AxelVoitier/keebs/Handy/README.md

# Handy

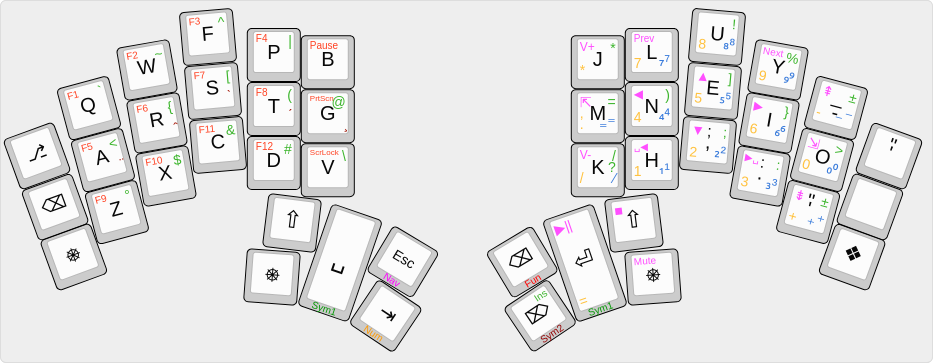
[picture p17: Handy/Handy layout.png]
Handy layout


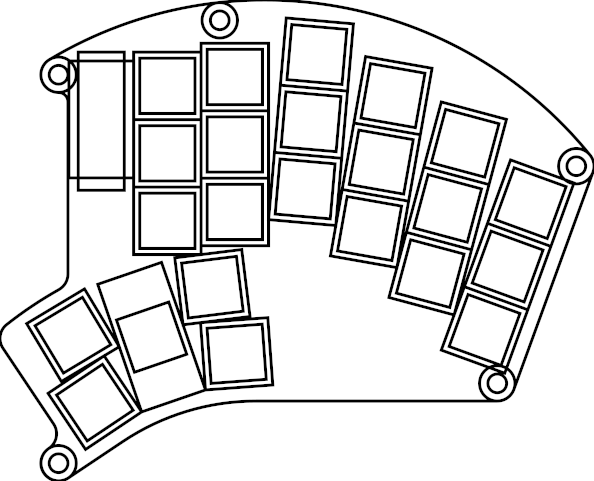
[picture p18: Handy/Handy design.png]
Handy design
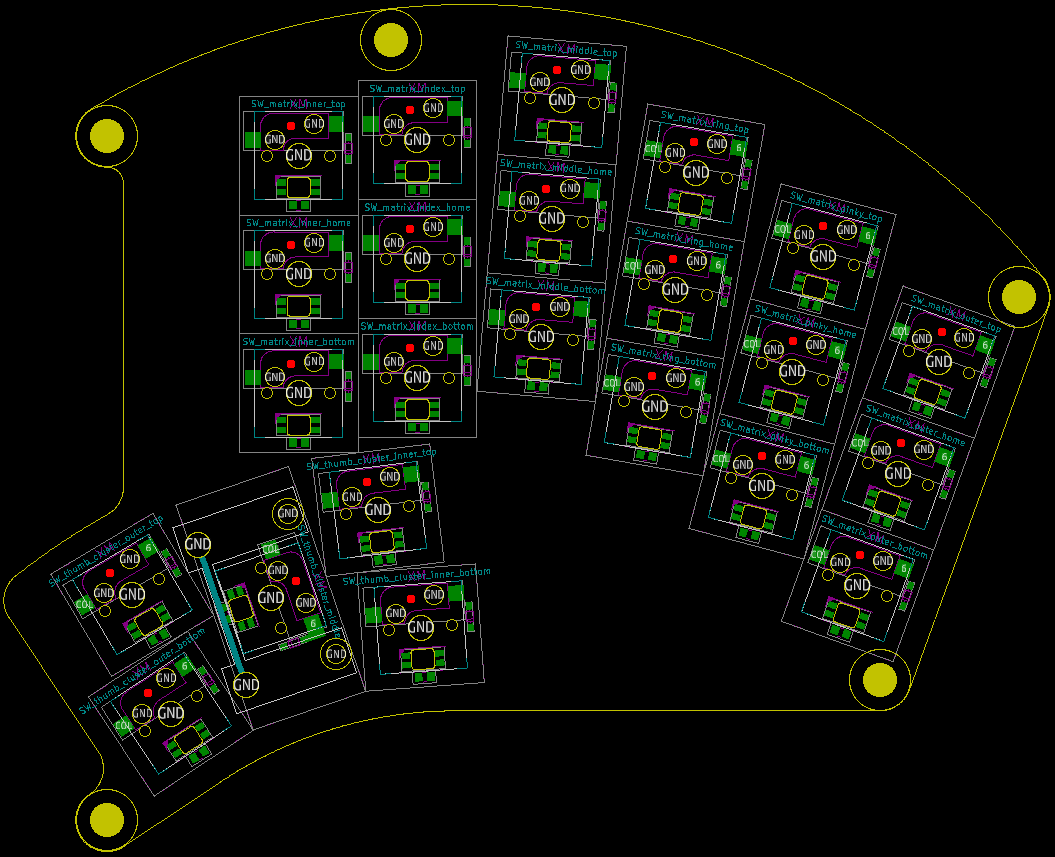
[picture p19: Handy/Handy-PCB.png]
Handy PCB
 

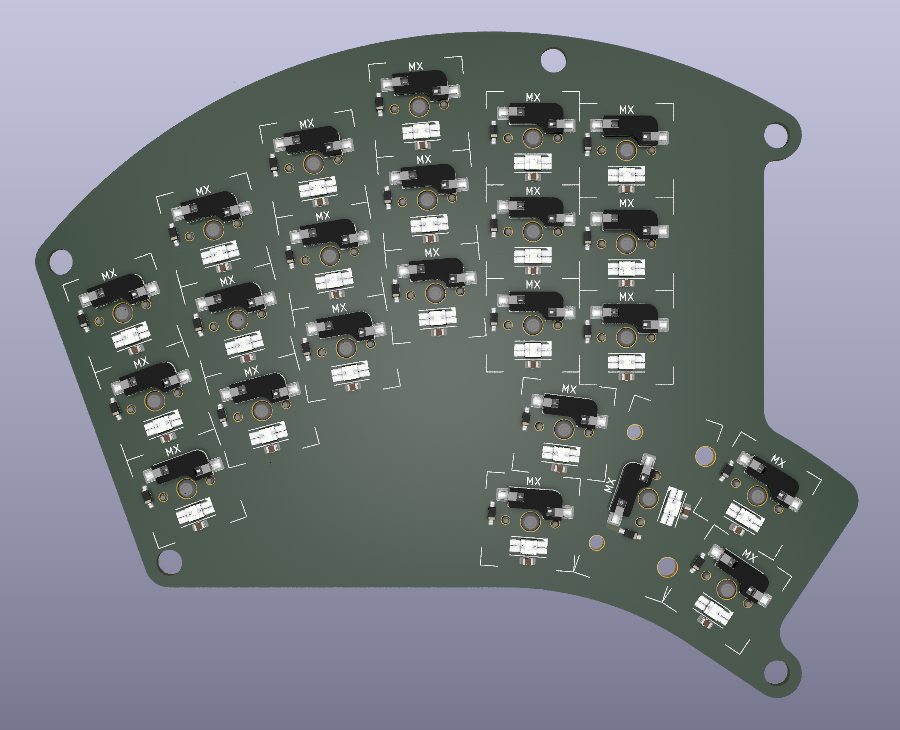
[picture p20: Handy/Handy-PCB-3d-bottom.png]
Handy PCB 3D bottom
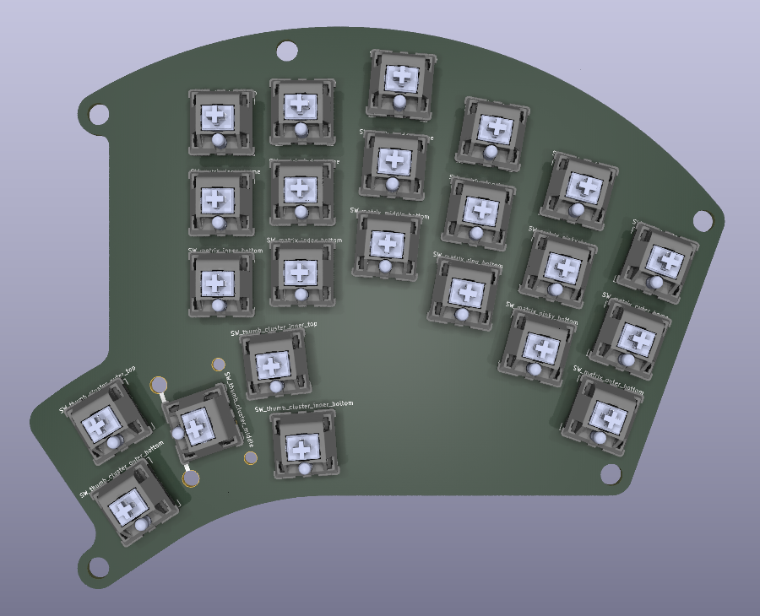
[picture p21: Handy/Handy-PCB-3d-top.png]
Handy PCB 3D top
 

This is a split keyboard with the following properties:

- 3*6 alphas matrices
- Splayed middle, ring, pinky and outer columns (5-10-15-20 in absolute angles, or 5-5-5-5 in relative (ie. stacked) angles)
- Angled thumb cluster, 2*3 with central/home being a 2u.
- Thumb home is below the inner alphas column, slightly outward
- ~~Navigation clusters, 1-2-1 "cross", on both sides~~ (Removed as I found it confusing and ugly, see old layout [here](Handy%20layout%20old%20nav%20cluster.png))
- PCB, switch plate and bottom plate made using PCB fabs
- Tenting with either screws or [puck](https://splitkb.com/collections/keyboard-parts/products/tenting-puck)
- Hotswap support for MX or Choc v1 switches
- Support addressable LEDs
- Parametric and procedural design
  - Master design written with [ergogen](https://github.com/ergogen/ergogen/tree/master)
  - Custom scripting for:
    - Preprocessing some of the most complex points in ergogen master file
    - [KLE](http://www.keyboard-layout-editor.com/) layout
    - [KiCAD](https://www.kicad.org/) generation and update
    - [QMK](https://qmk.fm/) firmware generation
  - Low profile variant regenerated from scratch with Choc spacing

## Files

### Ergogen

- [Handy.yaml](Handy.yaml): Master design file, actually generated by merging these:
  - [Handy-01-layout.yaml](Handy-01-layout.yaml)
  - [Handy-02-fabrication.yaml](Handy-02-fabrication.yaml)
  - [Handy-03-keymap.yaml](Handy-03-keymap.yaml)
  - [Handy-04-firmware.yaml](Handy-04-firmware.yaml)
  - [Handy-05-preprocessed.yaml](Handy-05-preprocessed.yaml)
- [Handy design.png](Handy%20design.png): Design from ergogen
- [points.yaml](ergogen-output/points/points.yaml): Generated output
- [units.yaml](ergogen-output/points/units.yaml): Generated output

### Keyboard Layout Editor

- [Handy.json](Handy.json): Generated from master ergogen file
- [Handy layout.png](Handy%20layout.png): Layout image generated by KLE
- [Handy layout old nav cluster.png](Handy%20layout%20old%20nav%20cluster.png): Older layout using a nav cluster

### KiCad

- [Handy PCB project](PCB): Generated in most parts, rest (eg. routing) is manual
- [Ergogen.pretty](Ergogen.pretty): Outlines generated by Ergogen and converted into footprints by scripts
- [../Footprints.pretty](../Footprints.pretty): Other footprints used in this project

### Custom scripting

- [../keebs.py](../keebs.py): Python CLI, main entry
- [../ergogen.py](../ergogen.py): Parsing of Ergogen input and output files
- [../kicad.py](../kicad.py): Parser, generator and updater of KiCAD board, footprints, schematics, and other files
- [../kle.py](../kle.py): Generator for KLE JSON file
- [../qmk.py](../qmk.py): Generator for QMK info and keymap files
