AxelVoitier/keebs/Framework/HandyWork-5x3-with-mods-with-nav/README.md

# HandyWork 5x3 with modifier keys and central navigation keys

## Example keymap

Example QWERTY keymap

With layers:
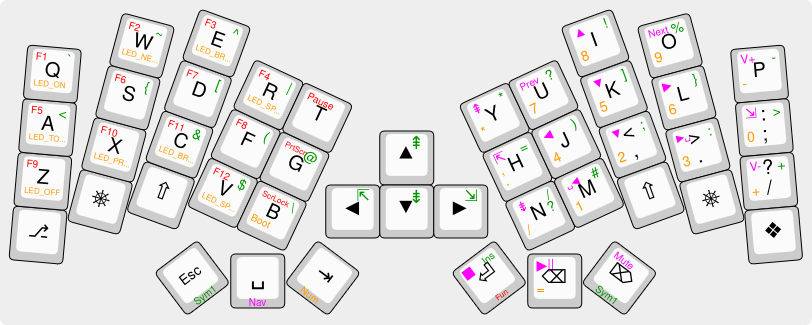
[picture p22: Framework/HandyWork-5x3-with-mods-with-nav/HandyWork-5x3-with-mods-with-nav-keymap-full.png]
Example QWERTY keymap full


## Physical layout

[Printable test layout](HandyWork-5x3-with-mods-with-nav-layout.pdf)

Fits Framework 16 A1 design space.



## PCB

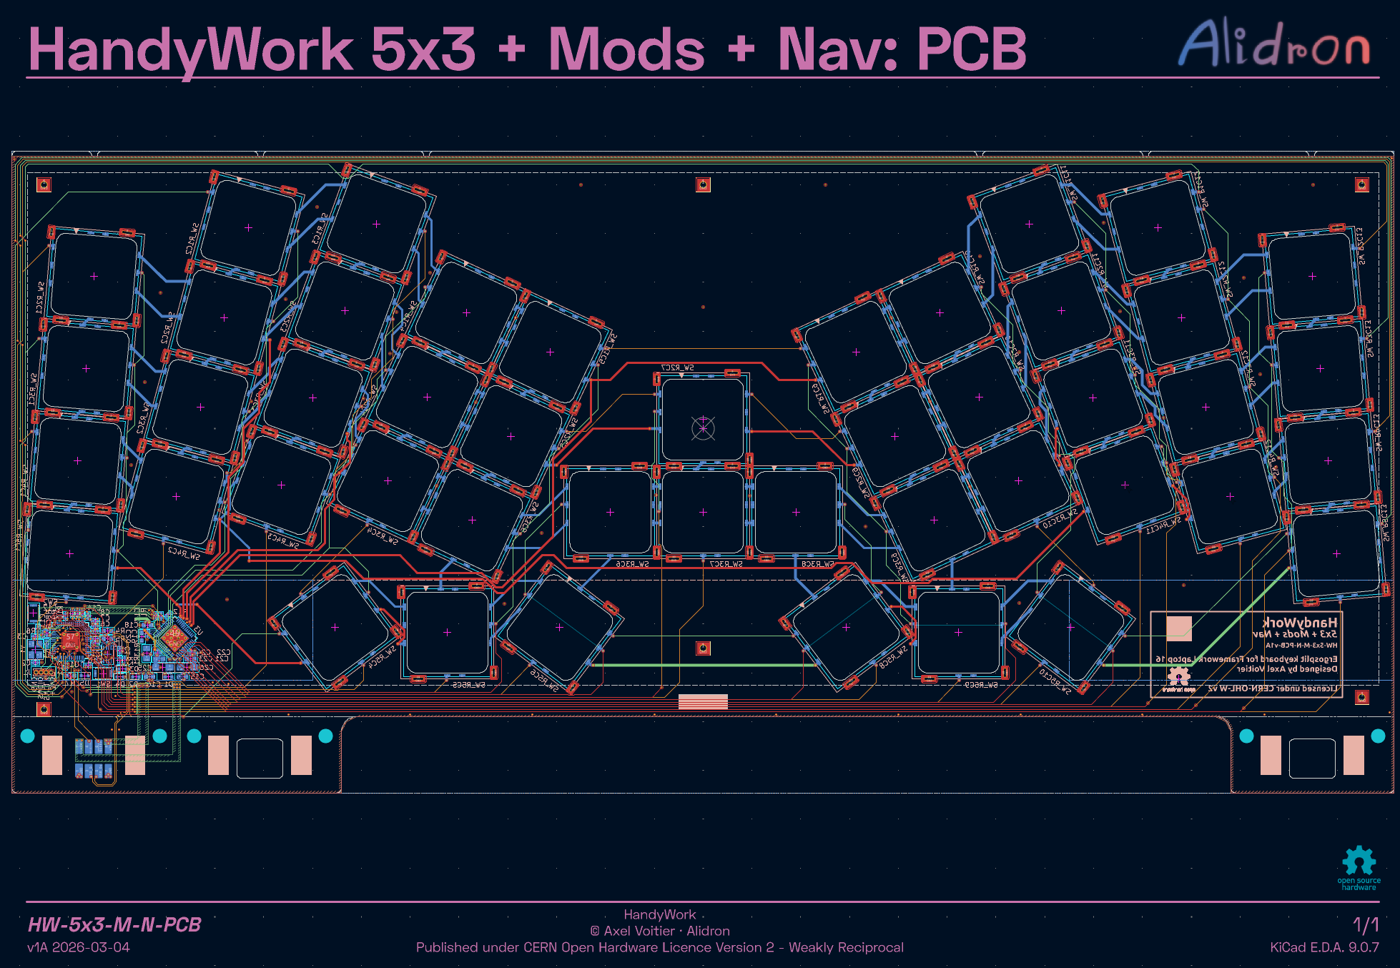
[picture p23: Framework/HandyWork-5x3-with-mods-with-nav/HandyWork-5x3-with-mods-with-nav-PCB 01.png]


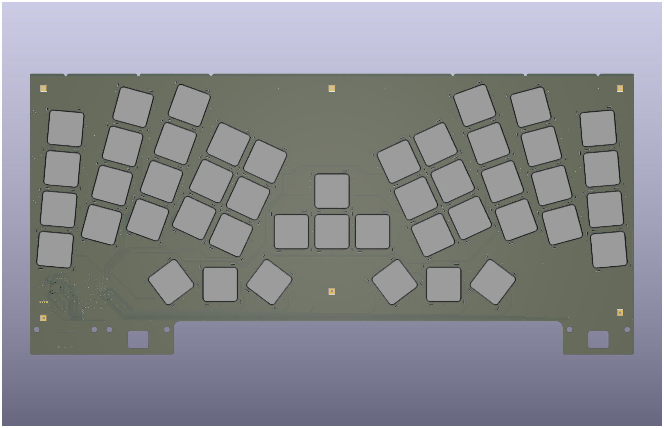
[picture p24: Framework/HandyWork-5x3-with-mods-with-nav/HandyWork-5x3-with-mods-with-nav-PCB 02.png]


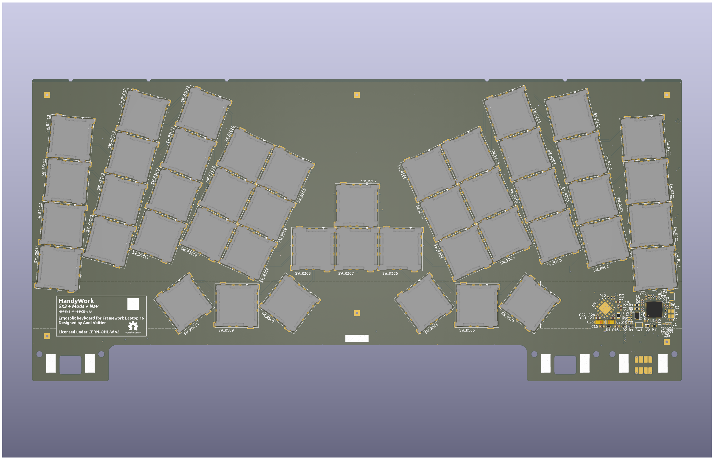
[picture p25: Framework/HandyWork-5x3-with-mods-with-nav/HandyWork-5x3-with-mods-with-nav-PCB 03.png]


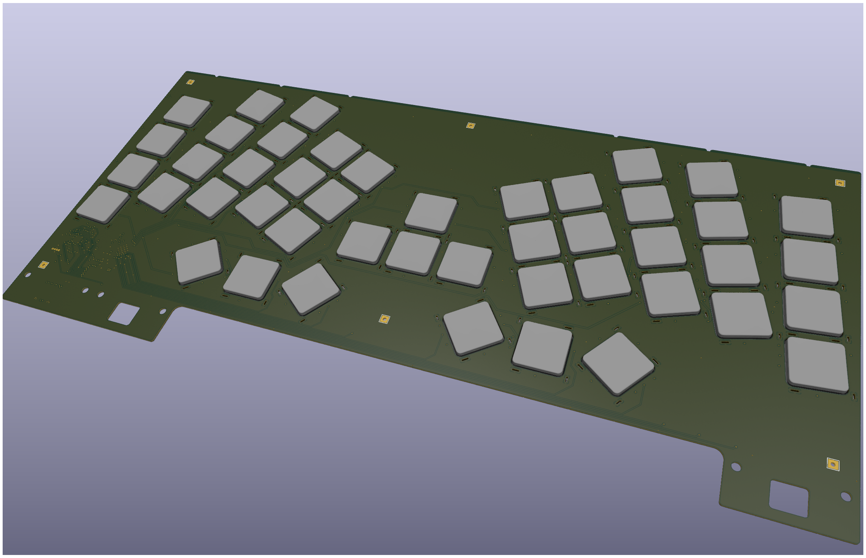
[picture p26: Framework/HandyWork-5x3-with-mods-with-nav/HandyWork-5x3-with-mods-with-nav-PCB 04.png]


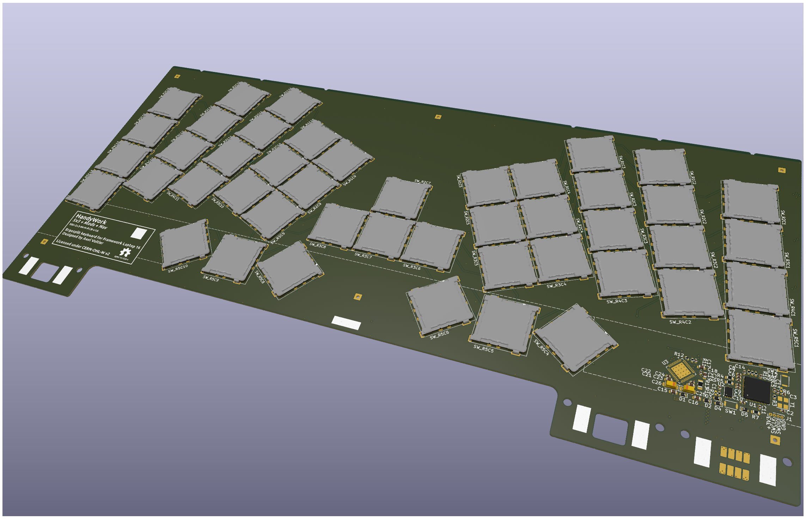
[picture p27: Framework/HandyWork-5x3-with-mods-with-nav/HandyWork-5x3-with-mods-with-nav-PCB 05.png]


## Ordering yourself for production

The parameters and order flow are described on the [v1A tag](https://github.com/AxelVoitier/keebs/releases/tag/HandyWork-5x3-Mods-Nav-v1A) itself

## Firmware

The generated firmware currently lives [there](https://github.com/AxelVoitier/qmk_firmware/tree/axel/handywork/keyboards/handywork/5x3_mods_nav).
