AxelVoitier/keebs/Framework/Kicad templates/README.md

# Templates for HandyWork keyboards

## PCB Template

An A1 board with prerouted RPI2040 and matrix LED driver.

All key wires (column, rows, and CS/SW for individual LED control) are fan out around the board to strategic places following a guideline grid of 5x13.

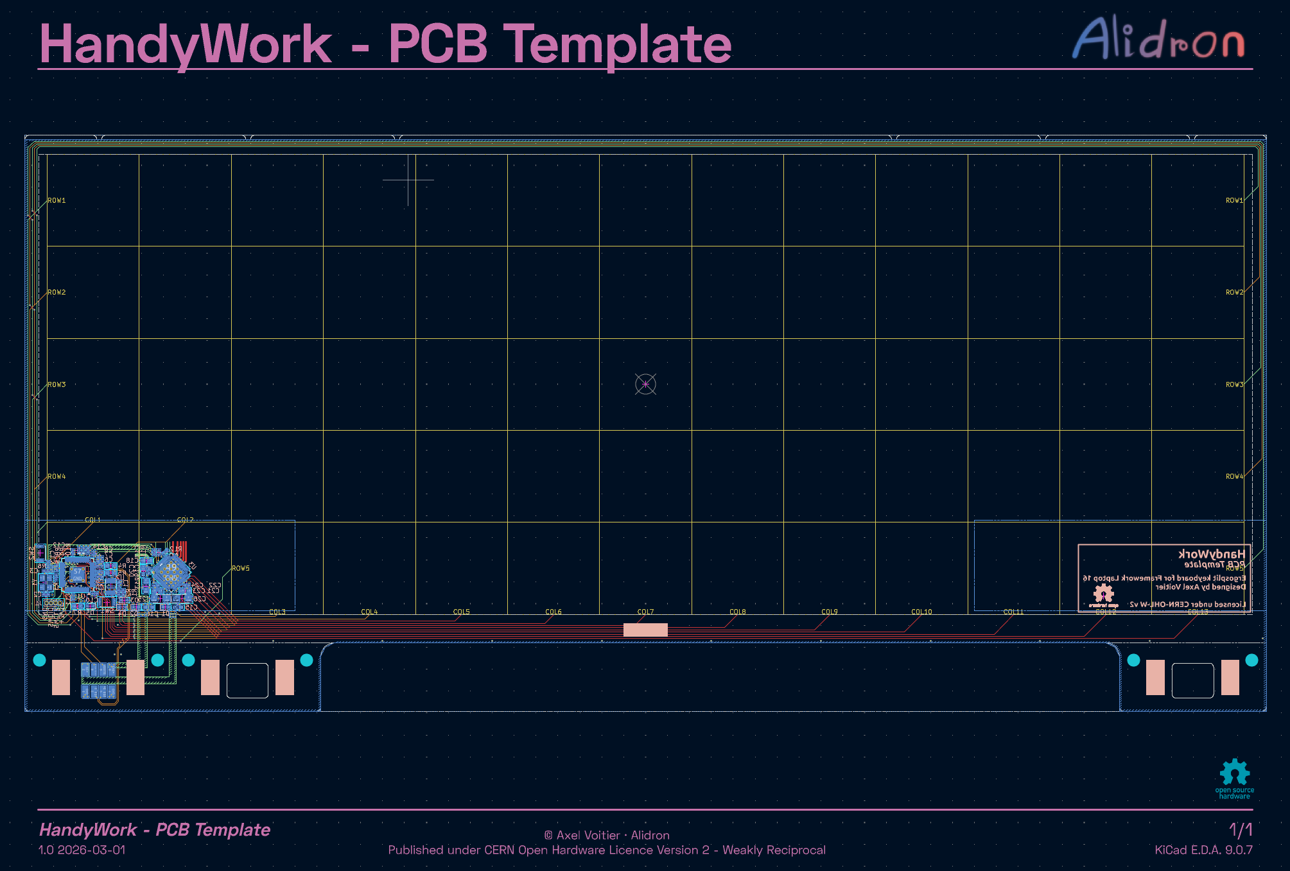
[picture p28: Framework/Kicad templates/PCB 01.png]


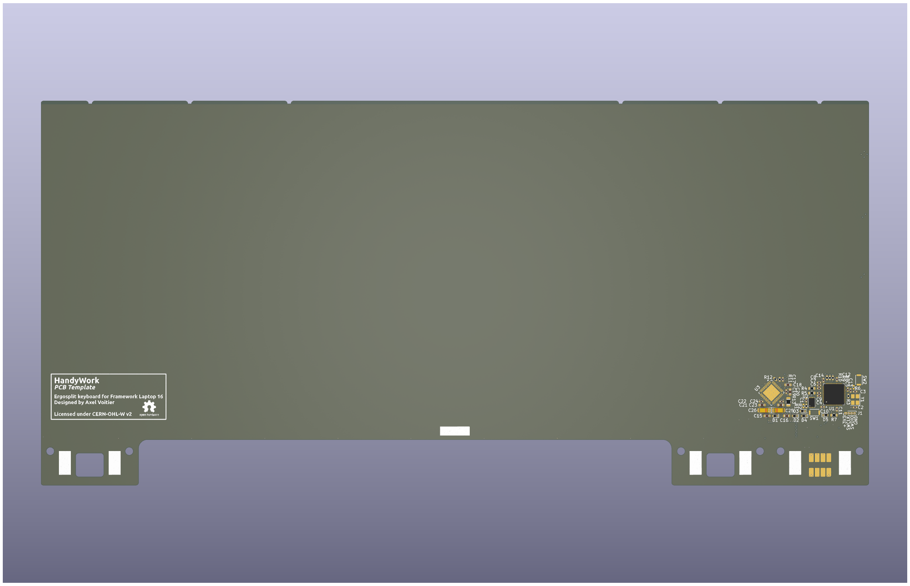
[picture p29: Framework/Kicad templates/PCB 02.png]


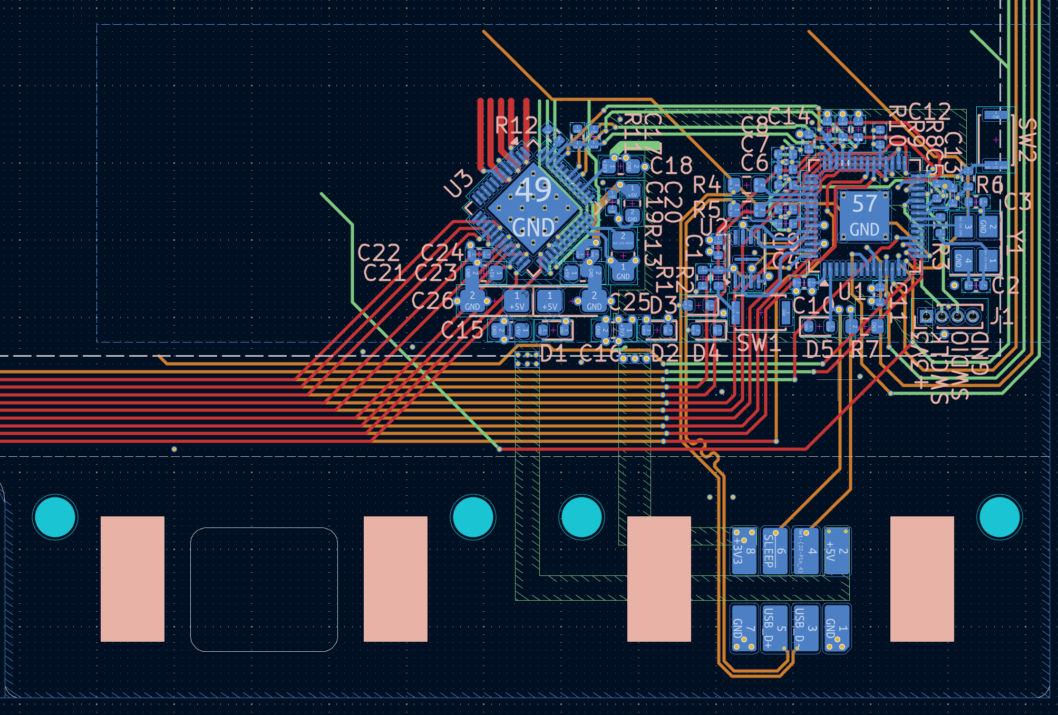
[picture p30: Framework/Kicad templates/PCB 03.png]


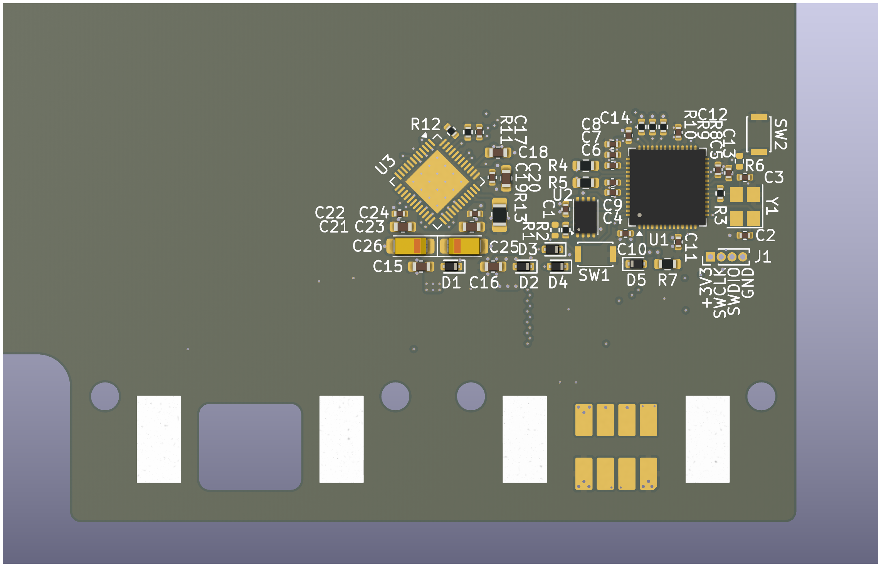
[picture p31: Framework/Kicad templates/PCB 04.png]
