AxelVoitier/keebs/Framework/HandyWork-5x3-with-mods/README.md

# HandyWork 5x3 with modifier keys

## Example keymap



## Physical layout

[Printable test layout](HandyWork-5x3-with-mods-layout.pdf)

Fits Framework 16 A1 design space.
