AxelVoitier/keebs/Framework/HandyWork-5x3/README.md

# HandyWork 5x3

## Example keymap



## Physical layout

[Printable test layout](HandyWork-5x3-layout.pdf)

Fits Framework 16 A1 design space.
