AxelVoitier/keebs/Framework/HandyWork-5x4-with-nav/README.md

# HandyWork 5x4 with central navigation keys

## Example keymap



## Physical layout

[Printable test layout](HandyWork-5x4-with-nav-layout.pdf)

Fits Framework 16 A1 design space.
