AxelVoitier/keebs/Framework/HandyWork-5x4/README.md

# HandyWork 5x4

## Example keymap



## Physical layout

[Printable test layout](HandyWork-5x4-layout.pdf)

Fits Framework 16 A1 design space.
