AxelVoitier/keebs/Framework/HandyWork-6x3/README.md

# HandyWork 6x3

## Example keymap



## Physical layout

[Printable test layout](HandyWork-6x3-layout.pdf)

Fits Framework 16 A1 design space.
