AxelVoitier/keebs/Framework/HandyWork-6x4/README.md

# HandyWork 6x4

## Example keymap



## Physical layout

[Printable test layout](HandyWork-6x4-layout.pdf)

Fits Framework 16 A1 design space.
