AxelVoitier/keebs/Lergo/BottomPlate/README.md

# Lergo bottom plate

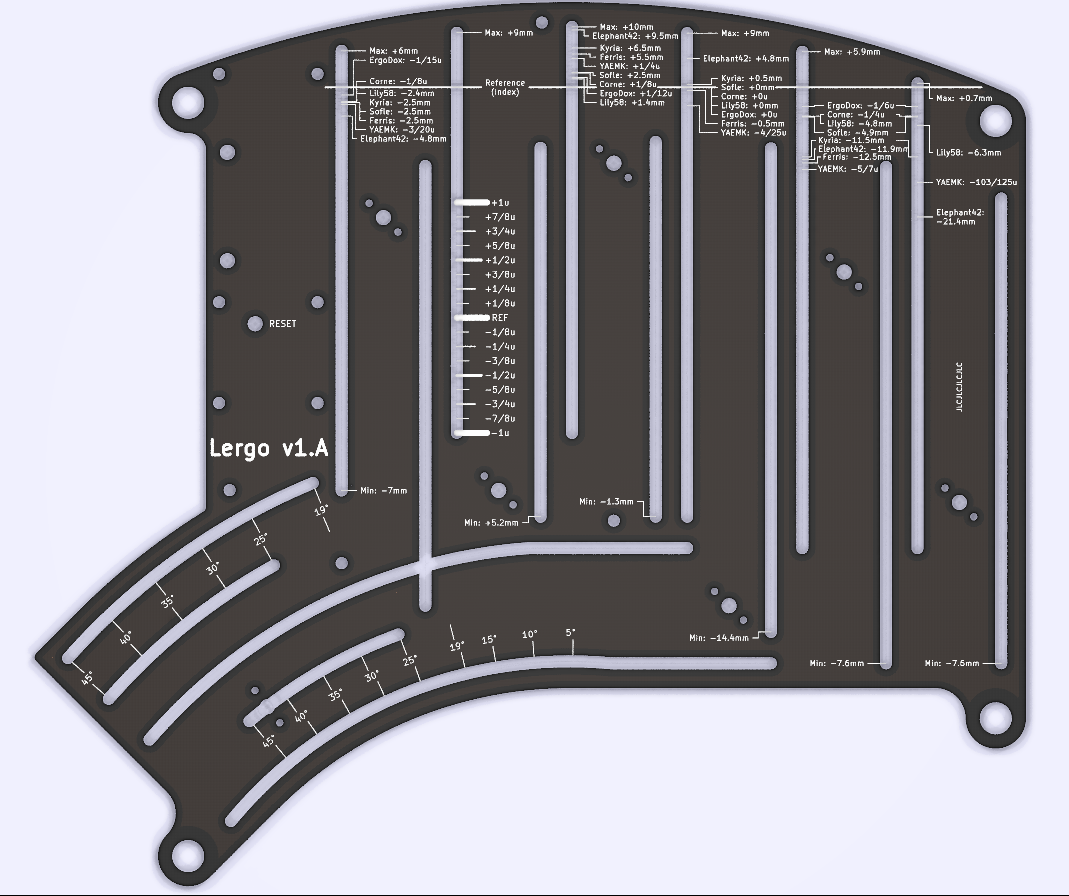
[picture p32: Lergo/BottomPlate/images/LergoBottomPlate.png]
Overview


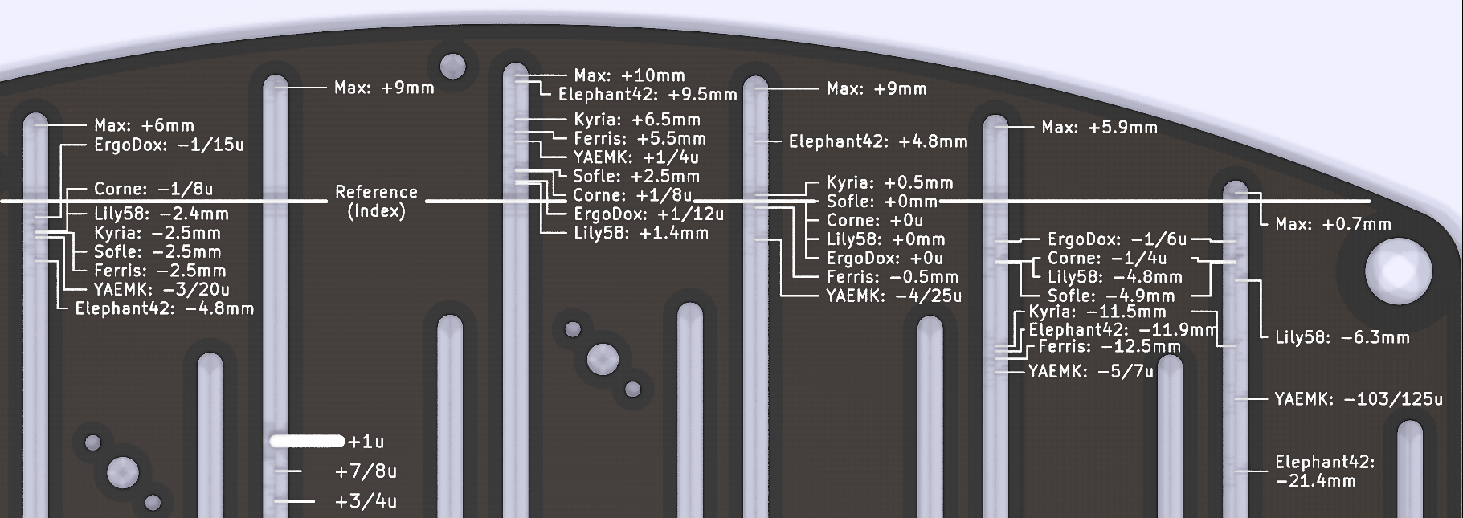
[picture p33: Lergo/BottomPlate/images/LergoBottomPlate-closeup1.png]
Top legends


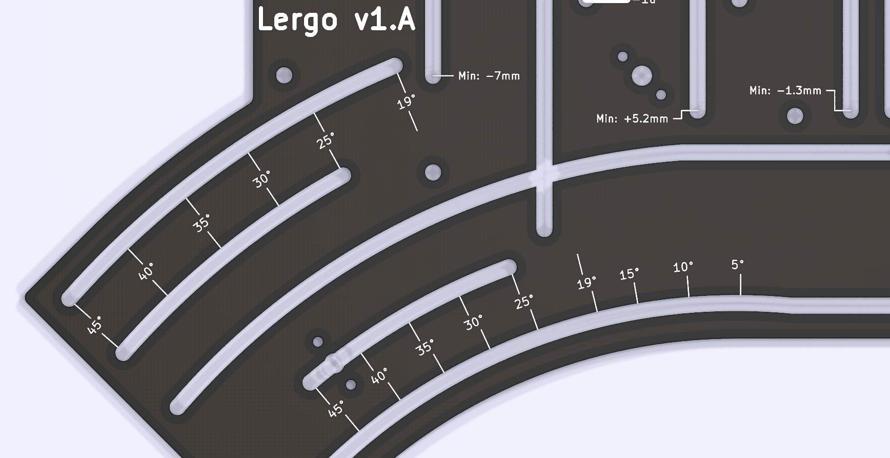
[picture p34: Lergo/BottomPlate/images/LergoBottomPlate-closeup2.png]
Thumb legends


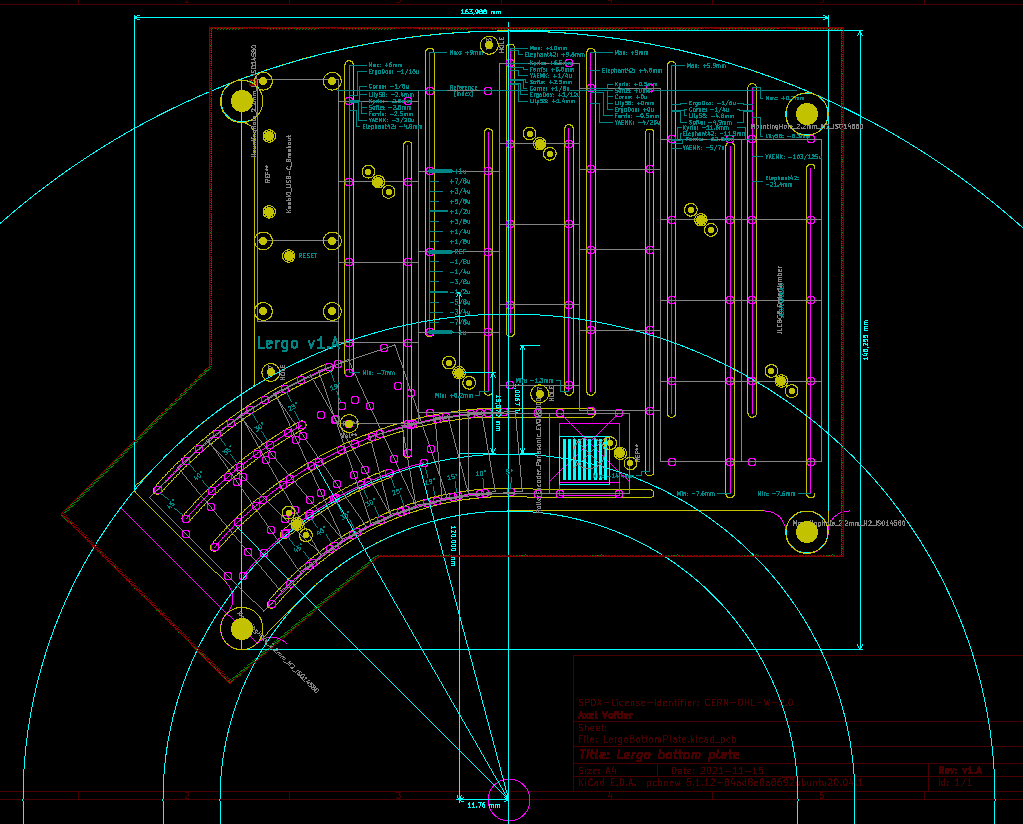
[picture p35: Lergo/BottomPlate/images/LergoBottomPlate-Construction.png]
Construction lines
