AxelVoitier/keebs/Lergo/PCB/README.md

# Lergo modular PCB

## Schematic
[Schematic PDF](Doc/Lergo-schematic.pdf)
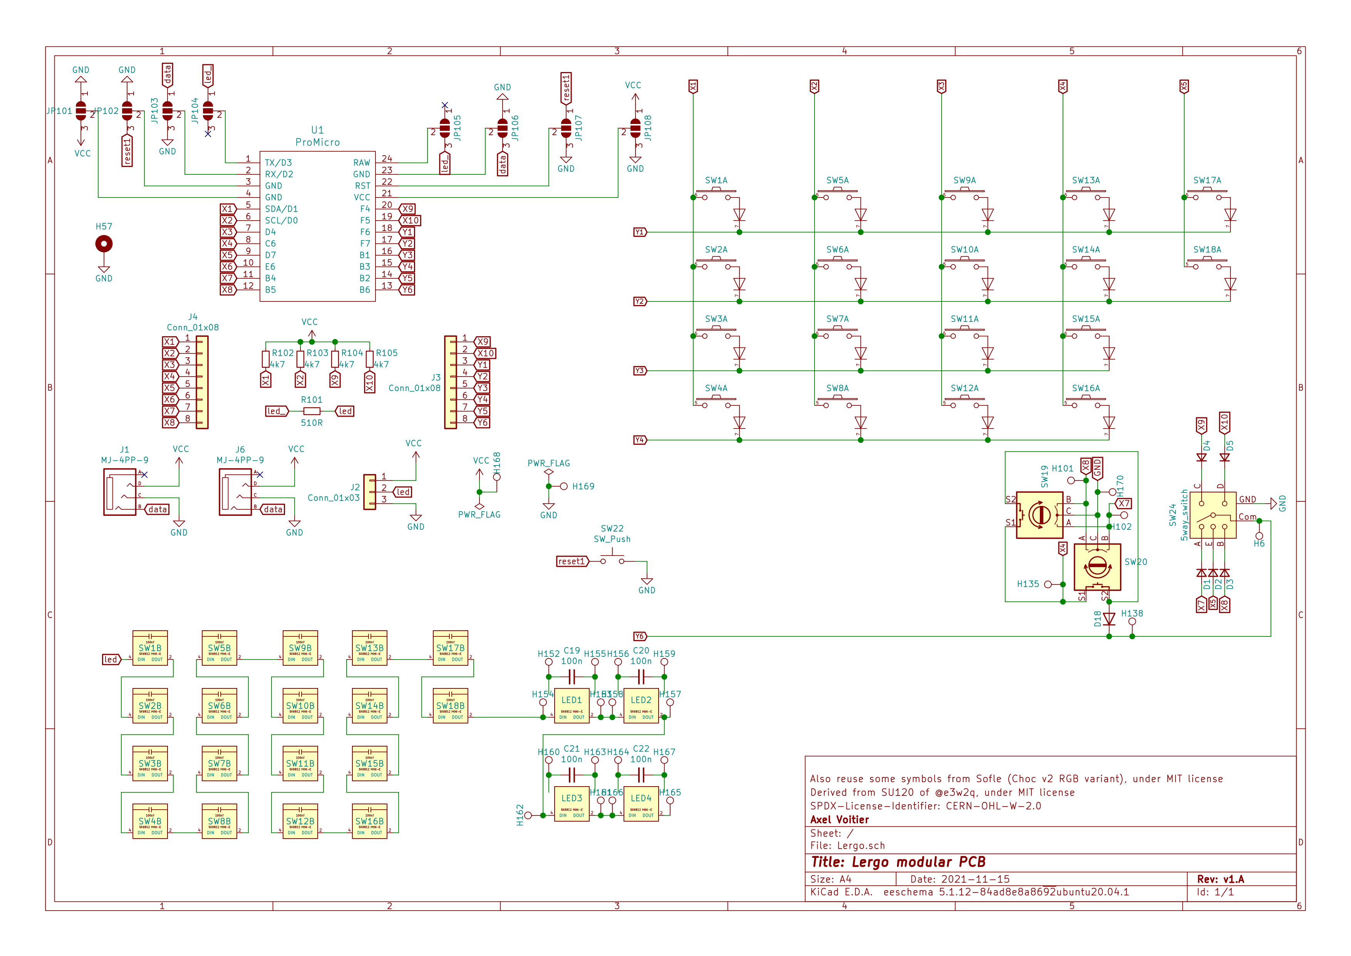
[picture p36: Lergo/PCB/images/Lergo-schematic.png]
Schematic


## PCB Layout
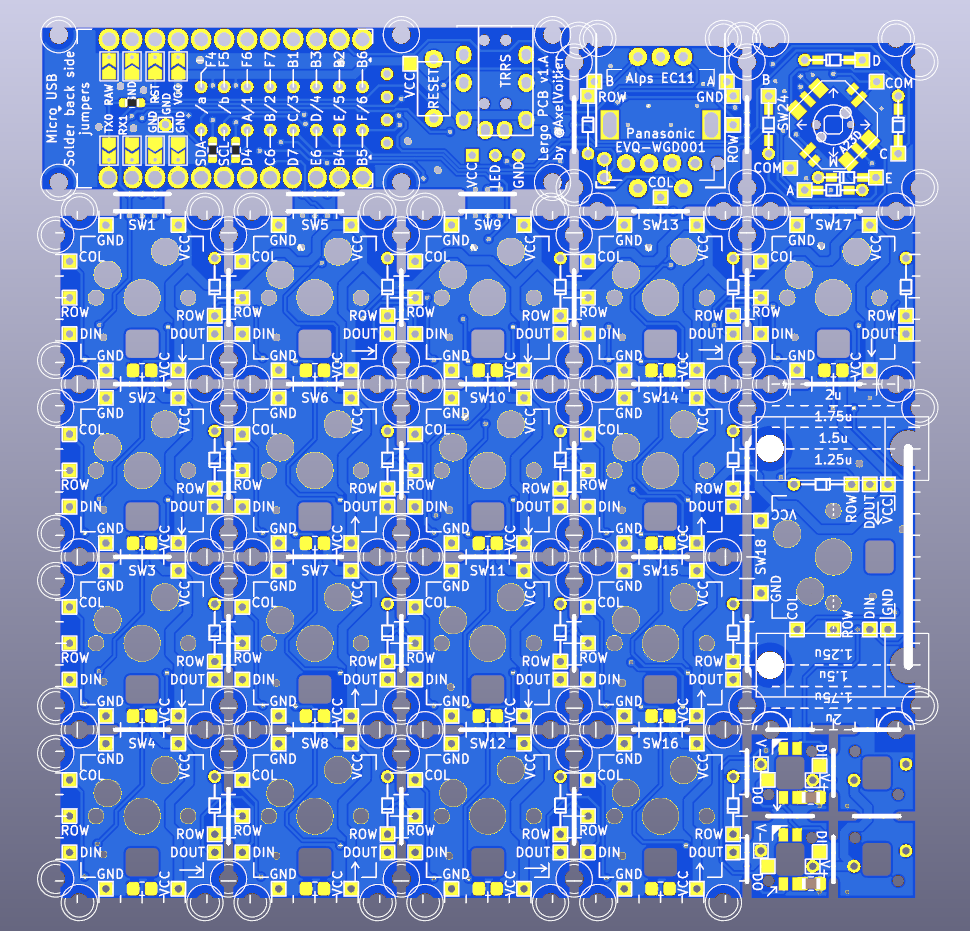
[picture p37: Lergo/PCB/images/Lergo-top-iso.png]
Top isometric view

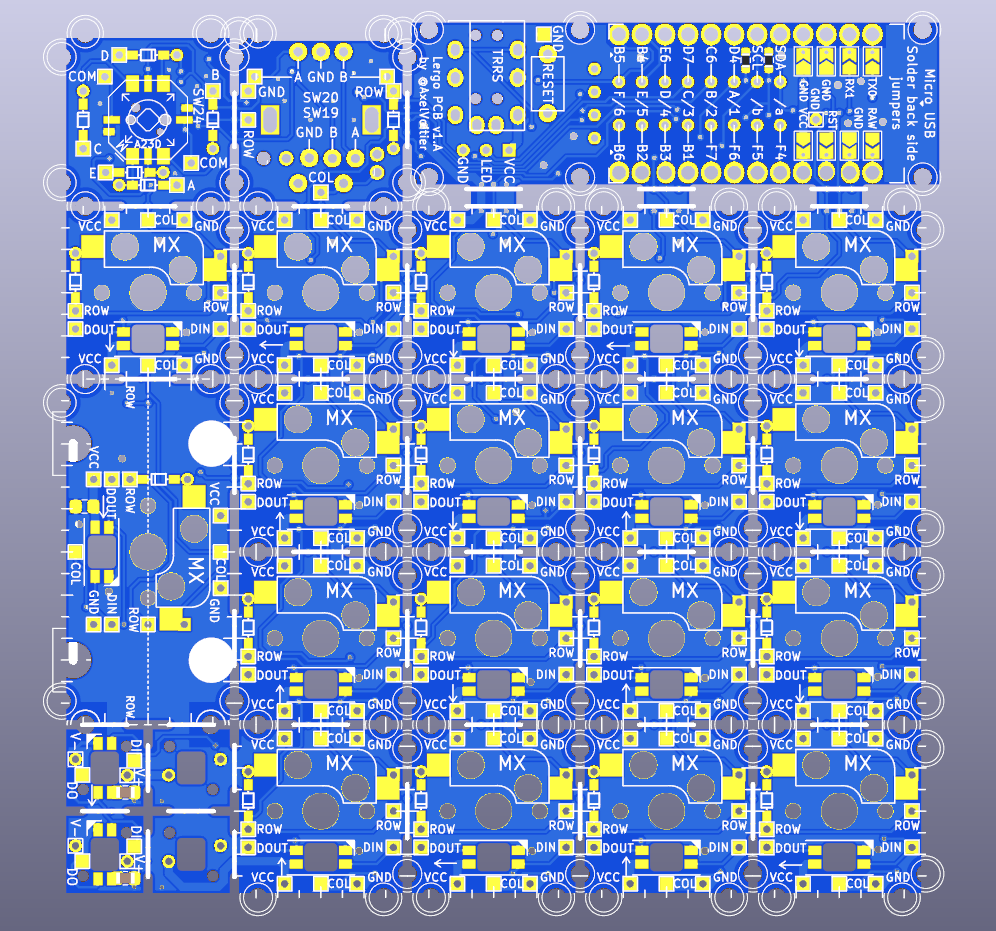
[picture p38: Lergo/PCB/images/Lergo-bottom-iso.png]
Bottom isometric view


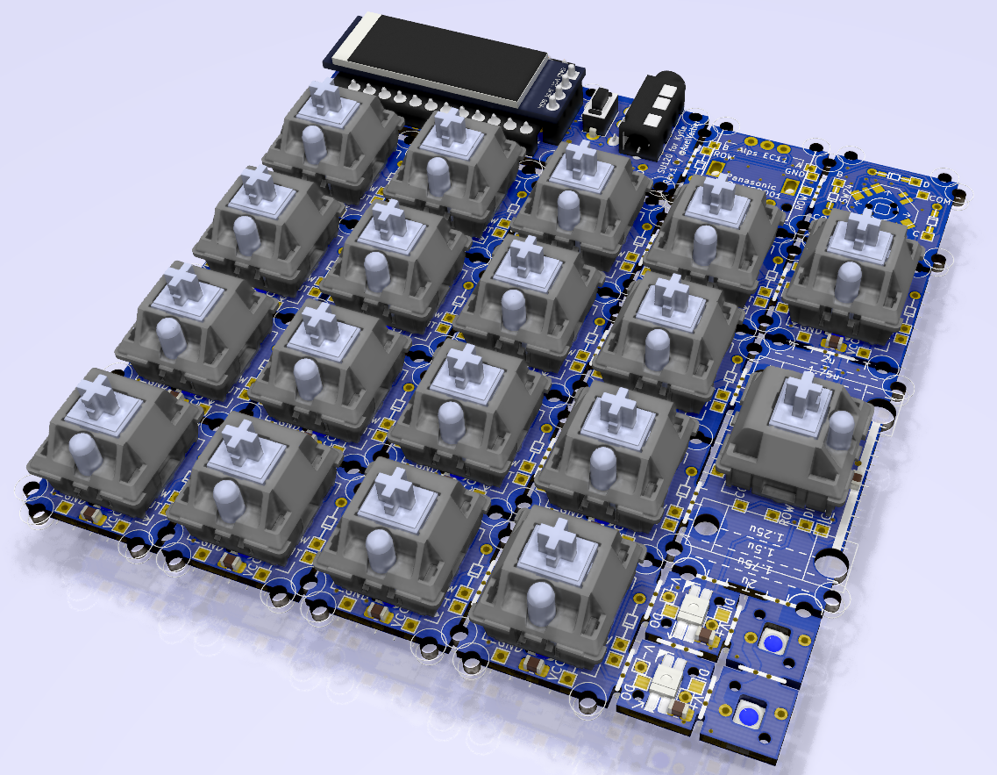
[picture p39: Lergo/PCB/images/Lergo-top.png]
Top 3D view


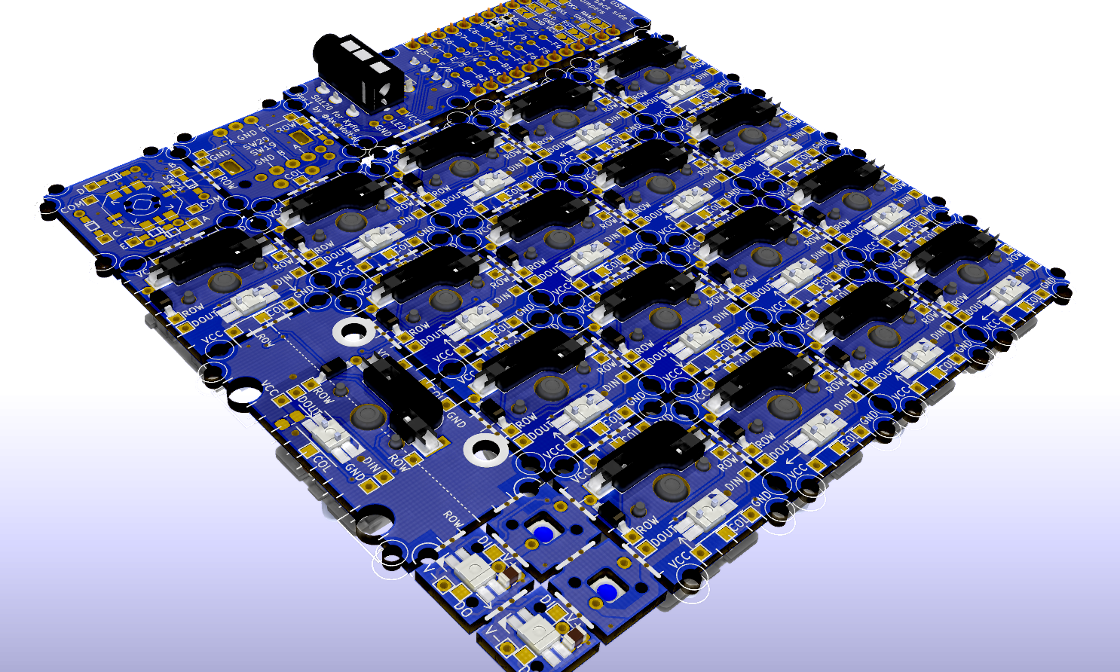
[picture p40: Lergo/PCB/images/Lergo-bottom.png]
Bottom 3D view

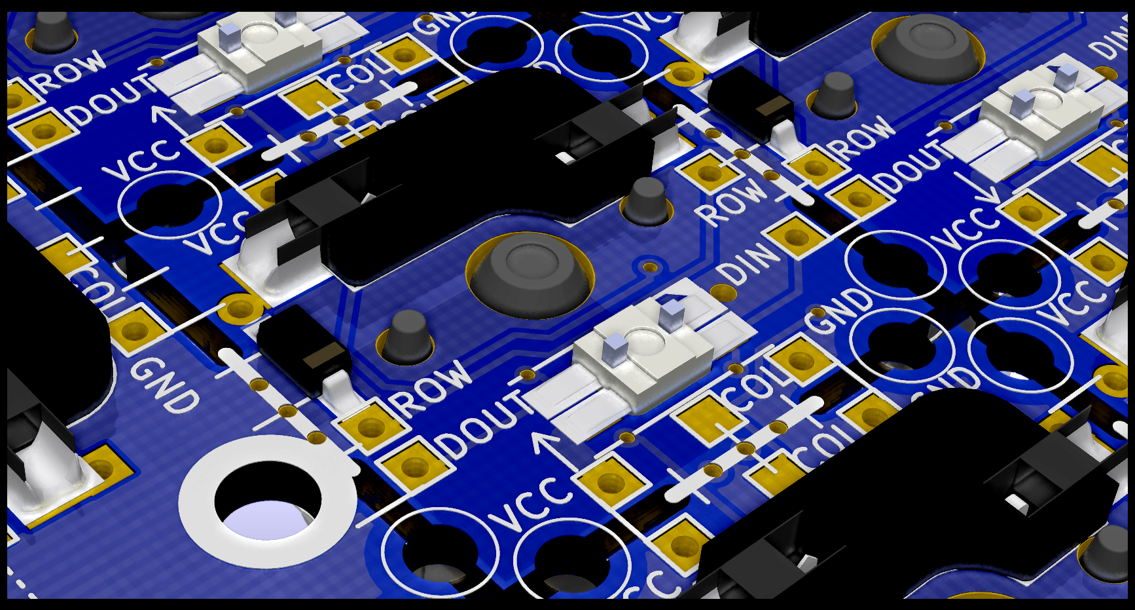
[picture p41: Lergo/PCB/images/Lergo-bottom-closeup.png]
Bottom 3D view closeup
