AxelVoitier/keebs/Lergo/TopPlate/README.md

# Lergo bottom plate

Default layout (Kyria-like) plate:
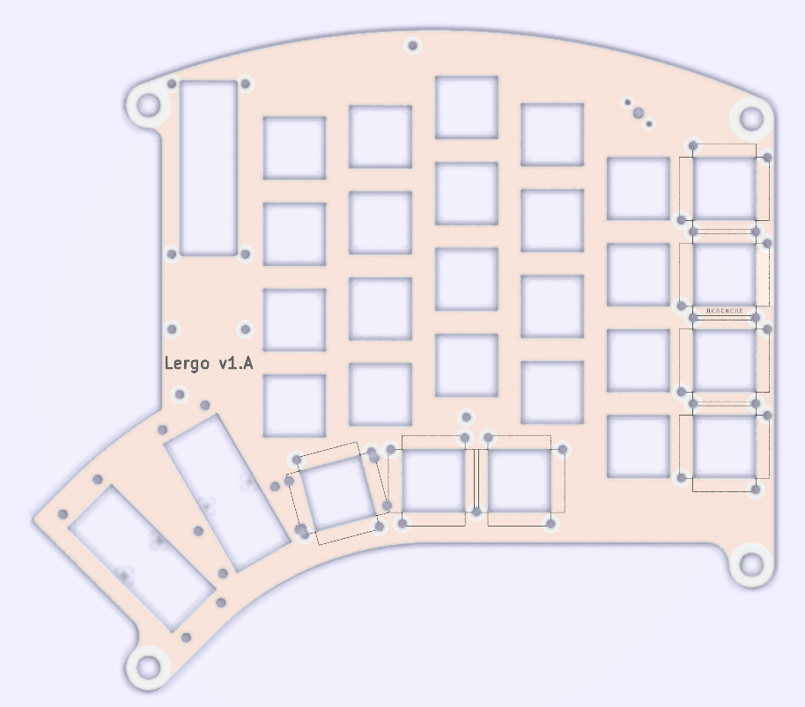
[picture p42: Lergo/TopPlate/images/LergoTopPlate_Alu.png]
Default full Alu


Same with routing optimisation:
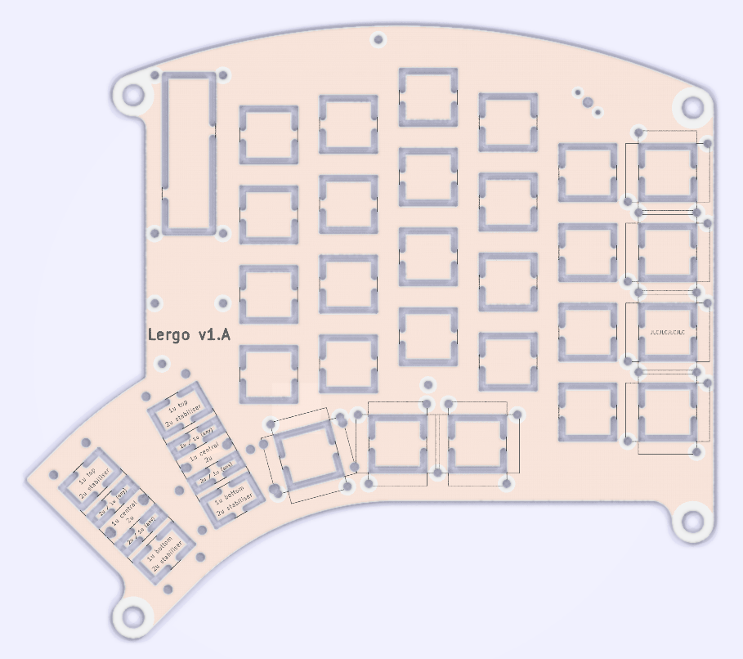
[picture p43: Lergo/TopPlate/images/LergoTopPlate_Alu_LessRouting.png]
Default less routing Alu


Flexible rails plate:
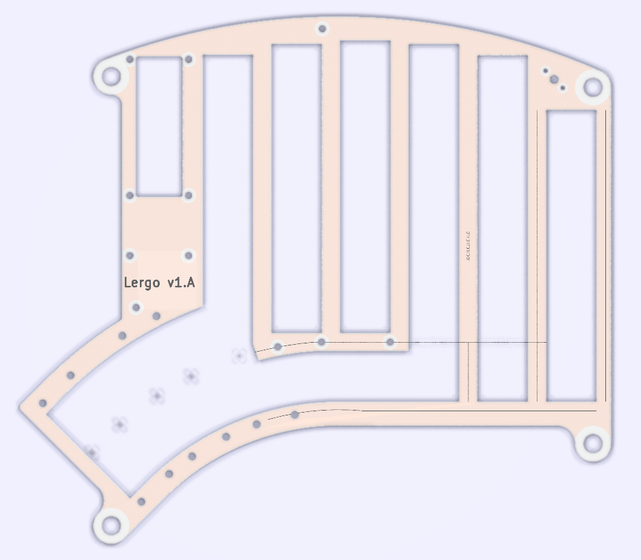
[picture p44: Lergo/TopPlate/images/LergoTopPlate_Alu_Rails.png]
Rails Alu


Same with routing optimisation:
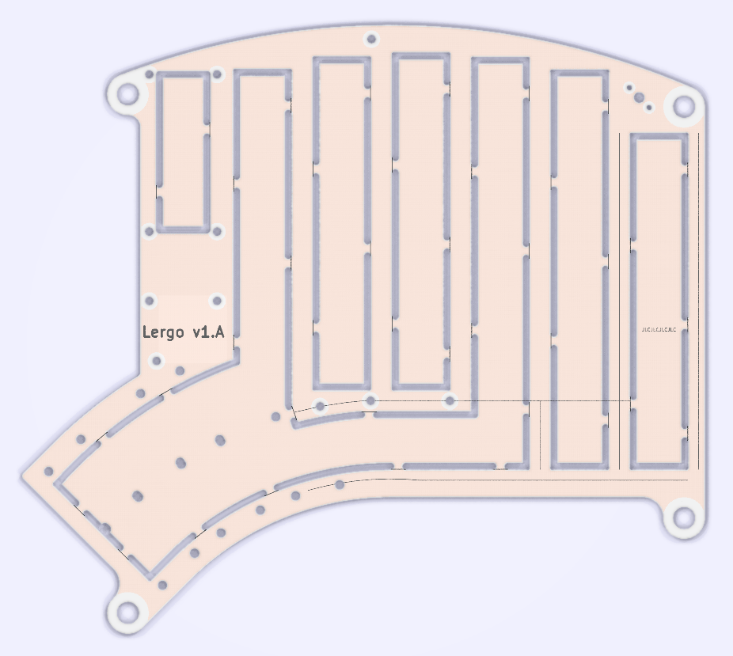
[picture p45: Lergo/TopPlate/images/LergoTopPlate_Alu_Rails_LessRouting.png]
Rails less routing Alu
