AxelVoitier/keebs/Lergo/PCB/images/Lergo-top-closeup.png

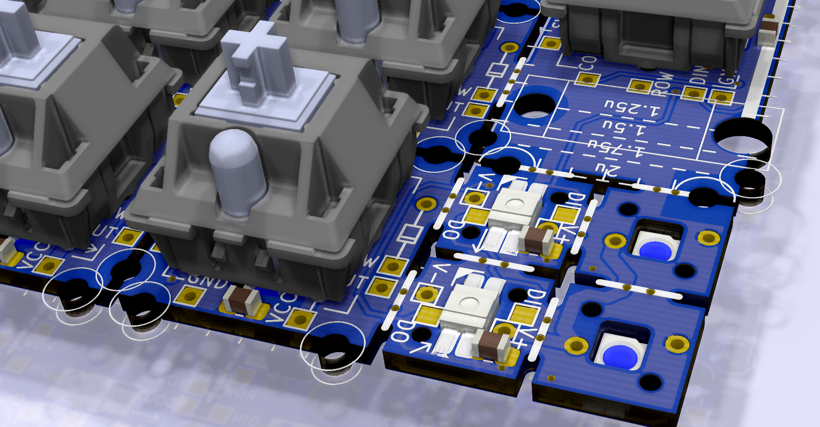
Lergo/PCB/images/Lergo-top-closeup.png
