AxelVoitier/keebs/Lergo/PCB/Doc/Lergo-schematic.pdf

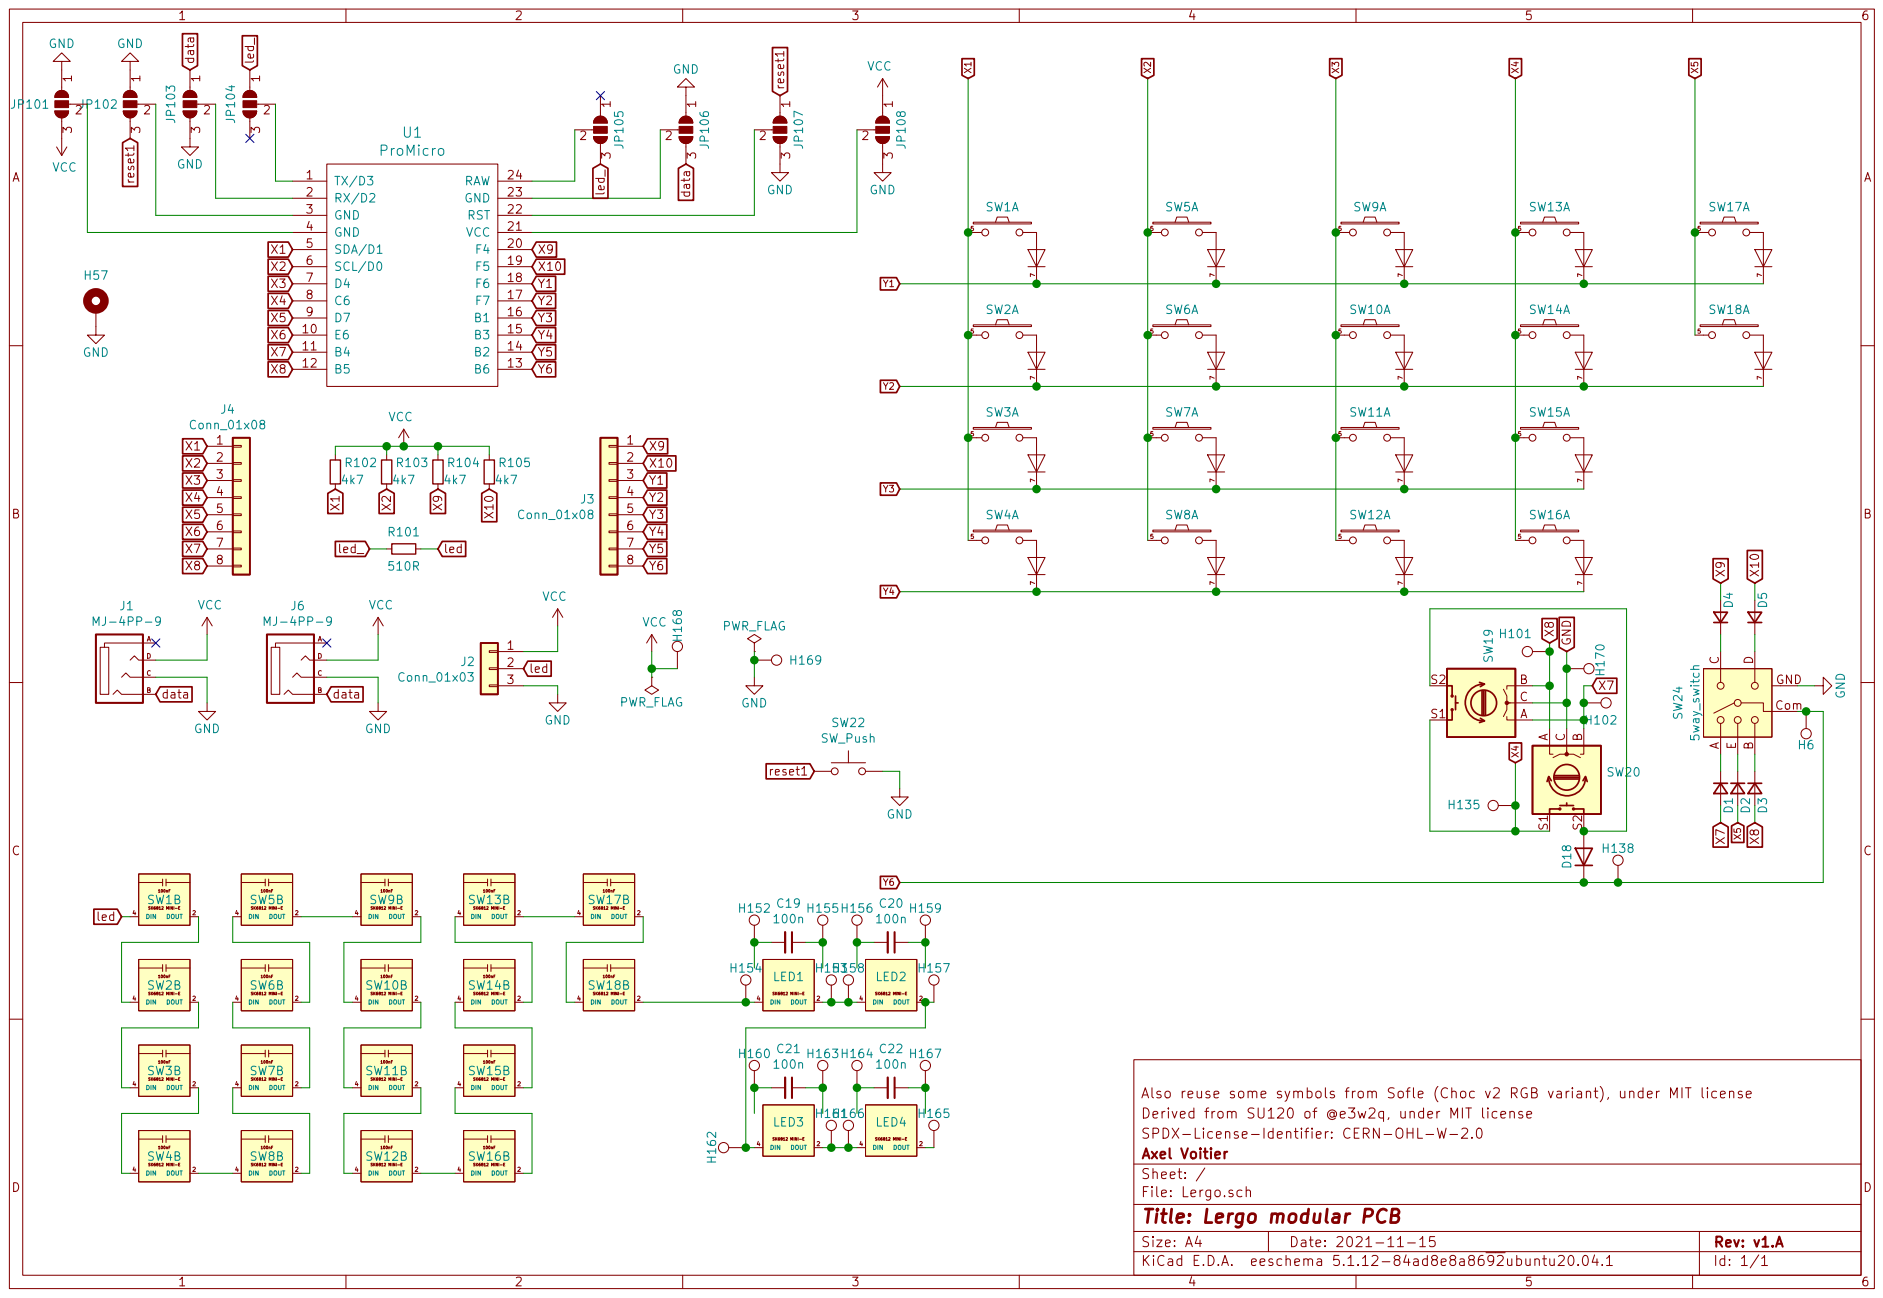
[picture p47: page 1]

3 JP108 GND VCC GND GND

Also reuse some symbols from Sofle (Choc v2 RGB variant), under MIT license H159

File: Lergo.sch Sheet: / Axel Voitier SPDX-License-Identifier: CERN-OHL-W-2.0 Derived from SU120 of @e3w2q, under MIT license

Id: 1/1 Title: Lergo modular PCB
