AxelVoitier/keebs/Framework/Kicad templates/PCB/HandyWork-PCB.kicad_pcb

## KiCad design Framework/Kicad templates/PCB/HandyWork-PCB.kicad_pcb (2026-03-04)

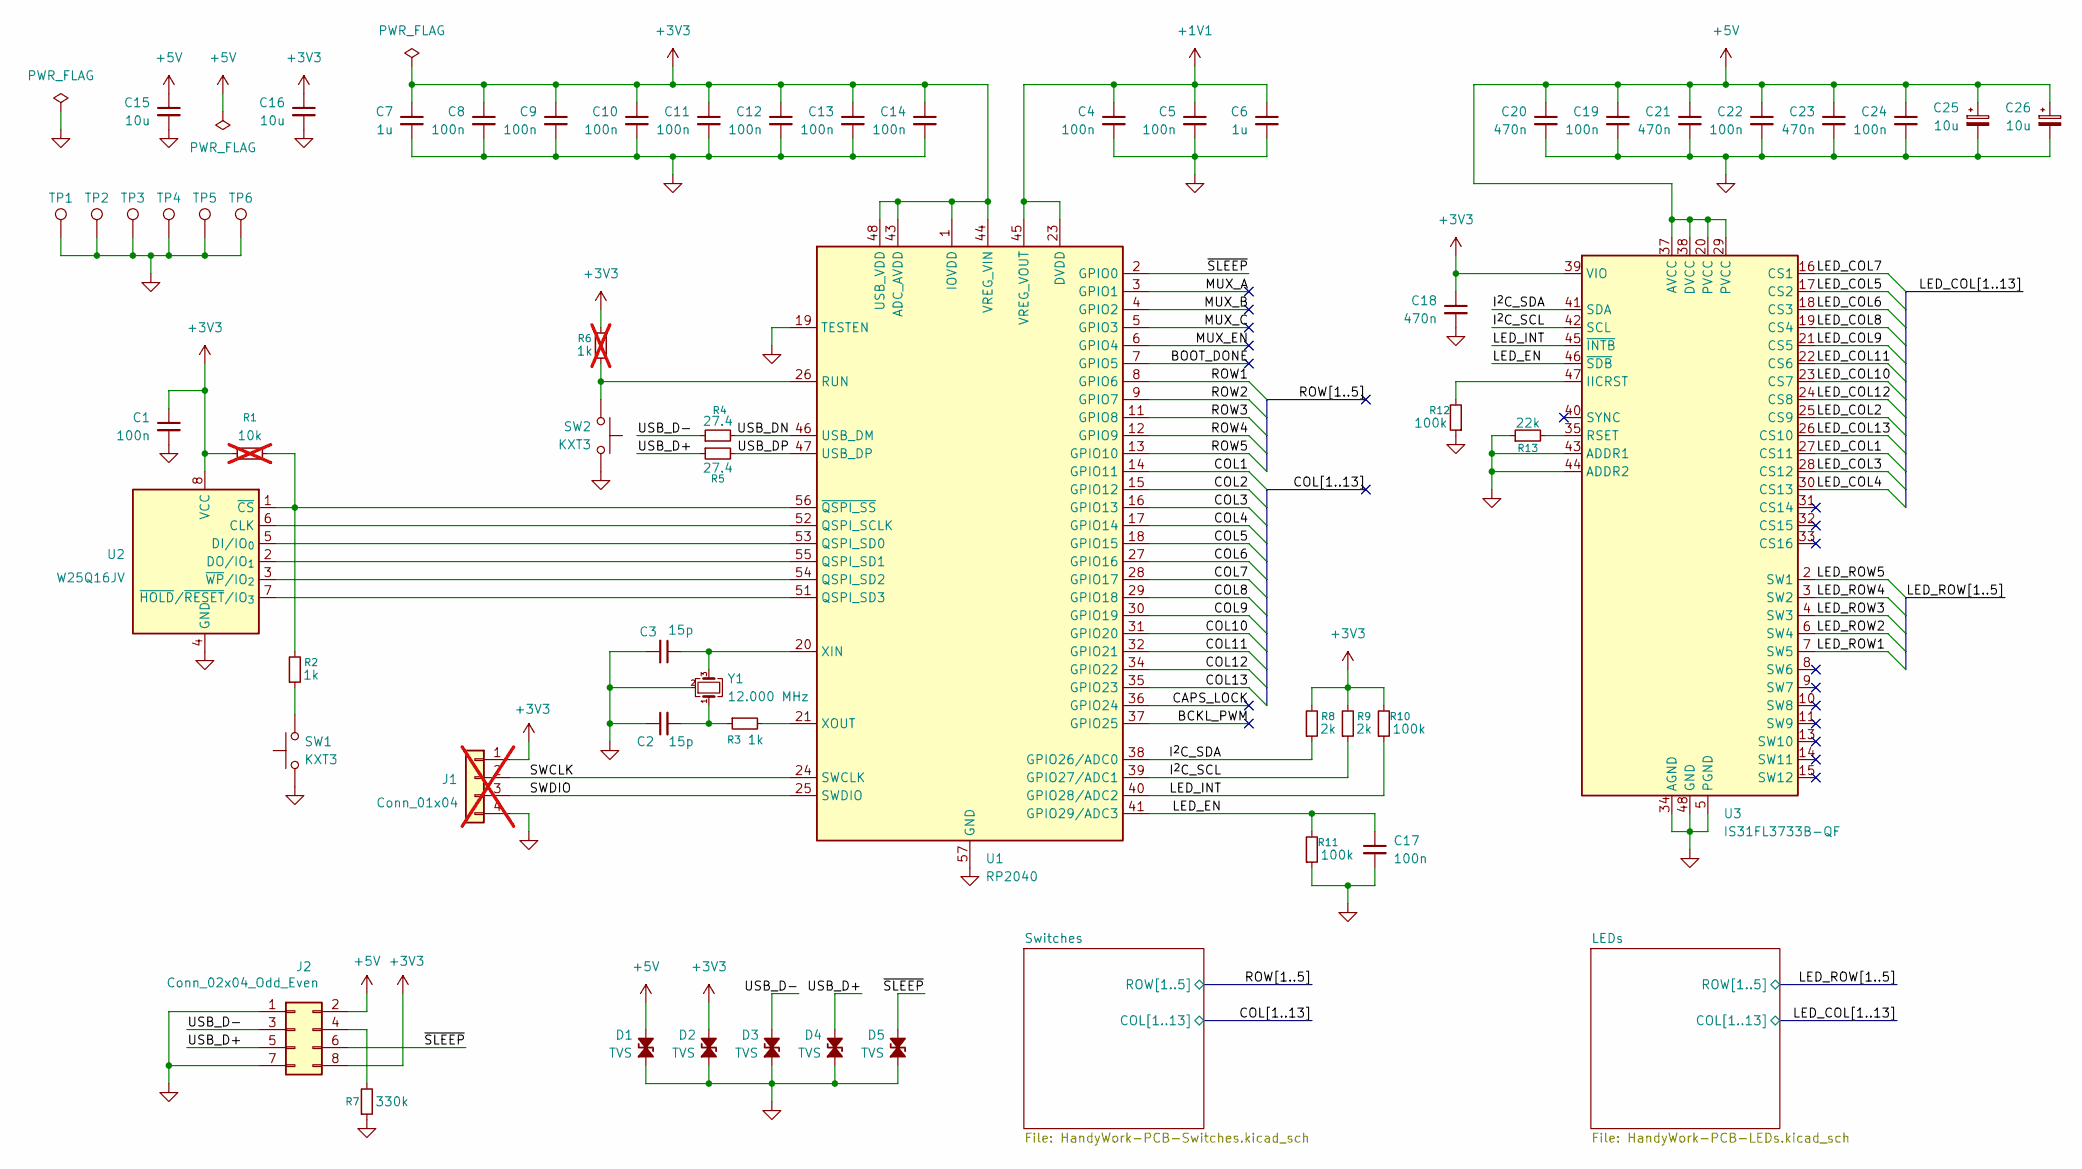
[picture p48: schematic HandyWork-PCB.kicad_sch, HandyWork - PCB Template]

Parts:
C1, C4, C5, C8, C9, C10, C11, C12, C13, C14, C17, C19, C22, C24: 100n; C_0402_1005Metric; LCSC C1525
C2, C3: 15p; C_0402_1005Metric; LCSC C1548
C6, C7: 1u; C_0402_1005Metric; LCSC C52923
C15, C16: 10u; C_0603_1608Metric; LCSC C19702
C18, C20, C21, C23: 470n; C_0603_1608Metric; LCSC C1623
C25, C26: 10u; CP_EIA-3216-18_Kemet-A_HandSolder; LCSC C7171
D1, D2, D3, D4, D5: TVS; D_SOD-523; LCSC C20615820
J1: Conn_01x04; PinHeader_1x04_P1.00mm_Vertical; not fitted
J2: Conn_02x04_Odd_Even; A1 Board PCB
R1: 10k; R_0402_1005Metric; LCSC C25744; not fitted
R2, R3: 1k; R_0402_1005Metric; LCSC C11702
R4, R5: 27.4; R_0603_1608Metric; LCSC C25190
R6: 1k; R_0402_1005Metric; LCSC C11702; not fitted
R7: 330k; R_0603_1608Metric; LCSC C23137
R8, R9: 2k; R_0402_1005Metric; LCSC C4109
R10, R11, R12: 100k; R_0402_1005Metric; LCSC C25741
R13: 22k; R_0805_2012Metric_Pad1.20x1.40mm_HandSolder; LCSC C17560
SW1: KXT3; SW_SPST_CK_KXT3; MPN KXT331LHS; Mouser 611-KXT331LHS
SW2: KXT3; SW_SPST_CK_KXT3; MPN KXT331LHS; Digikey CKN10779CT-ND
TP1, TP2, TP3, TP4, TP5, TP6: TestPoint; TestPoint_THTPad_2.5x2.5mm_Drill1.2mm
U1: RP2040; QFN-56-1EP_7x7mm_P0.4mm_EP3.2x3.2mm_ThermalVias; MPN SC0914(13); Mouser 358-SC091413
U2: W25Q16JV; Winbond_USON-8-1EP_3x2mm_P0.5mm_EP0.2x1.6mm; MPN W25Q16JVUXIQ; Mouser 454-W25Q16JVUXIQTR
U3: IS31FL3733B-QF; QFN-48-1EP_6x6mm_P0.4mm_EP4.2x4.2mm_ThermalVias; MPN IS31FL3733B-QFLS4-TR; Mouser 870-IS31FL3733BQFLS4
Y1: 12.000 MHz; Crystal_SMD_Abracon_ABM8AIG-4Pin_3.2x2.5mm; MPN ABM8-272-T3; Mouser 815-ABM8-272-T3

Connections:
+1V1: C4.1, C5.1, C6.1, U1.23 (DVDD), U1.45 (VREG_VOUT), U1.50 (DVDD)
+3V3: C1.1, C7.1, C8.1, C9.1, C10.1, C11.1, C12.1, C13.1, C14.1, C16.1, C18.1, D2.2 (A2), J1.1, J2.8, R1.1, R6.2, R8.2, R9.2, R10.2, U1.1 (IOVDD), U1.10 (IOVDD), U1.22 (IOVDD), U1.33 (IOVDD), U1.42 (IOVDD), U1.43 (ADC_AVDD), U1.44 (VREG_VIN), U1.48 (USB_VDD), U1.49 (IOVDD), U2.8 (VCC), U3.39 (VIO)
+5V: C15.1, C19.1, C20.1, C21.1, C22.1, C23.1, C24.1, C25.1, C26.1, D1.2 (A2), J2.2, U3.20 (PVCC), U3.29 (PVCC), U3.37 (AVCC), U3.38 (DVCC)
/BCKL_PWM: U1.37 (GPIO25)
/BOOT_DONE: U1.7 (GPIO5)
/CAPS_LOCK: U1.36 (GPIO24)
/COL1: U1.14 (GPIO11)
/COL2: U1.15 (GPIO12)
/COL3: U1.16 (GPIO13)
/COL4: U1.17 (GPIO14)
/COL5: U1.18 (GPIO15)
/COL6: U1.27 (GPIO16)
/COL7: U1.28 (GPIO17)
/COL8: U1.29 (GPIO18)
/COL9: U1.30 (GPIO19)
/COL10: U1.31 (GPIO20)
/COL11: U1.32 (GPIO21)
/COL12: U1.34 (GPIO22)
/COL13: U1.35 (GPIO23)
/I^{2}C_SCL: R9.1, U1.39 (GPIO27/ADC1), U3.42 (SCL)
/I^{2}C_SDA: R8.1, U1.38 (GPIO26/ADC0), U3.41 (SDA)
/LED_COL1: U3.27 (CS11)
/LED_COL2: U3.25 (CS9)
/LED_COL3: U3.28 (CS12)
/LED_COL4: U3.30 (CS13)
/LED_COL5: U3.17 (CS2)
/LED_COL6: U3.18 (CS3)
/LED_COL7: U3.16 (CS1)
/LED_COL8: U3.19 (CS4)
/LED_COL9: U3.21 (CS5)
/LED_COL10: U3.23 (CS7)
/LED_COL11: U3.22 (CS6)
/LED_COL12: U3.24 (CS8)
/LED_COL13: U3.26 (CS10)
/LED_EN: C17.1, R11.2, U1.41 (GPIO29/ADC3), U3.46 (~SDB)
/LED_INT: R10.1, U1.40 (GPIO28/ADC2), U3.45 (~INTB)
/LED_ROW1: U3.7 (SW5)
/LED_ROW2: U3.6 (SW4)
/LED_ROW3: U3.4 (SW3)
/LED_ROW4: U3.3 (SW2)
/LED_ROW5: U3.2 (SW1)
/MUX_A: U1.3 (GPIO1)
/MUX_B: U1.4 (GPIO2)
/MUX_C: U1.5 (GPIO3)
/MUX_EN: U1.6 (GPIO4)
/ROW1: U1.8 (GPIO6)
/ROW2: U1.9 (GPIO7)
/ROW3: U1.11 (GPIO8)
/ROW4: U1.12 (GPIO9)
/ROW5: U1.13 (GPIO10)
/SWCLK: J1.2, U1.24 (SWCLK)
/SWDIO: J1.3, U1.25 (SWDIO)
/USB_D+: D4.2 (A2), J2.5, R5.1
/USB_D-: D3.2 (A2), J2.3, R4.1
/USB_DN: R4.2, U1.46 (USB_DM)
/USB_DP: R5.2, U1.47 (USB_DP)
/~SLEEP: D5.2 (A2), J2.6, U1.2 (GPIO0)
GND: C1.2, C2.1, C3.2, C4.2, C5.2, C6.2, C7.2, C8.2, C9.2, C10.2, C11.2, C12.2, C13.2, C14.2, C15.2, C16.2, C17.2, C18.2, C19.2, C20.2, C21.2, C22.2, C23.2, C24.2, C25.2, C26.2, D1.1 (A1), D2.1 (A1), D3.1 (A1), D4.1 (A1), D5.1 (A1), J1.4, J2.1, J2.7, R7.1, R11.1, R12.1, R13.1, SW1.1, SW2.1, TP1.1, TP2.1, TP3.1, TP4.1, TP5.1, TP6.1, U1.19 (TESTEN), U1.57 (GND), U2.4 (GND), U2.9 (EP), U3.5 (PGND), U3.12 (PGND), U3.34 (AGND), U3.43 (ADDR1), U3.44 (ADDR2), U3.48 (GND), U3.49 (GND), Y1.2 (G), Y1.4 (G)
unnamed: C2.2, R3.1, Y1.1
unnamed: J2.4, R7.2
unnamed: R2.1, SW1.2
unnamed: U1.52 (QSPI_SCLK), U2.6 (CLK)
unnamed: U1.53 (QSPI_SD0), U2.5 (DI/IO_{0})
unnamed: U1.55 (QSPI_SD1), U2.2 (DO/IO_{1})
unnamed: U1.54 (QSPI_SD2), U2.3 (~WP/IO_{2})
unnamed: U1.51 (QSPI_SD3), U2.7 (~HOLD/~RESET/IO_{3})
unnamed: R6.1, SW2.2, U1.26 (RUN)
unnamed: C3.1, U1.20 (XIN), Y1.3
unnamed: R3.2, U1.21 (XOUT)
unnamed: R1.2, R2.2, U1.56 (~QSPI_SS), U2.1 (~CS)
unnamed: R12.2, U3.47 (IICRST)
unnamed: R13.2, U3.35 (RSET)

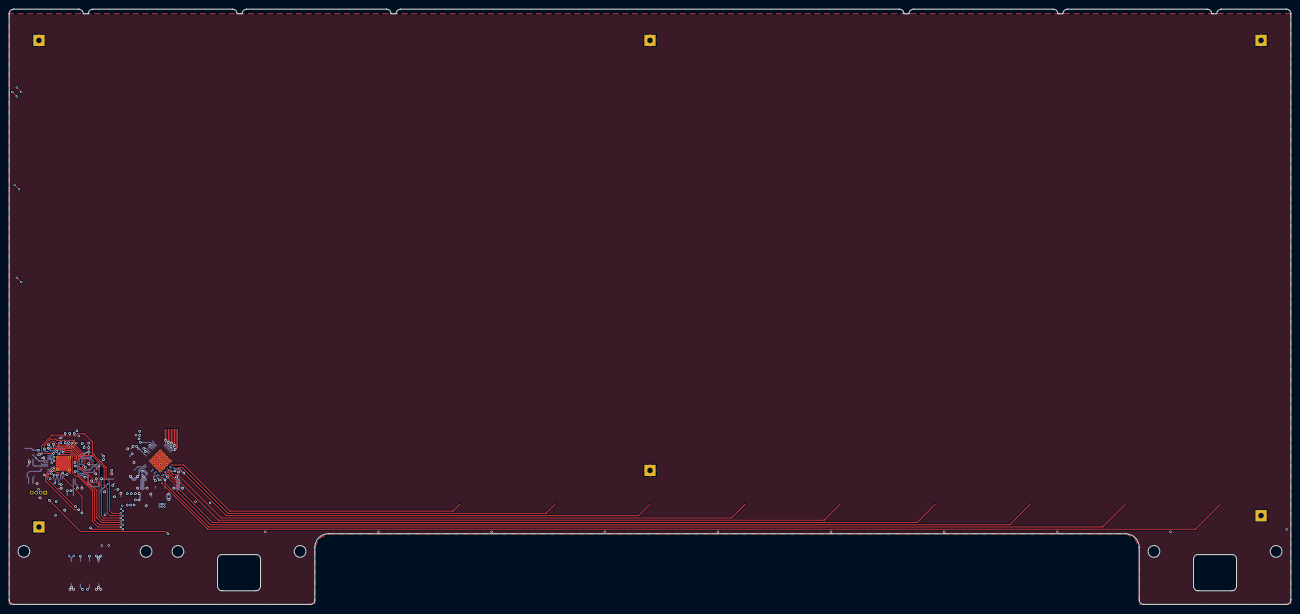
[picture p49: board HandyWork-PCB.kicad_pcb from above]

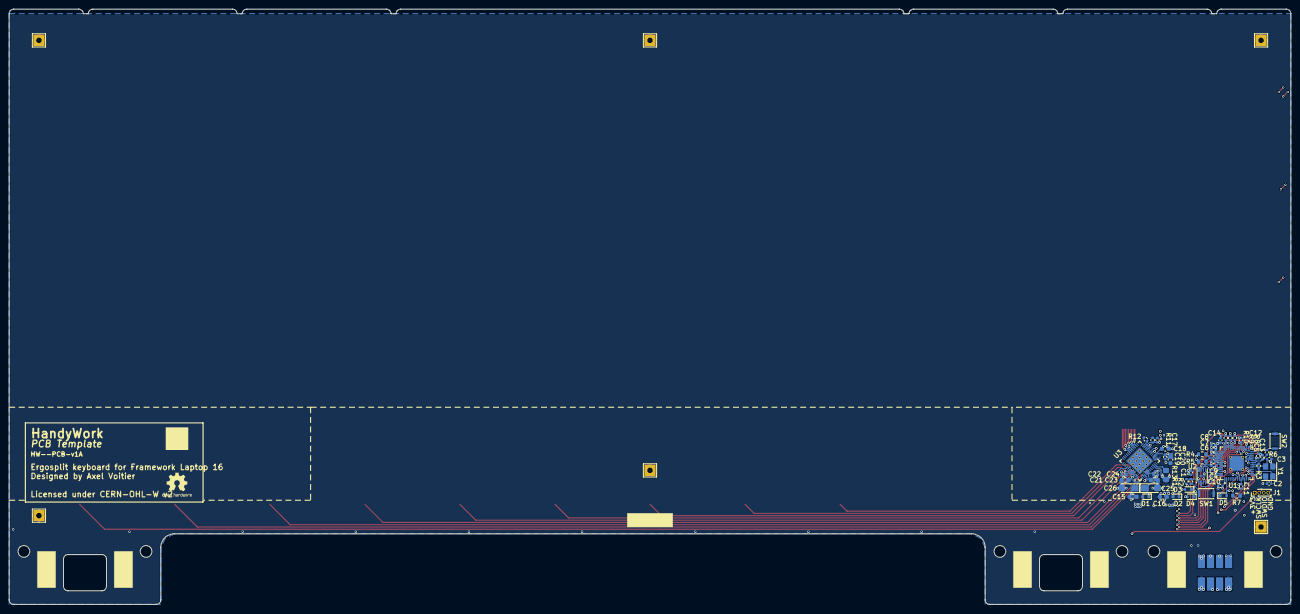
[picture p50: board HandyWork-PCB.kicad_pcb from below]

Board: 4 copper layers, 283.2 x 131.5 mm, 58 parts (57 on the bottom side), 29 nets.
