AxelVoitier/keebs/Lergo/PCB/Lergo.kicad_pcb

## KiCad design Lergo/PCB/Lergo.kicad_pcb (2021-11-15)

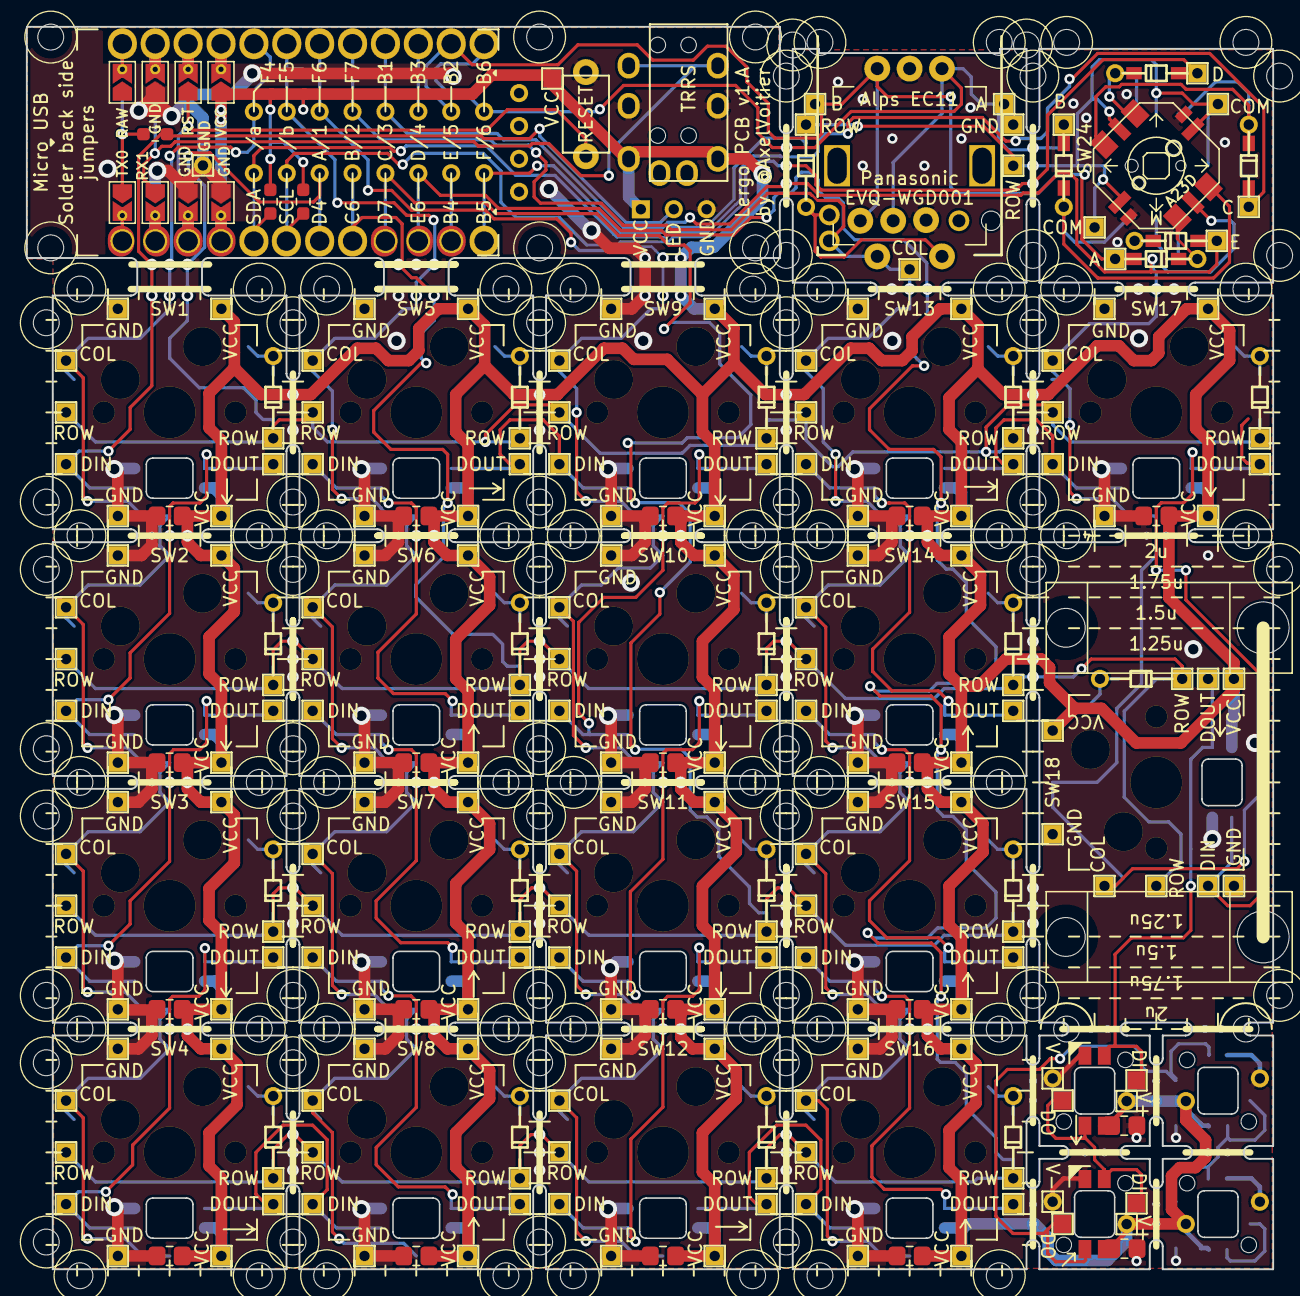
[picture p51: board Lergo.kicad_pcb from above]

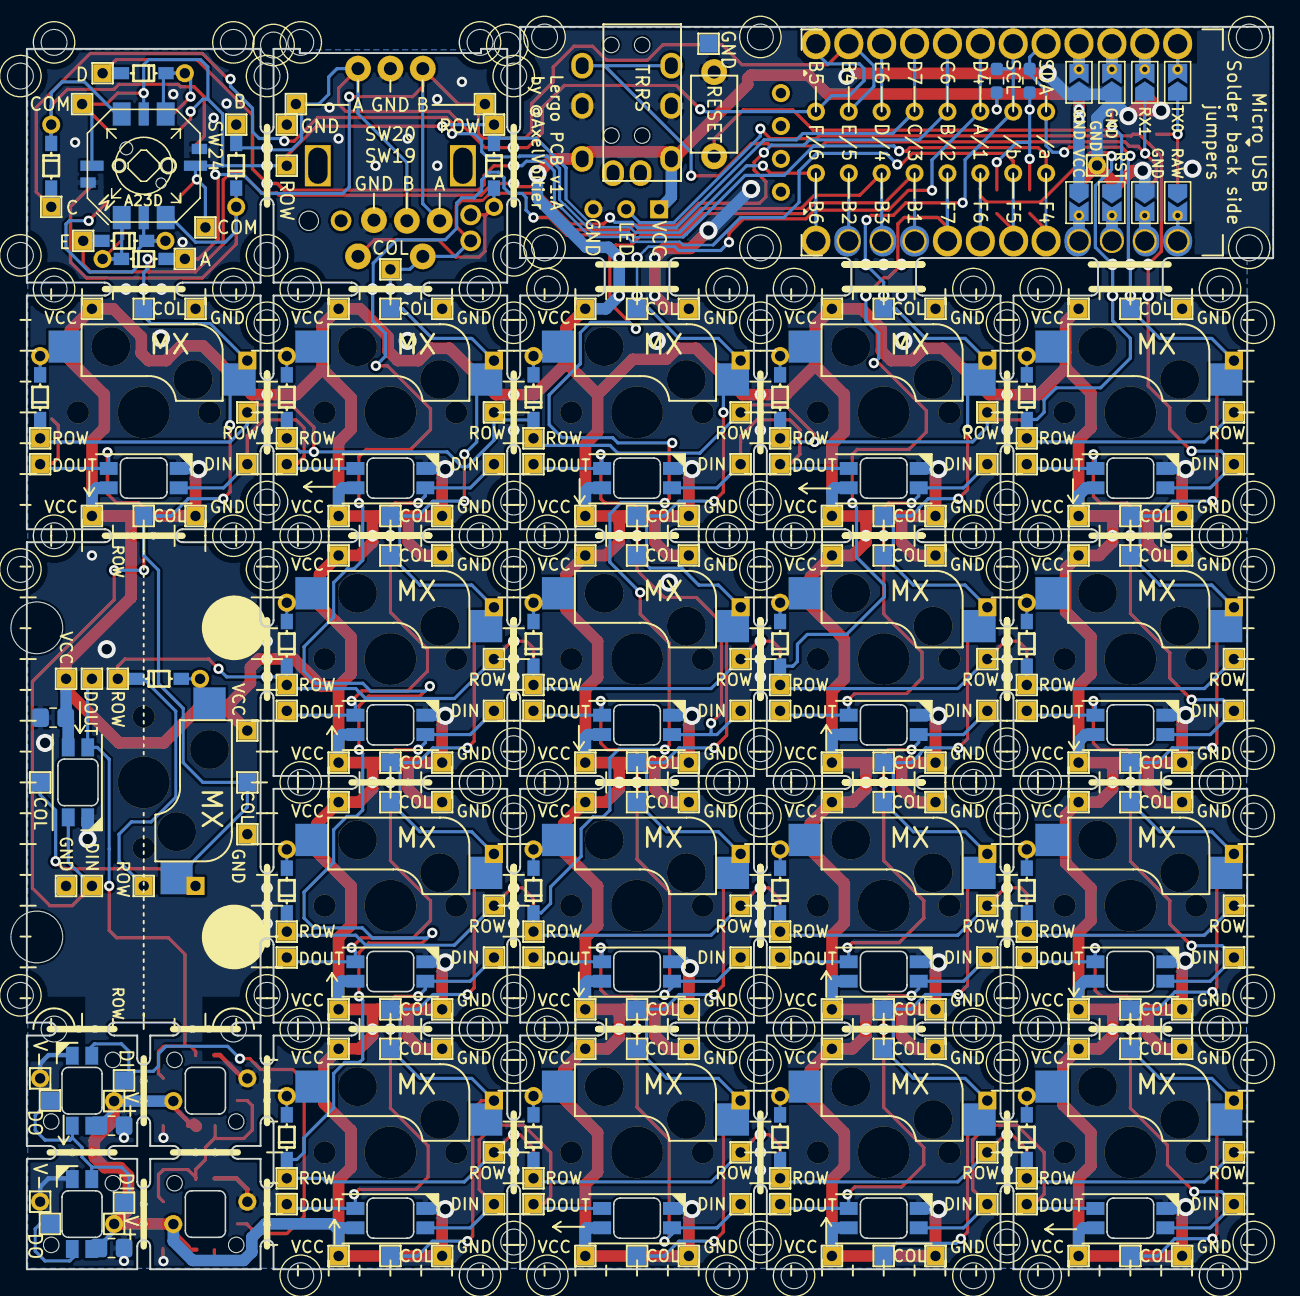
[picture p52: board Lergo.kicad_pcb from below]

Board: 2 copper layers, 96.2 x 95.9 mm, 94 parts (26 on the bottom side), 58 nets.

Parts:
%R: SW_Push; CherryMX_Lergo_v1_Module_2_M2
%R#2, %R#3, %R#4, %R#5, %R#6, %R#7, %R#8, %R#9, %R#10: SW_Push; CherryMX_Lergo_v1_Module_2_M2
C19, C20, C21, C22: 100n; C_0603_0805_HandSolder
D1, D2, D3, D4, D5: D_Small; diode_TH_SMD_rev3_alt
D18: D; diode_TH_SMD_rev3
H6, H6#2, H101, H102, H135, H138, H170: MountingHole_Pad; 1pin_rect_conn
H57, H152, H155, H156, H159, H160, H163, H164, H167: MountingHole_Pad; 1pin_conn
H153, H154, H157, H158, H161, H162, H165, H166, H168, H169: MountingHole_Pad; 1pad_conn
J1, J6: MJ-4PP-9
J2: Conn_01x03; PinHeader_1x03_P2.54mm_Vertical
J3, J4: Conn_01x08; PinHeader_1x08_P2.54mm_Vertical_rev2
JP101, JP102, JP103, JP104, JP105, JP106, JP107, JP108: SolderJumper_3_Open; SolderJumper-3_P1.3mm_Open_TrianglePad1.0x1.5mm_duplex
LED1, LED2, LED3, LED4: LED_SK6812_Mini_E; SK6812_Mini_E
R101: 510R; R_0603_1608Metric_Pad0.98x0.95mm_HandSolder
R102, R103, R104, R105: 4k7; R_0603_1608Metric_Pad0.98x0.95mm_HandSolder
Ref**: Val**; M2_Hole_Standoff_Large_Cleareance
Ref**#2: Val**; M2_Hole_Standoff_Large_Cleareance
SW1, SW2, SW3, SW4, SW5, SW6, SW7, SW8, SW9, SW10, SW11, SW12, SW13, SW14, SW15, SW16, SW17: SW_PUSH_LED; CherryMX_Lergo_v1_Module_1u
SW18: SW_PUSH_LED; CherryMX_Lergo_v1_Module_2u
SW19: Rotary_Encoder_Switch; RollerEncoder_Panasonic_EVQWGD001_No_Cutout
SW20: Rotary_Encoder_Switch; RotaryEncoder_Alps_EC11E-Switch_Vertical_H20mm_rev2
SW22: SW_Push; ResetSW
SW24, SW24#2: 5way_switch; Five_Way_Switch_Panasonic_EVQQ7
U1: ProMicro; Arduino_ProMicro_Rivets

Connections:
GND: C19.1, C20.1, C21.1, C22.1, H57.1, H155.1, H159.1, H163.1, H167.1, H169.1, H170.1, J1.C, J2.3, J6.C, JP101.1, JP102.1, JP103.3, JP106.1, JP107.3, JP108.3, LED1.3, LED2.3, LED3.3, LED4.3, SW1.3, SW2.3, SW3.3, SW4.3, SW5.3, SW6.3, SW7.3, SW8.3, SW9.3, SW10.3, SW11.3, SW12.3, SW13.3, SW14.3, SW15.3, SW16.3, SW17.3, SW18.3, SW19.C, SW20.C, SW22.2, SW24.GND, SW24#2.GND
unnamed: D1.1, SW24.A, SW24#2.A
unnamed: D2.1, SW24.E, SW24#2.E
unnamed: D3.1, SW24.B, SW24#2.B
unnamed: D4.1, SW24.C, SW24#2.C
unnamed: D5.1, SW24.D, SW24#2.D
unnamed: D18.2, SW19.S2, SW20.S2
unnamed: H153.1, H158.1, LED1.2, LED2.4
unnamed: H154.1, LED1.4, SW18.2
unnamed: H157.1, H162.1, LED2.2, LED3.4
unnamed: H161.1, H166.1, LED3.2, LED4.4
unnamed: H165.1, LED4.2
unnamed: JP101.2, U1.4
unnamed: JP102.2, U1.3
unnamed: JP103.2, U1.2
unnamed: JP104.2, U1.1
unnamed: JP105.2, U1.24
unnamed: JP106.2, U1.23
unnamed: JP107.2, U1.22
unnamed: JP108.2, U1.21
unnamed: SW1.2, SW2.4
unnamed: SW2.2, SW3.4
unnamed: SW3.2, SW4.4
unnamed: SW4.2, SW8.4
unnamed: SW5.2, SW9.4
unnamed: SW5.4, SW6.2
unnamed: SW6.4, SW7.2
unnamed: SW7.4, SW8.2
unnamed: SW10.2, SW11.4
unnamed: SW9.2, SW10.4
unnamed: SW11.2, SW12.4
unnamed: SW12.2, SW16.4
unnamed: SW13.2, SW17.4
unnamed: SW13.4, SW14.2
unnamed: SW14.4, SW15.2
unnamed: SW15.4, SW16.2
unnamed: SW17.2, SW18.4
VCC: C19.2, C20.2, C21.2, C22.2, H152.1, H156.1, H160.1, H164.1, H168.1, J1.D, J2.1, J6.D, JP101.3, JP108.1, LED1.1, LED2.1, LED3.1, LED4.1, R102.2, R103.2, R104.2, R105.2, SW1.1, SW2.1, SW3.1, SW4.1, SW5.1, SW6.1, SW7.1, SW8.1, SW9.1, SW10.1, SW11.1, SW12.1, SW13.1, SW14.1, SW15.1, SW16.1, SW17.1, SW18.1
X1: J4.1, R102.1, SW1.5, SW2.5, SW3.5, SW4.5, U1.5
X2: J4.2, R103.1, SW5.5, SW6.5, SW7.5, SW8.5, U1.6
X3: J4.3, SW9.5, SW10.5, SW11.5, SW12.5, U1.7
X4: H135.1, J4.4, SW13.5, SW14.5, SW15.5, SW16.5, SW19.S1, SW20.S1, U1.8
X5: D2.2, J4.5, SW17.5, SW18.5, U1.9
X6: J4.6, U1.10
X7: D1.2, H102.1, J4.7, SW19.A, SW20.B, U1.11
X8: D3.2, H101.1, J4.8, SW19.B, SW20.A, U1.12
X9: D4.2, J3.1, R104.1, U1.20
X10: D5.2, J3.2, R105.1, U1.19
Y1: J3.3, SW1.7, SW5.7, SW9.7, SW13.7, SW17.7, U1.18
Y2: J3.4, SW2.7, SW6.7, SW10.7, SW14.7, SW18.7, U1.17
Y3: J3.5, SW3.7, SW7.7, SW11.7, SW15.7, U1.16
Y4: J3.6, SW4.7, SW8.7, SW12.7, SW16.7, U1.15
Y5: J3.7, U1.14
Y6: D18.1, H6.1, H6#2.1, H138.1, J3.8, SW24.Com, SW24#2.Com, U1.13
data: J1.B, J6.B, JP103.1, JP106.3
led: J2.2, R101.1, SW1.4
led_: JP104.1, JP105.3, R101.2
reset1: JP102.3, JP107.1, SW22.1
