AxelVoitier/keebs/Framework/HandyWork-5x3-with-mods/ergogen-output/points/points.yaml

matrix_inner_bottom:
    x: 47.3576482
    'y': -18.741749
    r: 25
    meta:
        stagger: 0
        spread: 19
        splay: -0.0
        origin:
            - 0
            - 0
        orient: 0
        shift:
            - 0
            - 0
        rotate: 0
        adjust: {}
        width: 19
        height: 19
        padding: 19
        autobind: 10
        skip: false
        asym: both
        colrow: inner_bottom
        name: matrix_inner_bottom
        tags:
            1u: true
        layers:
            Qwerty: 'N'
        mirror:
            layers:
                Qwerty: B
        zone:
            key:
                padding: 1ky
                spread: 1kx
                tags:
                    1u: true
            columns:
                inner:
                    key:
                        splay: '-inner_splay'
                    rows:
                        mod:
                            skip: true
                        number:
                            layers:
                                Qwerty:
                                    alt-no-mod: 6
                                    shift: ^
                            mirror:
                                layers:
                                    Qwerty:
                                        alt-no-mod: 5
                                        shift: '%'
                        top:
                            layers:
                                Qwerty: 'Y'
                            mirror:
                                layers:
                                    Qwerty: T
                        home:
                            layers:
                                Qwerty: H
                            mirror:
                                layers:
                                    Qwerty: G
                        bottom:
                            layers:
                                Qwerty: 'N'
                            mirror:
                                layers:
                                    Qwerty: B
                    name: inner
                index:
                    key:
                        stagger: '-inner_off + index_off'
                        splay: +inner_splay - index_splay
                    rows:
                        mod:
                            skip: true
                        number:
                            layers:
                                Qwerty:
                                    alt-no-mod: 7
                                    shift: '&'
                            mirror:
                                layers:
                                    Qwerty:
                                        alt-no-mod: 4
                                        shift: $
                        top:
                            layers:
                                Qwerty: U
                            mirror:
                                layers:
                                    Qwerty: R
                        home:
                            layers:
                                Qwerty: J
                            mirror:
                                layers:
                                    Qwerty: F
                        bottom:
                            layers:
                                Qwerty: M
                            mirror:
                                layers:
                                    Qwerty: V
                    name: index
                middle:
                    key:
                        stagger: '-index_off + middle_off'
                        splay: +index_splay - middle_splay
                        spread: 1kx + 0.8
                    rows:
                        number:
                            layers:
                                Qwerty:
                                    alt-no-mod: 8
                                    shift: '*'
                            mirror:
                                layers:
                                    Qwerty:
                                        alt-no-mod: 3
                                        shift: '#'
                        top:
                            layers:
                                Qwerty: I
                            mirror:
                                layers:
                                    Qwerty: E
                        home:
                            layers:
                                Qwerty: K
                            mirror:
                                layers:
                                    Qwerty: D
                        bottom:
                            layers:
                                Qwerty:
                                    alt-no-mod: ','
                                    shift: <
                            mirror:
                                layers:
                                    Qwerty: C
                        mod:
                            layers:
                                Base:
                                    legend: ⇧
                                    size: 9
                                    keycode: KC_RIGHT_SHIFT
                            mirror:
                                layers:
                                    Base:
                                        keycode: $unset
                    name: middle
                ring:
                    key:
                        stagger: '-middle_off + ring_off'
                        splay: +middle_splay - ring_splay
                        spread: 1kx + 0.04
                    rows:
                        number:
                            layers:
                                Qwerty:
                                    alt-no-mod: 9
                                    shift: (
                            mirror:
                                layers:
                                    Qwerty:
                                        alt-no-mod: 2
                                        shift: '@'
                        top:
                            layers:
                                Qwerty: O
                            mirror:
                                layers:
                                    Qwerty: W
                        home:
                            layers:
                                Qwerty: L
                            mirror:
                                layers:
                                    Qwerty: S
                        bottom:
                            layers:
                                Qwerty:
                                    alt-no-mod: .
                                    shift: '>'
                            mirror:
                                layers:
                                    Qwerty: X
                        mod:
                            layers:
                                Base:
                                    legend: ⎈
                                    size: 9
                            mirror:
                                layers:
                                    Base:
                                        legend: ⎈
                                        size: 9
                    name: ring
                pinky:
                    key:
                        stagger: '-ring_off + pinky_off + 1'
                        splay: +ring_splay - pinky_splay
                        spread: 1kx + 0.035
                    rows:
                        number:
                            layers:
                                Qwerty:
                                    alt-no-mod: 0
                                    shift: )
                            mirror:
                                layers:
                                    Qwerty:
                                        alt-no-mod: 1
                                        shift: '!'
                        top:
                            layers:
                                Qwerty: P
                            mirror:
                                layers:
                                    Qwerty: Q
                        home:
                            layers:
                                Qwerty:
                                    alt-no-mod: ;
                                    shift: ':'
                            mirror:
                                layers:
                                    Qwerty: A
                        bottom:
                            layers:
                                Qwerty:
                                    alt-no-mod: /
                                    shift: '?'
                            mirror:
                                layers:
                                    Qwerty: Z
                        mod:
                            layers:
                                Base:
                                    legend: ❖
                                    size: 8
                            mirror:
                                layers:
                                    Base:
                                        legend: ⎇
                                        size: 6
                    name: pinky
            rows:
                mod:
                    skip: false
                bottom: {}
                home: {}
                top: {}
                number:
                    skip: true
            name: matrix
        col:
            key:
                splay: '-inner_splay'
            rows:
                mod:
                    skip: true
                number:
                    layers:
                        Qwerty:
                            alt-no-mod: 6
                            shift: ^
                    mirror:
                        layers:
                            Qwerty:
                                alt-no-mod: 5
                                shift: '%'
                top:
                    layers:
                        Qwerty: 'Y'
                    mirror:
                        layers:
                            Qwerty: T
                home:
                    layers:
                        Qwerty: H
                    mirror:
                        layers:
                            Qwerty: G
                bottom:
                    layers:
                        Qwerty: 'N'
                    mirror:
                        layers:
                            Qwerty: B
            name: inner
        row: bottom
        mirrored: false
        bind:
            - 10
            - 0
            - 0
            - 0
matrix_inner_home:
    x: 39.3279013
    'y': -1.521901
    r: 25
    meta:
        stagger: 0
        spread: 19
        splay: -0.0
        origin:
            - 0
            - 0
        orient: 0
        shift:
            - 0
            - 0
        rotate: 0
        adjust: {}
        width: 19
        height: 19
        padding: 19
        autobind: 10
        skip: false
        asym: both
        colrow: inner_home
        name: matrix_inner_home
        tags:
            1u: true
        layers:
            Qwerty: H
        mirror:
            layers:
                Qwerty: G
        zone:
            key:
                padding: 1ky
                spread: 1kx
                tags:
                    1u: true
            columns:
                inner:
                    key:
                        splay: '-inner_splay'
                    rows:
                        mod:
                            skip: true
                        number:
                            layers:
                                Qwerty:
                                    alt-no-mod: 6
                                    shift: ^
                            mirror:
                                layers:
                                    Qwerty:
                                        alt-no-mod: 5
                                        shift: '%'
                        top:
                            layers:
                                Qwerty: 'Y'
                            mirror:
                                layers:
                                    Qwerty: T
                        home:
                            layers:
                                Qwerty: H
                            mirror:
                                layers:
                                    Qwerty: G
                        bottom:
                            layers:
                                Qwerty: 'N'
                            mirror:
                                layers:
                                    Qwerty: B
                    name: inner
                index:
                    key:
                        stagger: '-inner_off + index_off'
                        splay: +inner_splay - index_splay
                    rows:
                        mod:
                            skip: true
                        number:
                            layers:
                                Qwerty:
                                    alt-no-mod: 7
                                    shift: '&'
                            mirror:
                                layers:
                                    Qwerty:
                                        alt-no-mod: 4
                                        shift: $
                        top:
                            layers:
                                Qwerty: U
                            mirror:
                                layers:
                                    Qwerty: R
                        home:
                            layers:
                                Qwerty: J
                            mirror:
                                layers:
                                    Qwerty: F
                        bottom:
                            layers:
                                Qwerty: M
                            mirror:
                                layers:
                                    Qwerty: V
                    name: index
                middle:
                    key:
                        stagger: '-index_off + middle_off'
                        splay: +index_splay - middle_splay
                        spread: 1kx + 0.8
                    rows:
                        number:
                            layers:
                                Qwerty:
                                    alt-no-mod: 8
                                    shift: '*'
                            mirror:
                                layers:
                                    Qwerty:
                                        alt-no-mod: 3
                                        shift: '#'
                        top:
                            layers:
                                Qwerty: I
                            mirror:
                                layers:
                                    Qwerty: E
                        home:
                            layers:
                                Qwerty: K
                            mirror:
                                layers:
                                    Qwerty: D
                        bottom:
                            layers:
                                Qwerty:
                                    alt-no-mod: ','
                                    shift: <
                            mirror:
                                layers:
                                    Qwerty: C
                        mod:
                            layers:
                                Base:
                                    legend: ⇧
                                    size: 9
                                    keycode: KC_RIGHT_SHIFT
                            mirror:
                                layers:
                                    Base:
                                        keycode: $unset
                    name: middle
                ring:
                    key:
                        stagger: '-middle_off + ring_off'
                        splay: +middle_splay - ring_splay
                        spread: 1kx + 0.04
                    rows:
                        number:
                            layers:
                                Qwerty:
                                    alt-no-mod: 9
                                    shift: (
                            mirror:
                                layers:
                                    Qwerty:
                                        alt-no-mod: 2
                                        shift: '@'
                        top:
                            layers:
                                Qwerty: O
                            mirror:
                                layers:
                                    Qwerty: W
                        home:
                            layers:
                                Qwerty: L
                            mirror:
                                layers:
                                    Qwerty: S
                        bottom:
                            layers:
                                Qwerty:
                                    alt-no-mod: .
                                    shift: '>'
                            mirror:
                                layers:
                                    Qwerty: X
                        mod:
                            layers:
                                Base:
                                    legend: ⎈
                                    size: 9
                            mirror:
                                layers:
                                    Base:
                                        legend: ⎈
                                        size: 9
                    name: ring
                pinky:
                    key:
                        stagger: '-ring_off + pinky_off + 1'
                        splay: +ring_splay - pinky_splay
                        spread: 1kx + 0.035
                    rows:
                        number:
                            layers:
                                Qwerty:
                                    alt-no-mod: 0
                                    shift: )
                            mirror:
                                layers:
                                    Qwerty:
                                        alt-no-mod: 1
                                        shift: '!'
                        top:
                            layers:
                                Qwerty: P
                            mirror:
                                layers:
                                    Qwerty: Q
                        home:
                            layers:
                                Qwerty:
                                    alt-no-mod: ;
                                    shift: ':'
                            mirror:
                                layers:
                                    Qwerty: A
                        bottom:
                            layers:
                                Qwerty:
                                    alt-no-mod: /
                                    shift: '?'
                            mirror:
                                layers:
                                    Qwerty: Z
                        mod:
                            layers:
                                Base:
                                    legend: ❖
                                    size: 8
                            mirror:
                                layers:
                                    Base:
                                        legend: ⎇
                                        size: 6
                    name: pinky
            rows:
                mod:
                    skip: false
                bottom: {}
                home: {}
                top: {}
                number:
                    skip: true
            name: matrix
        col:
            key:
                splay: '-inner_splay'
            rows:
                mod:
                    skip: true
                number:
                    layers:
                        Qwerty:
                            alt-no-mod: 6
                            shift: ^
                    mirror:
                        layers:
                            Qwerty:
                                alt-no-mod: 5
                                shift: '%'
                top:
                    layers:
                        Qwerty: 'Y'
                    mirror:
                        layers:
                            Qwerty: T
                home:
                    layers:
                        Qwerty: H
                    mirror:
                        layers:
                            Qwerty: G
                bottom:
                    layers:
                        Qwerty: 'N'
                    mirror:
                        layers:
                            Qwerty: B
            name: inner
        row: home
        mirrored: false
        bind:
            - 10
            - 10
            - 10
            - 0
matrix_inner_top:
    x: 31.2981543
    'y': 15.6979469
    r: 25
    meta:
        stagger: 0
        spread: 19
        splay: -0.0
        origin:
            - 0
            - 0
        orient: 0
        shift:
            - 0
            - 0
        rotate: 0
        adjust: {}
        width: 19
        height: 19
        padding: 19
        autobind: 10
        skip: false
        asym: both
        colrow: inner_top
        name: matrix_inner_top
        tags:
            1u: true
        layers:
            Qwerty: 'Y'
        mirror:
            layers:
                Qwerty: T
        zone:
            key:
                padding: 1ky
                spread: 1kx
                tags:
                    1u: true
            columns:
                inner:
                    key:
                        splay: '-inner_splay'
                    rows:
                        mod:
                            skip: true
                        number:
                            layers:
                                Qwerty:
                                    alt-no-mod: 6
                                    shift: ^
                            mirror:
                                layers:
                                    Qwerty:
                                        alt-no-mod: 5
                                        shift: '%'
                        top:
                            layers:
                                Qwerty: 'Y'
                            mirror:
                                layers:
                                    Qwerty: T
                        home:
                            layers:
                                Qwerty: H
                            mirror:
                                layers:
                                    Qwerty: G
                        bottom:
                            layers:
                                Qwerty: 'N'
                            mirror:
                                layers:
                                    Qwerty: B
                    name: inner
                index:
                    key:
                        stagger: '-inner_off + index_off'
                        splay: +inner_splay - index_splay
                    rows:
                        mod:
                            skip: true
                        number:
                            layers:
                                Qwerty:
                                    alt-no-mod: 7
                                    shift: '&'
                            mirror:
                                layers:
                                    Qwerty:
                                        alt-no-mod: 4
                                        shift: $
                        top:
                            layers:
                                Qwerty: U
                            mirror:
                                layers:
                                    Qwerty: R
                        home:
                            layers:
                                Qwerty: J
                            mirror:
                                layers:
                                    Qwerty: F
                        bottom:
                            layers:
                                Qwerty: M
                            mirror:
                                layers:
                                    Qwerty: V
                    name: index
                middle:
                    key:
                        stagger: '-index_off + middle_off'
                        splay: +index_splay - middle_splay
                        spread: 1kx + 0.8
                    rows:
                        number:
                            layers:
                                Qwerty:
                                    alt-no-mod: 8
                                    shift: '*'
                            mirror:
                                layers:
                                    Qwerty:
                                        alt-no-mod: 3
                                        shift: '#'
                        top:
                            layers:
                                Qwerty: I
                            mirror:
                                layers:
                                    Qwerty: E
                        home:
                            layers:
                                Qwerty: K
                            mirror:
                                layers:
                                    Qwerty: D
                        bottom:
                            layers:
                                Qwerty:
                                    alt-no-mod: ','
                                    shift: <
                            mirror:
                                layers:
                                    Qwerty: C
                        mod:
                            layers:
                                Base:
                                    legend: ⇧
                                    size: 9
                                    keycode: KC_RIGHT_SHIFT
                            mirror:
                                layers:
                                    Base:
                                        keycode: $unset
                    name: middle
                ring:
                    key:
                        stagger: '-middle_off + ring_off'
                        splay: +middle_splay - ring_splay
                        spread: 1kx + 0.04
                    rows:
                        number:
                            layers:
                                Qwerty:
                                    alt-no-mod: 9
                                    shift: (
                            mirror:
                                layers:
                                    Qwerty:
                                        alt-no-mod: 2
                                        shift: '@'
                        top:
                            layers:
                                Qwerty: O
                            mirror:
                                layers:
                                    Qwerty: W
                        home:
                            layers:
                                Qwerty: L
                            mirror:
                                layers:
                                    Qwerty: S
                        bottom:
                            layers:
                                Qwerty:
                                    alt-no-mod: .
                                    shift: '>'
                            mirror:
                                layers:
                                    Qwerty: X
                        mod:
                            layers:
                                Base:
                                    legend: ⎈
                                    size: 9
                            mirror:
                                layers:
                                    Base:
                                        legend: ⎈
                                        size: 9
                    name: ring
                pinky:
                    key:
                        stagger: '-ring_off + pinky_off + 1'
                        splay: +ring_splay - pinky_splay
                        spread: 1kx + 0.035
                    rows:
                        number:
                            layers:
                                Qwerty:
                                    alt-no-mod: 0
                                    shift: )
                            mirror:
                                layers:
                                    Qwerty:
                                        alt-no-mod: 1
                                        shift: '!'
                        top:
                            layers:
                                Qwerty: P
                            mirror:
                                layers:
                                    Qwerty: Q
                        home:
                            layers:
                                Qwerty:
                                    alt-no-mod: ;
                                    shift: ':'
                            mirror:
                                layers:
                                    Qwerty: A
                        bottom:
                            layers:
                                Qwerty:
                                    alt-no-mod: /
                                    shift: '?'
                            mirror:
                                layers:
                                    Qwerty: Z
                        mod:
                            layers:
                                Base:
                                    legend: ❖
                                    size: 8
                            mirror:
                                layers:
                                    Base:
                                        legend: ⎇
                                        size: 6
                    name: pinky
            rows:
                mod:
                    skip: false
                bottom: {}
                home: {}
                top: {}
                number:
                    skip: true
            name: matrix
        col:
            key:
                splay: '-inner_splay'
            rows:
                mod:
                    skip: true
                number:
                    layers:
                        Qwerty:
                            alt-no-mod: 6
                            shift: ^
                    mirror:
                        layers:
                            Qwerty:
                                alt-no-mod: 5
                                shift: '%'
                top:
                    layers:
                        Qwerty: 'Y'
                    mirror:
                        layers:
                            Qwerty: T
                home:
                    layers:
                        Qwerty: H
                    mirror:
                        layers:
                            Qwerty: G
                bottom:
                    layers:
                        Qwerty: 'N'
                    mirror:
                        layers:
                            Qwerty: B
            name: inner
        row: top
        mirrored: false
        bind:
            - 0
            - 10
            - 10
            - 0
matrix_index_bottom:
    x: 63.5209505
    'y': -8.4462325
    r: 25
    meta:
        stagger: 2.5
        spread: 19
        splay: 0
        origin:
            - 0
            - 0
        orient: 0
        shift:
            - 0
            - 0
        rotate: 0
        adjust: {}
        width: 19
        height: 19
        padding: 19
        autobind: 10
        skip: false
        asym: both
        colrow: index_bottom
        name: matrix_index_bottom
        tags:
            1u: true
        layers:
            Qwerty: M
        mirror:
            layers:
                Qwerty: V
        zone:
            key:
                padding: 1ky
                spread: 1kx
                tags:
                    1u: true
            columns:
                inner:
                    key:
                        splay: '-inner_splay'
                    rows:
                        mod:
                            skip: true
                        number:
                            layers:
                                Qwerty:
                                    alt-no-mod: 6
                                    shift: ^
                            mirror:
                                layers:
                                    Qwerty:
                                        alt-no-mod: 5
                                        shift: '%'
                        top:
                            layers:
                                Qwerty: 'Y'
                            mirror:
                                layers:
                                    Qwerty: T
                        home:
                            layers:
                                Qwerty: H
                            mirror:
                                layers:
                                    Qwerty: G
                        bottom:
                            layers:
                                Qwerty: 'N'
                            mirror:
                                layers:
                                    Qwerty: B
                    name: inner
                index:
                    key:
                        stagger: '-inner_off + index_off'
                        splay: +inner_splay - index_splay
                    rows:
                        mod:
                            skip: true
                        number:
                            layers:
                                Qwerty:
                                    alt-no-mod: 7
                                    shift: '&'
                            mirror:
                                layers:
                                    Qwerty:
                                        alt-no-mod: 4
                                        shift: $
                        top:
                            layers:
                                Qwerty: U
                            mirror:
                                layers:
                                    Qwerty: R
                        home:
                            layers:
                                Qwerty: J
                            mirror:
                                layers:
                                    Qwerty: F
                        bottom:
                            layers:
                                Qwerty: M
                            mirror:
                                layers:
                                    Qwerty: V
                    name: index
                middle:
                    key:
                        stagger: '-index_off + middle_off'
                        splay: +index_splay - middle_splay
                        spread: 1kx + 0.8
                    rows:
                        number:
                            layers:
                                Qwerty:
                                    alt-no-mod: 8
                                    shift: '*'
                            mirror:
                                layers:
                                    Qwerty:
                                        alt-no-mod: 3
                                        shift: '#'
                        top:
                            layers:
                                Qwerty: I
                            mirror:
                                layers:
                                    Qwerty: E
                        home:
                            layers:
                                Qwerty: K
                            mirror:
                                layers:
                                    Qwerty: D
                        bottom:
                            layers:
                                Qwerty:
                                    alt-no-mod: ','
                                    shift: <
                            mirror:
                                layers:
                                    Qwerty: C
                        mod:
                            layers:
                                Base:
                                    legend: ⇧
                                    size: 9
                                    keycode: KC_RIGHT_SHIFT
                            mirror:
                                layers:
                                    Base:
                                        keycode: $unset
                    name: middle
                ring:
                    key:
                        stagger: '-middle_off + ring_off'
                        splay: +middle_splay - ring_splay
                        spread: 1kx + 0.04
                    rows:
                        number:
                            layers:
                                Qwerty:
                                    alt-no-mod: 9
                                    shift: (
                            mirror:
                                layers:
                                    Qwerty:
                                        alt-no-mod: 2
                                        shift: '@'
                        top:
                            layers:
                                Qwerty: O
                            mirror:
                                layers:
                                    Qwerty: W
                        home:
                            layers:
                                Qwerty: L
                            mirror:
                                layers:
                                    Qwerty: S
                        bottom:
                            layers:
                                Qwerty:
                                    alt-no-mod: .
                                    shift: '>'
                            mirror:
                                layers:
                                    Qwerty: X
                        mod:
                            layers:
                                Base:
                                    legend: ⎈
                                    size: 9
                            mirror:
                                layers:
                                    Base:
                                        legend: ⎈
                                        size: 9
                    name: ring
                pinky:
                    key:
                        stagger: '-ring_off + pinky_off + 1'
                        splay: +ring_splay - pinky_splay
                        spread: 1kx + 0.035
                    rows:
                        number:
                            layers:
                                Qwerty:
                                    alt-no-mod: 0
                                    shift: )
                            mirror:
                                layers:
                                    Qwerty:
                                        alt-no-mod: 1
                                        shift: '!'
                        top:
                            layers:
                                Qwerty: P
                            mirror:
                                layers:
                                    Qwerty: Q
                        home:
                            layers:
                                Qwerty:
                                    alt-no-mod: ;
                                    shift: ':'
                            mirror:
                                layers:
                                    Qwerty: A
                        bottom:
                            layers:
                                Qwerty:
                                    alt-no-mod: /
                                    shift: '?'
                            mirror:
                                layers:
                                    Qwerty: Z
                        mod:
                            layers:
                                Base:
                                    legend: ❖
                                    size: 8
                            mirror:
                                layers:
                                    Base:
                                        legend: ⎇
                                        size: 6
                    name: pinky
            rows:
                mod:
                    skip: false
                bottom: {}
                home: {}
                top: {}
                number:
                    skip: true
            name: matrix
        col:
            key:
                stagger: '-inner_off + index_off'
                splay: +inner_splay - index_splay
            rows:
                mod:
                    skip: true
                number:
                    layers:
                        Qwerty:
                            alt-no-mod: 7
                            shift: '&'
                    mirror:
                        layers:
                            Qwerty:
                                alt-no-mod: 4
                                shift: $
                top:
                    layers:
                        Qwerty: U
                    mirror:
                        layers:
                            Qwerty: R
                home:
                    layers:
                        Qwerty: J
                    mirror:
                        layers:
                            Qwerty: F
                bottom:
                    layers:
                        Qwerty: M
                    mirror:
                        layers:
                            Qwerty: V
            name: index
        row: bottom
        mirrored: false
        bind:
            - 10
            - 10
            - 0
            - 10
matrix_index_home:
    x: 55.4912036
    'y': 8.7736154
    r: 25
    meta:
        stagger: 2.5
        spread: 19
        splay: 0
        origin:
            - 0
            - 0
        orient: 0
        shift:
            - 0
            - 0
        rotate: 0
        adjust: {}
        width: 19
        height: 19
        padding: 19
        autobind: 10
        skip: false
        asym: both
        colrow: index_home
        name: matrix_index_home
        tags:
            1u: true
        layers:
            Qwerty: J
        mirror:
            layers:
                Qwerty: F
        zone:
            key:
                padding: 1ky
                spread: 1kx
                tags:
                    1u: true
            columns:
                inner:
                    key:
                        splay: '-inner_splay'
                    rows:
                        mod:
                            skip: true
                        number:
                            layers:
                                Qwerty:
                                    alt-no-mod: 6
                                    shift: ^
                            mirror:
                                layers:
                                    Qwerty:
                                        alt-no-mod: 5
                                        shift: '%'
                        top:
                            layers:
                                Qwerty: 'Y'
                            mirror:
                                layers:
                                    Qwerty: T
                        home:
                            layers:
                                Qwerty: H
                            mirror:
                                layers:
                                    Qwerty: G
                        bottom:
                            layers:
                                Qwerty: 'N'
                            mirror:
                                layers:
                                    Qwerty: B
                    name: inner
                index:
                    key:
                        stagger: '-inner_off + index_off'
                        splay: +inner_splay - index_splay
                    rows:
                        mod:
                            skip: true
                        number:
                            layers:
                                Qwerty:
                                    alt-no-mod: 7
                                    shift: '&'
                            mirror:
                                layers:
                                    Qwerty:
                                        alt-no-mod: 4
                                        shift: $
                        top:
                            layers:
                                Qwerty: U
                            mirror:
                                layers:
                                    Qwerty: R
                        home:
                            layers:
                                Qwerty: J
                            mirror:
                                layers:
                                    Qwerty: F
                        bottom:
                            layers:
                                Qwerty: M
                            mirror:
                                layers:
                                    Qwerty: V
                    name: index
                middle:
                    key:
                        stagger: '-index_off + middle_off'
                        splay: +index_splay - middle_splay
                        spread: 1kx + 0.8
                    rows:
                        number:
                            layers:
                                Qwerty:
                                    alt-no-mod: 8
                                    shift: '*'
                            mirror:
                                layers:
                                    Qwerty:
                                        alt-no-mod: 3
                                        shift: '#'
                        top:
                            layers:
                                Qwerty: I
                            mirror:
                                layers:
                                    Qwerty: E
                        home:
                            layers:
                                Qwerty: K
                            mirror:
                                layers:
                                    Qwerty: D
                        bottom:
                            layers:
                                Qwerty:
                                    alt-no-mod: ','
                                    shift: <
                            mirror:
                                layers:
                                    Qwerty: C
                        mod:
                            layers:
                                Base:
                                    legend: ⇧
                                    size: 9
                                    keycode: KC_RIGHT_SHIFT
                            mirror:
                                layers:
                                    Base:
                                        keycode: $unset
                    name: middle
                ring:
                    key:
                        stagger: '-middle_off + ring_off'
                        splay: +middle_splay - ring_splay
                        spread: 1kx + 0.04
                    rows:
                        number:
                            layers:
                                Qwerty:
                                    alt-no-mod: 9
                                    shift: (
                            mirror:
                                layers:
                                    Qwerty:
                                        alt-no-mod: 2
                                        shift: '@'
                        top:
                            layers:
                                Qwerty: O
                            mirror:
                                layers:
                                    Qwerty: W
                        home:
                            layers:
                                Qwerty: L
                            mirror:
                                layers:
                                    Qwerty: S
                        bottom:
                            layers:
                                Qwerty:
                                    alt-no-mod: .
                                    shift: '>'
                            mirror:
                                layers:
                                    Qwerty: X
                        mod:
                            layers:
                                Base:
                                    legend: ⎈
                                    size: 9
                            mirror:
                                layers:
                                    Base:
                                        legend: ⎈
                                        size: 9
                    name: ring
                pinky:
                    key:
                        stagger: '-ring_off + pinky_off + 1'
                        splay: +ring_splay - pinky_splay
                        spread: 1kx + 0.035
                    rows:
                        number:
                            layers:
                                Qwerty:
                                    alt-no-mod: 0
                                    shift: )
                            mirror:
                                layers:
                                    Qwerty:
                                        alt-no-mod: 1
                                        shift: '!'
                        top:
                            layers:
                                Qwerty: P
                            mirror:
                                layers:
                                    Qwerty: Q
                        home:
                            layers:
                                Qwerty:
                                    alt-no-mod: ;
                                    shift: ':'
                            mirror:
                                layers:
                                    Qwerty: A
                        bottom:
                            layers:
                                Qwerty:
                                    alt-no-mod: /
                                    shift: '?'
                            mirror:
                                layers:
                                    Qwerty: Z
                        mod:
                            layers:
                                Base:
                                    legend: ❖
                                    size: 8
                            mirror:
                                layers:
                                    Base:
                                        legend: ⎇
                                        size: 6
                    name: pinky
            rows:
                mod:
                    skip: false
                bottom: {}
                home: {}
                top: {}
                number:
                    skip: true
            name: matrix
        col:
            key:
                stagger: '-inner_off + index_off'
                splay: +inner_splay - index_splay
            rows:
                mod:
                    skip: true
                number:
                    layers:
                        Qwerty:
                            alt-no-mod: 7
                            shift: '&'
                    mirror:
                        layers:
                            Qwerty:
                                alt-no-mod: 4
                                shift: $
                top:
                    layers:
                        Qwerty: U
                    mirror:
                        layers:
                            Qwerty: R
                home:
                    layers:
                        Qwerty: J
                    mirror:
                        layers:
                            Qwerty: F
                bottom:
                    layers:
                        Qwerty: M
                    mirror:
                        layers:
                            Qwerty: V
            name: index
        row: home
        mirrored: false
        bind:
            - 10
            - 10
            - 10
            - 10
matrix_index_top:
    x: 47.4614566
    'y': 25.9934634
    r: 25
    meta:
        stagger: 2.5
        spread: 19
        splay: 0
        origin:
            - 0
            - 0
        orient: 0
        shift:
            - 0
            - 0
        rotate: 0
        adjust: {}
        width: 19
        height: 19
        padding: 19
        autobind: 10
        skip: false
        asym: both
        colrow: index_top
        name: matrix_index_top
        tags:
            1u: true
        layers:
            Qwerty: U
        mirror:
            layers:
                Qwerty: R
        zone:
            key:
                padding: 1ky
                spread: 1kx
                tags:
                    1u: true
            columns:
                inner:
                    key:
                        splay: '-inner_splay'
                    rows:
                        mod:
                            skip: true
                        number:
                            layers:
                                Qwerty:
                                    alt-no-mod: 6
                                    shift: ^
                            mirror:
                                layers:
                                    Qwerty:
                                        alt-no-mod: 5
                                        shift: '%'
                        top:
                            layers:
                                Qwerty: 'Y'
                            mirror:
                                layers:
                                    Qwerty: T
                        home:
                            layers:
                                Qwerty: H
                            mirror:
                                layers:
                                    Qwerty: G
                        bottom:
                            layers:
                                Qwerty: 'N'
                            mirror:
                                layers:
                                    Qwerty: B
                    name: inner
                index:
                    key:
                        stagger: '-inner_off + index_off'
                        splay: +inner_splay - index_splay
                    rows:
                        mod:
                            skip: true
                        number:
                            layers:
                                Qwerty:
                                    alt-no-mod: 7
                                    shift: '&'
                            mirror:
                                layers:
                                    Qwerty:
                                        alt-no-mod: 4
                                        shift: $
                        top:
                            layers:
                                Qwerty: U
                            mirror:
                                layers:
                                    Qwerty: R
                        home:
                            layers:
                                Qwerty: J
                            mirror:
                                layers:
                                    Qwerty: F
                        bottom:
                            layers:
                                Qwerty: M
                            mirror:
                                layers:
                                    Qwerty: V
                    name: index
                middle:
                    key:
                        stagger: '-index_off + middle_off'
                        splay: +index_splay - middle_splay
                        spread: 1kx + 0.8
                    rows:
                        number:
                            layers:
                                Qwerty:
                                    alt-no-mod: 8
                                    shift: '*'
                            mirror:
                                layers:
                                    Qwerty:
                                        alt-no-mod: 3
                                        shift: '#'
                        top:
                            layers:
                                Qwerty: I
                            mirror:
                                layers:
                                    Qwerty: E
                        home:
                            layers:
                                Qwerty: K
                            mirror:
                                layers:
                                    Qwerty: D
                        bottom:
                            layers:
                                Qwerty:
                                    alt-no-mod: ','
                                    shift: <
                            mirror:
                                layers:
                                    Qwerty: C
                        mod:
                            layers:
                                Base:
                                    legend: ⇧
                                    size: 9
                                    keycode: KC_RIGHT_SHIFT
                            mirror:
                                layers:
                                    Base:
                                        keycode: $unset
                    name: middle
                ring:
                    key:
                        stagger: '-middle_off + ring_off'
                        splay: +middle_splay - ring_splay
                        spread: 1kx + 0.04
                    rows:
                        number:
                            layers:
                                Qwerty:
                                    alt-no-mod: 9
                                    shift: (
                            mirror:
                                layers:
                                    Qwerty:
                                        alt-no-mod: 2
                                        shift: '@'
                        top:
                            layers:
                                Qwerty: O
                            mirror:
                                layers:
                                    Qwerty: W
                        home:
                            layers:
                                Qwerty: L
                            mirror:
                                layers:
                                    Qwerty: S
                        bottom:
                            layers:
                                Qwerty:
                                    alt-no-mod: .
                                    shift: '>'
                            mirror:
                                layers:
                                    Qwerty: X
                        mod:
                            layers:
                                Base:
                                    legend: ⎈
                                    size: 9
                            mirror:
                                layers:
                                    Base:
                                        legend: ⎈
                                        size: 9
                    name: ring
                pinky:
                    key:
                        stagger: '-ring_off + pinky_off + 1'
                        splay: +ring_splay - pinky_splay
                        spread: 1kx + 0.035
                    rows:
                        number:
                            layers:
                                Qwerty:
                                    alt-no-mod: 0
                                    shift: )
                            mirror:
                                layers:
                                    Qwerty:
                                        alt-no-mod: 1
                                        shift: '!'
                        top:
                            layers:
                                Qwerty: P
                            mirror:
                                layers:
                                    Qwerty: Q
                        home:
                            layers:
                                Qwerty:
                                    alt-no-mod: ;
                                    shift: ':'
                            mirror:
                                layers:
                                    Qwerty: A
                        bottom:
                            layers:
                                Qwerty:
                                    alt-no-mod: /
                                    shift: '?'
                            mirror:
                                layers:
                                    Qwerty: Z
                        mod:
                            layers:
                                Base:
                                    legend: ❖
                                    size: 8
                            mirror:
                                layers:
                                    Base:
                                        legend: ⎇
                                        size: 6
                    name: pinky
            rows:
                mod:
                    skip: false
                bottom: {}
                home: {}
                top: {}
                number:
                    skip: true
            name: matrix
        col:
            key:
                stagger: '-inner_off + index_off'
                splay: +inner_splay - index_splay
            rows:
                mod:
                    skip: true
                number:
                    layers:
                        Qwerty:
                            alt-no-mod: 7
                            shift: '&'
                    mirror:
                        layers:
                            Qwerty:
                                alt-no-mod: 4
                                shift: $
                top:
                    layers:
                        Qwerty: U
                    mirror:
                        layers:
                            Qwerty: R
                home:
                    layers:
                        Qwerty: J
                    mirror:
                        layers:
                            Qwerty: F
                bottom:
                    layers:
                        Qwerty: M
                    mirror:
                        layers:
                            Qwerty: V
            name: index
        row: top
        mirrored: false
        bind:
            - 0
            - 10
            - 10
            - 0
matrix_middle_mod:
    x: 86.748573
    'y': -11.4072383
    r: 20
    meta:
        stagger: 6.5
        spread: 19.8
        splay: -5
        origin:
            - 0
            - 0
        orient: 0
        shift:
            - 0
            - 0
        rotate: 0
        adjust: {}
        width: 19
        height: 19
        padding: 19
        autobind: 10
        skip: false
        asym: both
        colrow: middle_mod
        name: matrix_middle_mod
        tags:
            1u: true
        layers:
            Base:
                legend: ⇧
                size: 9
                keycode: KC_RIGHT_SHIFT
        mirror:
            layers:
                Base:
                    keycode: $unset
        zone:
            key:
                padding: 1ky
                spread: 1kx
                tags:
                    1u: true
            columns:
                inner:
                    key:
                        splay: '-inner_splay'
                    rows:
                        mod:
                            skip: true
                        number:
                            layers:
                                Qwerty:
                                    alt-no-mod: 6
                                    shift: ^
                            mirror:
                                layers:
                                    Qwerty:
                                        alt-no-mod: 5
                                        shift: '%'
                        top:
                            layers:
                                Qwerty: 'Y'
                            mirror:
                                layers:
                                    Qwerty: T
                        home:
                            layers:
                                Qwerty: H
                            mirror:
                                layers:
                                    Qwerty: G
                        bottom:
                            layers:
                                Qwerty: 'N'
                            mirror:
                                layers:
                                    Qwerty: B
                    name: inner
                index:
                    key:
                        stagger: '-inner_off + index_off'
                        splay: +inner_splay - index_splay
                    rows:
                        mod:
                            skip: true
                        number:
                            layers:
                                Qwerty:
                                    alt-no-mod: 7
                                    shift: '&'
                            mirror:
                                layers:
                                    Qwerty:
                                        alt-no-mod: 4
                                        shift: $
                        top:
                            layers:
                                Qwerty: U
                            mirror:
                                layers:
                                    Qwerty: R
                        home:
                            layers:
                                Qwerty: J
                            mirror:
                                layers:
                                    Qwerty: F
                        bottom:
                            layers:
                                Qwerty: M
                            mirror:
                                layers:
                                    Qwerty: V
                    name: index
                middle:
                    key:
                        stagger: '-index_off + middle_off'
                        splay: +index_splay - middle_splay
                        spread: 1kx + 0.8
                    rows:
                        number:
                            layers:
                                Qwerty:
                                    alt-no-mod: 8
                                    shift: '*'
                            mirror:
                                layers:
                                    Qwerty:
                                        alt-no-mod: 3
                                        shift: '#'
                        top:
                            layers:
                                Qwerty: I
                            mirror:
                                layers:
                                    Qwerty: E
                        home:
                            layers:
                                Qwerty: K
                            mirror:
                                layers:
                                    Qwerty: D
                        bottom:
                            layers:
                                Qwerty:
                                    alt-no-mod: ','
                                    shift: <
                            mirror:
                                layers:
                                    Qwerty: C
                        mod:
                            layers:
                                Base:
                                    legend: ⇧
                                    size: 9
                                    keycode: KC_RIGHT_SHIFT
                            mirror:
                                layers:
                                    Base:
                                        keycode: $unset
                    name: middle
                ring:
                    key:
                        stagger: '-middle_off + ring_off'
                        splay: +middle_splay - ring_splay
                        spread: 1kx + 0.04
                    rows:
                        number:
                            layers:
                                Qwerty:
                                    alt-no-mod: 9
                                    shift: (
                            mirror:
                                layers:
                                    Qwerty:
                                        alt-no-mod: 2
                                        shift: '@'
                        top:
                            layers:
                                Qwerty: O
                            mirror:
                                layers:
                                    Qwerty: W
                        home:
                            layers:
                                Qwerty: L
                            mirror:
                                layers:
                                    Qwerty: S
                        bottom:
                            layers:
                                Qwerty:
                                    alt-no-mod: .
                                    shift: '>'
                            mirror:
                                layers:
                                    Qwerty: X
                        mod:
                            layers:
                                Base:
                                    legend: ⎈
                                    size: 9
                            mirror:
                                layers:
                                    Base:
                                        legend: ⎈
                                        size: 9
                    name: ring
                pinky:
                    key:
                        stagger: '-ring_off + pinky_off + 1'
                        splay: +ring_splay - pinky_splay
                        spread: 1kx + 0.035
                    rows:
                        number:
                            layers:
                                Qwerty:
                                    alt-no-mod: 0
                                    shift: )
                            mirror:
                                layers:
                                    Qwerty:
                                        alt-no-mod: 1
                                        shift: '!'
                        top:
                            layers:
                                Qwerty: P
                            mirror:
                                layers:
                                    Qwerty: Q
                        home:
                            layers:
                                Qwerty:
                                    alt-no-mod: ;
                                    shift: ':'
                            mirror:
                                layers:
                                    Qwerty: A
                        bottom:
                            layers:
                                Qwerty:
                                    alt-no-mod: /
                                    shift: '?'
                            mirror:
                                layers:
                                    Qwerty: Z
                        mod:
                            layers:
                                Base:
                                    legend: ❖
                                    size: 8
                            mirror:
                                layers:
                                    Base:
                                        legend: ⎇
                                        size: 6
                    name: pinky
            rows:
                mod:
                    skip: false
                bottom: {}
                home: {}
                top: {}
                number:
                    skip: true
            name: matrix
        col:
            key:
                stagger: '-index_off + middle_off'
                splay: +index_splay - middle_splay
                spread: 1kx + 0.8
            rows:
                number:
                    layers:
                        Qwerty:
                            alt-no-mod: 8
                            shift: '*'
                    mirror:
                        layers:
                            Qwerty:
                                alt-no-mod: 3
                                shift: '#'
                top:
                    layers:
                        Qwerty: I
                    mirror:
                        layers:
                            Qwerty: E
                home:
                    layers:
                        Qwerty: K
                    mirror:
                        layers:
                            Qwerty: D
                bottom:
                    layers:
                        Qwerty:
                            alt-no-mod: ','
                            shift: <
                    mirror:
                        layers:
                            Qwerty: C
                mod:
                    layers:
                        Base:
                            legend: ⇧
                            size: 9
                            keycode: KC_RIGHT_SHIFT
                    mirror:
                        layers:
                            Base:
                                keycode: $unset
            name: middle
        row: mod
        mirrored: false
        bind:
            - 10
            - 10
            - 0
            - 0
matrix_middle_bottom:
    x: 80.2501902
    'y': 6.4469215
    r: 20
    meta:
        stagger: 6.5
        spread: 19.8
        splay: -5
        origin:
            - 0
            - 0
        orient: 0
        shift:
            - 0
            - 0
        rotate: 0
        adjust: {}
        width: 19
        height: 19
        padding: 19
        autobind: 10
        skip: false
        asym: both
        colrow: middle_bottom
        name: matrix_middle_bottom
        tags:
            1u: true
        layers:
            Qwerty:
                alt-no-mod: ','
                shift: <
        mirror:
            layers:
                Qwerty: C
        zone:
            key:
                padding: 1ky
                spread: 1kx
                tags:
                    1u: true
            columns:
                inner:
                    key:
                        splay: '-inner_splay'
                    rows:
                        mod:
                            skip: true
                        number:
                            layers:
                                Qwerty:
                                    alt-no-mod: 6
                                    shift: ^
                            mirror:
                                layers:
                                    Qwerty:
                                        alt-no-mod: 5
                                        shift: '%'
                        top:
                            layers:
                                Qwerty: 'Y'
                            mirror:
                                layers:
                                    Qwerty: T
                        home:
                            layers:
                                Qwerty: H
                            mirror:
                                layers:
                                    Qwerty: G
                        bottom:
                            layers:
                                Qwerty: 'N'
                            mirror:
                                layers:
                                    Qwerty: B
                    name: inner
                index:
                    key:
                        stagger: '-inner_off + index_off'
                        splay: +inner_splay - index_splay
                    rows:
                        mod:
                            skip: true
                        number:
                            layers:
                                Qwerty:
                                    alt-no-mod: 7
                                    shift: '&'
                            mirror:
                                layers:
                                    Qwerty:
                                        alt-no-mod: 4
                                        shift: $
                        top:
                            layers:
                                Qwerty: U
                            mirror:
                                layers:
                                    Qwerty: R
                        home:
                            layers:
                                Qwerty: J
                            mirror:
                                layers:
                                    Qwerty: F
                        bottom:
                            layers:
                                Qwerty: M
                            mirror:
                                layers:
                                    Qwerty: V
                    name: index
                middle:
                    key:
                        stagger: '-index_off + middle_off'
                        splay: +index_splay - middle_splay
                        spread: 1kx + 0.8
                    rows:
                        number:
                            layers:
                                Qwerty:
                                    alt-no-mod: 8
                                    shift: '*'
                            mirror:
                                layers:
                                    Qwerty:
                                        alt-no-mod: 3
                                        shift: '#'
                        top:
                            layers:
                                Qwerty: I
                            mirror:
                                layers:
                                    Qwerty: E
                        home:
                            layers:
                                Qwerty: K
                            mirror:
                                layers:
                                    Qwerty: D
                        bottom:
                            layers:
                                Qwerty:
                                    alt-no-mod: ','
                                    shift: <
                            mirror:
                                layers:
                                    Qwerty: C
                        mod:
                            layers:
                                Base:
                                    legend: ⇧
                                    size: 9
                                    keycode: KC_RIGHT_SHIFT
                            mirror:
                                layers:
                                    Base:
                                        keycode: $unset
                    name: middle
                ring:
                    key:
                        stagger: '-middle_off + ring_off'
                        splay: +middle_splay - ring_splay
                        spread: 1kx + 0.04
                    rows:
                        number:
                            layers:
                                Qwerty:
                                    alt-no-mod: 9
                                    shift: (
                            mirror:
                                layers:
                                    Qwerty:
                                        alt-no-mod: 2
                                        shift: '@'
                        top:
                            layers:
                                Qwerty: O
                            mirror:
                                layers:
                                    Qwerty: W
                        home:
                            layers:
                                Qwerty: L
                            mirror:
                                layers:
                                    Qwerty: S
                        bottom:
                            layers:
                                Qwerty:
                                    alt-no-mod: .
                                    shift: '>'
                            mirror:
                                layers:
                                    Qwerty: X
                        mod:
                            layers:
                                Base:
                                    legend: ⎈
                                    size: 9
                            mirror:
                                layers:
                                    Base:
                                        legend: ⎈
                                        size: 9
                    name: ring
                pinky:
                    key:
                        stagger: '-ring_off + pinky_off + 1'
                        splay: +ring_splay - pinky_splay
                        spread: 1kx + 0.035
                    rows:
                        number:
                            layers:
                                Qwerty:
                                    alt-no-mod: 0
                                    shift: )
                            mirror:
                                layers:
                                    Qwerty:
                                        alt-no-mod: 1
                                        shift: '!'
                        top:
                            layers:
                                Qwerty: P
                            mirror:
                                layers:
                                    Qwerty: Q
                        home:
                            layers:
                                Qwerty:
                                    alt-no-mod: ;
                                    shift: ':'
                            mirror:
                                layers:
                                    Qwerty: A
                        bottom:
                            layers:
                                Qwerty:
                                    alt-no-mod: /
                                    shift: '?'
                            mirror:
                                layers:
                                    Qwerty: Z
                        mod:
                            layers:
                                Base:
                                    legend: ❖
                                    size: 8
                            mirror:
                                layers:
                                    Base:
                                        legend: ⎇
                                        size: 6
                    name: pinky
            rows:
                mod:
                    skip: false
                bottom: {}
                home: {}
                top: {}
                number:
                    skip: true
            name: matrix
        col:
            key:
                stagger: '-index_off + middle_off'
                splay: +index_splay - middle_splay
                spread: 1kx + 0.8
            rows:
                number:
                    layers:
                        Qwerty:
                            alt-no-mod: 8
                            shift: '*'
                    mirror:
                        layers:
                            Qwerty:
                                alt-no-mod: 3
                                shift: '#'
                top:
                    layers:
                        Qwerty: I
                    mirror:
                        layers:
                            Qwerty: E
                home:
                    layers:
                        Qwerty: K
                    mirror:
                        layers:
                            Qwerty: D
                bottom:
                    layers:
                        Qwerty:
                            alt-no-mod: ','
                            shift: <
                    mirror:
                        layers:
                            Qwerty: C
                mod:
                    layers:
                        Base:
                            legend: ⇧
                            size: 9
                            keycode: KC_RIGHT_SHIFT
                    mirror:
                        layers:
                            Base:
                                keycode: $unset
            name: middle
        row: bottom
        mirrored: false
        bind:
            - 10
            - 10
            - 10
            - 10
matrix_middle_home:
    x: 73.7518075
    'y': 24.3010814
    r: 20
    meta:
        stagger: 6.5
        spread: 19.8
        splay: -5
        origin:
            - 0
            - 0
        orient: 0
        shift:
            - 0
            - 0
        rotate: 0
        adjust: {}
        width: 19
        height: 19
        padding: 19
        autobind: 10
        skip: false
        asym: both
        colrow: middle_home
        name: matrix_middle_home
        tags:
            1u: true
        layers:
            Qwerty: K
        mirror:
            layers:
                Qwerty: D
        zone:
            key:
                padding: 1ky
                spread: 1kx
                tags:
                    1u: true
            columns:
                inner:
                    key:
                        splay: '-inner_splay'
                    rows:
                        mod:
                            skip: true
                        number:
                            layers:
                                Qwerty:
                                    alt-no-mod: 6
                                    shift: ^
                            mirror:
                                layers:
                                    Qwerty:
                                        alt-no-mod: 5
                                        shift: '%'
                        top:
                            layers:
                                Qwerty: 'Y'
                            mirror:
                                layers:
                                    Qwerty: T
                        home:
                            layers:
                                Qwerty: H
                            mirror:
                                layers:
                                    Qwerty: G
                        bottom:
                            layers:
                                Qwerty: 'N'
                            mirror:
                                layers:
                                    Qwerty: B
                    name: inner
                index:
                    key:
                        stagger: '-inner_off + index_off'
                        splay: +inner_splay - index_splay
                    rows:
                        mod:
                            skip: true
                        number:
                            layers:
                                Qwerty:
                                    alt-no-mod: 7
                                    shift: '&'
                            mirror:
                                layers:
                                    Qwerty:
                                        alt-no-mod: 4
                                        shift: $
                        top:
                            layers:
                                Qwerty: U
                            mirror:
                                layers:
                                    Qwerty: R
                        home:
                            layers:
                                Qwerty: J
                            mirror:
                                layers:
                                    Qwerty: F
                        bottom:
                            layers:
                                Qwerty: M
                            mirror:
                                layers:
                                    Qwerty: V
                    name: index
                middle:
                    key:
                        stagger: '-index_off + middle_off'
                        splay: +index_splay - middle_splay
                        spread: 1kx + 0.8
                    rows:
                        number:
                            layers:
                                Qwerty:
                                    alt-no-mod: 8
                                    shift: '*'
                            mirror:
                                layers:
                                    Qwerty:
                                        alt-no-mod: 3
                                        shift: '#'
                        top:
                            layers:
                                Qwerty: I
                            mirror:
                                layers:
                                    Qwerty: E
                        home:
                            layers:
                                Qwerty: K
                            mirror:
                                layers:
                                    Qwerty: D
                        bottom:
                            layers:
                                Qwerty:
                                    alt-no-mod: ','
                                    shift: <
                            mirror:
                                layers:
                                    Qwerty: C
                        mod:
                            layers:
                                Base:
                                    legend: ⇧
                                    size: 9
                                    keycode: KC_RIGHT_SHIFT
                            mirror:
                                layers:
                                    Base:
                                        keycode: $unset
                    name: middle
                ring:
                    key:
                        stagger: '-middle_off + ring_off'
                        splay: +middle_splay - ring_splay
                        spread: 1kx + 0.04
                    rows:
                        number:
                            layers:
                                Qwerty:
                                    alt-no-mod: 9
                                    shift: (
                            mirror:
                                layers:
                                    Qwerty:
                                        alt-no-mod: 2
                                        shift: '@'
                        top:
                            layers:
                                Qwerty: O
                            mirror:
                                layers:
                                    Qwerty: W
                        home:
                            layers:
                                Qwerty: L
                            mirror:
                                layers:
                                    Qwerty: S
                        bottom:
                            layers:
                                Qwerty:
                                    alt-no-mod: .
                                    shift: '>'
                            mirror:
                                layers:
                                    Qwerty: X
                        mod:
                            layers:
                                Base:
                                    legend: ⎈
                                    size: 9
                            mirror:
                                layers:
                                    Base:
                                        legend: ⎈
                                        size: 9
                    name: ring
                pinky:
                    key:
                        stagger: '-ring_off + pinky_off + 1'
                        splay: +ring_splay - pinky_splay
                        spread: 1kx + 0.035
                    rows:
                        number:
                            layers:
                                Qwerty:
                                    alt-no-mod: 0
                                    shift: )
                            mirror:
                                layers:
                                    Qwerty:
                                        alt-no-mod: 1
                                        shift: '!'
                        top:
                            layers:
                                Qwerty: P
                            mirror:
                                layers:
                                    Qwerty: Q
                        home:
                            layers:
                                Qwerty:
                                    alt-no-mod: ;
                                    shift: ':'
                            mirror:
                                layers:
                                    Qwerty: A
                        bottom:
                            layers:
                                Qwerty:
                                    alt-no-mod: /
                                    shift: '?'
                            mirror:
                                layers:
                                    Qwerty: Z
                        mod:
                            layers:
                                Base:
                                    legend: ❖
                                    size: 8
                            mirror:
                                layers:
                                    Base:
                                        legend: ⎇
                                        size: 6
                    name: pinky
            rows:
                mod:
                    skip: false
                bottom: {}
                home: {}
                top: {}
                number:
                    skip: true
            name: matrix
        col:
            key:
                stagger: '-index_off + middle_off'
                splay: +index_splay - middle_splay
                spread: 1kx + 0.8
            rows:
                number:
                    layers:
                        Qwerty:
                            alt-no-mod: 8
                            shift: '*'
                    mirror:
                        layers:
                            Qwerty:
                                alt-no-mod: 3
                                shift: '#'
                top:
                    layers:
                        Qwerty: I
                    mirror:
                        layers:
                            Qwerty: E
                home:
                    layers:
                        Qwerty: K
                    mirror:
                        layers:
                            Qwerty: D
                bottom:
                    layers:
                        Qwerty:
                            alt-no-mod: ','
                            shift: <
                    mirror:
                        layers:
                            Qwerty: C
                mod:
                    layers:
                        Base:
                            legend: ⇧
                            size: 9
                            keycode: KC_RIGHT_SHIFT
                    mirror:
                        layers:
                            Base:
                                keycode: $unset
            name: middle
        row: home
        mirrored: false
        bind:
            - 10
            - 10
            - 10
            - 10
matrix_middle_top:
    x: 67.2534247
    'y': 42.1552412
    r: 20
    meta:
        stagger: 6.5
        spread: 19.8
        splay: -5
        origin:
            - 0
            - 0
        orient: 0
        shift:
            - 0
            - 0
        rotate: 0
        adjust: {}
        width: 19
        height: 19
        padding: 19
        autobind: 10
        skip: false
        asym: both
        colrow: middle_top
        name: matrix_middle_top
        tags:
            1u: true
        layers:
            Qwerty: I
        mirror:
            layers:
                Qwerty: E
        zone:
            key:
                padding: 1ky
                spread: 1kx
                tags:
                    1u: true
            columns:
                inner:
                    key:
                        splay: '-inner_splay'
                    rows:
                        mod:
                            skip: true
                        number:
                            layers:
                                Qwerty:
                                    alt-no-mod: 6
                                    shift: ^
                            mirror:
                                layers:
                                    Qwerty:
                                        alt-no-mod: 5
                                        shift: '%'
                        top:
                            layers:
                                Qwerty: 'Y'
                            mirror:
                                layers:
                                    Qwerty: T
                        home:
                            layers:
                                Qwerty: H
                            mirror:
                                layers:
                                    Qwerty: G
                        bottom:
                            layers:
                                Qwerty: 'N'
                            mirror:
                                layers:
                                    Qwerty: B
                    name: inner
                index:
                    key:
                        stagger: '-inner_off + index_off'
                        splay: +inner_splay - index_splay
                    rows:
                        mod:
                            skip: true
                        number:
                            layers:
                                Qwerty:
                                    alt-no-mod: 7
                                    shift: '&'
                            mirror:
                                layers:
                                    Qwerty:
                                        alt-no-mod: 4
                                        shift: $
                        top:
                            layers:
                                Qwerty: U
                            mirror:
                                layers:
                                    Qwerty: R
                        home:
                            layers:
                                Qwerty: J
                            mirror:
                                layers:
                                    Qwerty: F
                        bottom:
                            layers:
                                Qwerty: M
                            mirror:
                                layers:
                                    Qwerty: V
                    name: index
                middle:
                    key:
                        stagger: '-index_off + middle_off'
                        splay: +index_splay - middle_splay
                        spread: 1kx + 0.8
                    rows:
                        number:
                            layers:
                                Qwerty:
                                    alt-no-mod: 8
                                    shift: '*'
                            mirror:
                                layers:
                                    Qwerty:
                                        alt-no-mod: 3
                                        shift: '#'
                        top:
                            layers:
                                Qwerty: I
                            mirror:
                                layers:
                                    Qwerty: E
                        home:
                            layers:
                                Qwerty: K
                            mirror:
                                layers:
                                    Qwerty: D
                        bottom:
                            layers:
                                Qwerty:
                                    alt-no-mod: ','
                                    shift: <
                            mirror:
                                layers:
                                    Qwerty: C
                        mod:
                            layers:
                                Base:
                                    legend: ⇧
                                    size: 9
                                    keycode: KC_RIGHT_SHIFT
                            mirror:
                                layers:
                                    Base:
                                        keycode: $unset
                    name: middle
                ring:
                    key:
                        stagger: '-middle_off + ring_off'
                        splay: +middle_splay - ring_splay
                        spread: 1kx + 0.04
                    rows:
                        number:
                            layers:
                                Qwerty:
                                    alt-no-mod: 9
                                    shift: (
                            mirror:
                                layers:
                                    Qwerty:
                                        alt-no-mod: 2
                                        shift: '@'
                        top:
                            layers:
                                Qwerty: O
                            mirror:
                                layers:
                                    Qwerty: W
                        home:
                            layers:
                                Qwerty: L
                            mirror:
                                layers:
                                    Qwerty: S
                        bottom:
                            layers:
                                Qwerty:
                                    alt-no-mod: .
                                    shift: '>'
                            mirror:
                                layers:
                                    Qwerty: X
                        mod:
                            layers:
                                Base:
                                    legend: ⎈
                                    size: 9
                            mirror:
                                layers:
                                    Base:
                                        legend: ⎈
                                        size: 9
                    name: ring
                pinky:
                    key:
                        stagger: '-ring_off + pinky_off + 1'
                        splay: +ring_splay - pinky_splay
                        spread: 1kx + 0.035
                    rows:
                        number:
                            layers:
                                Qwerty:
                                    alt-no-mod: 0
                                    shift: )
                            mirror:
                                layers:
                                    Qwerty:
                                        alt-no-mod: 1
                                        shift: '!'
                        top:
                            layers:
                                Qwerty: P
                            mirror:
                                layers:
                                    Qwerty: Q
                        home:
                            layers:
                                Qwerty:
                                    alt-no-mod: ;
                                    shift: ':'
                            mirror:
                                layers:
                                    Qwerty: A
                        bottom:
                            layers:
                                Qwerty:
                                    alt-no-mod: /
                                    shift: '?'
                            mirror:
                                layers:
                                    Qwerty: Z
                        mod:
                            layers:
                                Base:
                                    legend: ❖
                                    size: 8
                            mirror:
                                layers:
                                    Base:
                                        legend: ⎇
                                        size: 6
                    name: pinky
            rows:
                mod:
                    skip: false
                bottom: {}
                home: {}
                top: {}
                number:
                    skip: true
            name: matrix
        col:
            key:
                stagger: '-index_off + middle_off'
                splay: +index_splay - middle_splay
                spread: 1kx + 0.8
            rows:
                number:
                    layers:
                        Qwerty:
                            alt-no-mod: 8
                            shift: '*'
                    mirror:
                        layers:
                            Qwerty:
                                alt-no-mod: 3
                                shift: '#'
                top:
                    layers:
                        Qwerty: I
                    mirror:
                        layers:
                            Qwerty: E
                home:
                    layers:
                        Qwerty: K
                    mirror:
                        layers:
                            Qwerty: D
                bottom:
                    layers:
                        Qwerty:
                            alt-no-mod: ','
                            shift: <
                    mirror:
                        layers:
                            Qwerty: C
                mod:
                    layers:
                        Base:
                            legend: ⇧
                            size: 9
                            keycode: KC_RIGHT_SHIFT
                    mirror:
                        layers:
                            Base:
                                keycode: $unset
            name: middle
        row: top
        mirrored: false
        bind:
            - 0
            - 0
            - 10
            - 0
matrix_ring_mod:
    x: 107.9059288
    'y': -13.8673599
    r: 15
    meta:
        stagger: -9.548
        spread: 19.04
        splay: -5
        origin:
            - 0
            - 0
        orient: 0
        shift:
            - 0
            - 0
        rotate: 0
        adjust: {}
        width: 19
        height: 19
        padding: 19
        autobind: 10
        skip: false
        asym: both
        colrow: ring_mod
        name: matrix_ring_mod
        tags:
            1u: true
        layers:
            Base:
                legend: ⎈
                size: 9
        mirror:
            layers:
                Base:
                    legend: ⎈
                    size: 9
        zone:
            key:
                padding: 1ky
                spread: 1kx
                tags:
                    1u: true
            columns:
                inner:
                    key:
                        splay: '-inner_splay'
                    rows:
                        mod:
                            skip: true
                        number:
                            layers:
                                Qwerty:
                                    alt-no-mod: 6
                                    shift: ^
                            mirror:
                                layers:
                                    Qwerty:
                                        alt-no-mod: 5
                                        shift: '%'
                        top:
                            layers:
                                Qwerty: 'Y'
                            mirror:
                                layers:
                                    Qwerty: T
                        home:
                            layers:
                                Qwerty: H
                            mirror:
                                layers:
                                    Qwerty: G
                        bottom:
                            layers:
                                Qwerty: 'N'
                            mirror:
                                layers:
                                    Qwerty: B
                    name: inner
                index:
                    key:
                        stagger: '-inner_off + index_off'
                        splay: +inner_splay - index_splay
                    rows:
                        mod:
                            skip: true
                        number:
                            layers:
                                Qwerty:
                                    alt-no-mod: 7
                                    shift: '&'
                            mirror:
                                layers:
                                    Qwerty:
                                        alt-no-mod: 4
                                        shift: $
                        top:
                            layers:
                                Qwerty: U
                            mirror:
                                layers:
                                    Qwerty: R
                        home:
                            layers:
                                Qwerty: J
                            mirror:
                                layers:
                                    Qwerty: F
                        bottom:
                            layers:
                                Qwerty: M
                            mirror:
                                layers:
                                    Qwerty: V
                    name: index
                middle:
                    key:
                        stagger: '-index_off + middle_off'
                        splay: +index_splay - middle_splay
                        spread: 1kx + 0.8
                    rows:
                        number:
                            layers:
                                Qwerty:
                                    alt-no-mod: 8
                                    shift: '*'
                            mirror:
                                layers:
                                    Qwerty:
                                        alt-no-mod: 3
                                        shift: '#'
                        top:
                            layers:
                                Qwerty: I
                            mirror:
                                layers:
                                    Qwerty: E
                        home:
                            layers:
                                Qwerty: K
                            mirror:
                                layers:
                                    Qwerty: D
                        bottom:
                            layers:
                                Qwerty:
                                    alt-no-mod: ','
                                    shift: <
                            mirror:
                                layers:
                                    Qwerty: C
                        mod:
                            layers:
                                Base:
                                    legend: ⇧
                                    size: 9
                                    keycode: KC_RIGHT_SHIFT
                            mirror:
                                layers:
                                    Base:
                                        keycode: $unset
                    name: middle
                ring:
                    key:
                        stagger: '-middle_off + ring_off'
                        splay: +middle_splay - ring_splay
                        spread: 1kx + 0.04
                    rows:
                        number:
                            layers:
                                Qwerty:
                                    alt-no-mod: 9
                                    shift: (
                            mirror:
                                layers:
                                    Qwerty:
                                        alt-no-mod: 2
                                        shift: '@'
                        top:
                            layers:
                                Qwerty: O
                            mirror:
                                layers:
                                    Qwerty: W
                        home:
                            layers:
                                Qwerty: L
                            mirror:
                                layers:
                                    Qwerty: S
                        bottom:
                            layers:
                                Qwerty:
                                    alt-no-mod: .
                                    shift: '>'
                            mirror:
                                layers:
                                    Qwerty: X
                        mod:
                            layers:
                                Base:
                                    legend: ⎈
                                    size: 9
                            mirror:
                                layers:
                                    Base:
                                        legend: ⎈
                                        size: 9
                    name: ring
                pinky:
                    key:
                        stagger: '-ring_off + pinky_off + 1'
                        splay: +ring_splay - pinky_splay
                        spread: 1kx + 0.035
                    rows:
                        number:
                            layers:
                                Qwerty:
                                    alt-no-mod: 0
                                    shift: )
                            mirror:
                                layers:
                                    Qwerty:
                                        alt-no-mod: 1
                                        shift: '!'
                        top:
                            layers:
                                Qwerty: P
                            mirror:
                                layers:
                                    Qwerty: Q
                        home:
                            layers:
                                Qwerty:
                                    alt-no-mod: ;
                                    shift: ':'
                            mirror:
                                layers:
                                    Qwerty: A
                        bottom:
                            layers:
                                Qwerty:
                                    alt-no-mod: /
                                    shift: '?'
                            mirror:
                                layers:
                                    Qwerty: Z
                        mod:
                            layers:
                                Base:
                                    legend: ❖
                                    size: 8
                            mirror:
                                layers:
                                    Base:
                                        legend: ⎇
                                        size: 6
                    name: pinky
            rows:
                mod:
                    skip: false
                bottom: {}
                home: {}
                top: {}
                number:
                    skip: true
            name: matrix
        col:
            key:
                stagger: '-middle_off + ring_off'
                splay: +middle_splay - ring_splay
                spread: 1kx + 0.04
            rows:
                number:
                    layers:
                        Qwerty:
                            alt-no-mod: 9
                            shift: (
                    mirror:
                        layers:
                            Qwerty:
                                alt-no-mod: 2
                                shift: '@'
                top:
                    layers:
                        Qwerty: O
                    mirror:
                        layers:
                            Qwerty: W
                home:
                    layers:
                        Qwerty: L
                    mirror:
                        layers:
                            Qwerty: S
                bottom:
                    layers:
                        Qwerty:
                            alt-no-mod: .
                            shift: '>'
                    mirror:
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
