AxelVoitier/keebs/Framework/HandyWork-5x3-with-mods-with-nav/HandyWork-5x3-with-mods-with-nav.yaml

units:
  kx: u
  ky: u
  inner_off: -2.5
  index_off: -2.5
  middle_off: 6.5
  ring_off: -(4/25)U
  pinky_off: -1.1U
  outer_off: 0
  inner_splay: 0
  index_splay: 0
  middle_splay: 5
  ring_splay: 10
  pinky_splay: 20
  outer_splay: 0
  split_x_offset: 2kx - 3
  split_y_offset: -3ky + 1
  split_angle: 25
  nav_cluster_x_offset: -1kx
  nav_cluster_y_offset: -0.9ky
  mil: 0.0254
points:
  key:
    width: kx
    height: ky
  zones:
    matrix:
      mirror: 0
      anchor:
        shift:
        - split_x_offset
        - split_y_offset
      rotate: split_angle
      key:
        padding: 1ky
        spread: 1kx
        tags:
          1u: true
      columns:
        inner:
          key:
            splay: -inner_splay
            mirror:
              qmk:
                col: C5
            qmk:
              col: C9
          rows:
            mod:
              skip: true
            number:
              layers:
                Qwerty:
                  alt-no-mod: 6
                  shift: ^
              mirror:
                layers:
                  Qwerty:
                    alt-no-mod: 5
                    shift: '%'
            top:
              layers:
                Qwerty: Y
                Sym1: '*'
                Num: '*'
                Nav: "\u21DE"
              mirror:
                layers:
                  Qwerty: T
                  Sym1: $unset
                  Num: $unset
                  Nav: $unset
                  Fun: Pause
            home:
              layers:
                Qwerty: H
                Sym1: '='
                Num:
                  no-mod: .
                  shift: ','
                Nav: "\u21F1"
              mirror:
                layers:
                  Qwerty: G
                  Sym1: '@'
                  Num: $unset
                  Nav: $unset
                  Fun:
                    legend: PrtScn
                    size: 1
            bottom:
              layers:
                Qwerty: N
                Sym1:
                  no-mod: /
                  shift: '?'
                Num: /
                Nav: "\u21DF"
              mirror:
                layers:
                  Qwerty: B
                  Sym1: \
                  Num:
                    legend: Boot
                    size: 2
                  Nav: $unset
                  Fun:
                    legend: ScrLock
                    size: 1
        index:
          key:
            stagger: -inner_off + index_off
            splay: +inner_splay - index_splay
            mirror:
              qmk:
                col: C4
            qmk:
              col: C10
          rows:
            mod:
              skip: true
            number:
              layers:
                Qwerty:
                  alt-no-mod: 7
                  shift: '&'
              mirror:
                layers:
                  Qwerty:
                    alt-no-mod: 4
                    shift: $
            top:
              layers:
                Qwerty: U
                Sym1: '?'
                Num: 7
                Nav:
                  legend: Prev
                  size: 2
              mirror:
                layers:
                  Qwerty: R
                  Sym1: '|'
                  Num:
                    legend: LED_SPDU
                    size: 1
                  Nav: $unset
                  Fun: F4
            home:
              layers:
                Qwerty: J
                Sym1: )
                Num: 4
                Nav:
                  legend: "\u25C0"
                  size: 3
              mirror:
                layers:
                  Qwerty: F
                  Sym1: (
                  Num: $unset
                  Nav: $unset
                  Fun: F8
            bottom:
              layers:
                Qwerty: M
                Sym1: '#'
                Num: 1
                Nav:
                  legend: "\u2423\u25C0"
                  size: 2
                  keycode: LCTL(KC_LEFT)
              mirror:
                layers:
                  Qwerty: V
                  Sym1: $
                  Num:
                    legend: LED_SPDD
                    size: 1
                  Nav: $unset
                  Fun: F12
        middle:
          key:
            stagger: -index_off + middle_off
            splay: +index_splay - middle_splay
            spread: 1kx + 0.4
            mirror:
              qmk:
                col: C3
            qmk:
              col: C11
          rows:
            mod:
              layers:
                Base:
                  legend: "\u21E7"
                  size: 9
                  keycode: KC_RIGHT_SHIFT
              mirror:
                layers:
                  Base:
                    keycode: $unset
            number:
              layers:
                Qwerty:
                  alt-no-mod: 8
                  shift: '*'
              mirror:
                layers:
                  Qwerty:
                    alt-no-mod: 3
                    shift: '#'
            top:
              layers:
                Qwerty: I
                Sym1: '!'
                Num: 8
                Nav: "\u25B2"
              mirror:
                layers:
                  Qwerty: E
                  Sym1: ^
                  Num:
                    legend: LED_BRIU
                    size: 1
                  Nav: $unset
                  Fun: F3
            home:
              layers:
                Qwerty: K
                Sym1: ']'
                Num: 5
                Nav: "\u25BC"
              mirror:
                layers:
                  Qwerty: D
                  Sym1: '['
                  Num: $unset
                  Nav: $unset
                  Fun: F7
            bottom:
              layers:
                Qwerty:
                  alt-no-mod: ','
                  shift: <
                Sym1: ;
                Num: 2
                Nav: "\u25BC"
              mirror:
                layers:
                  Qwerty: C
                  Sym1: '&'
                  Num:
                    legend: LED_BRID
                    size: 1
                  Nav: $unset
                  Fun: F11
        ring:
          key:
            stagger: -middle_off + ring_off
            splay: +middle_splay - ring_splay
            spread: 1kx + 0.44
            mirror:
              qmk:
                col: C2
            qmk:
              col: C12
          rows:
            mod:
              layers:
                Base:
                  legend: "\u2388"
                  size: 9
              mirror:
                layers:
                  Base:
                    legend: "\u2388"
                    size: 9
            number:
              layers:
                Qwerty:
                  alt-no-mod: 9
                  shift: (
              mirror:
                layers:
                  Qwerty:
                    alt-no-mod: 2
                    shift: '@'
            top:
              layers:
                Qwerty: O
                Sym1: '%'
                Num: 9
                Nav:
                  legend: Next
                  size: 2
              mirror:
                layers:
                  Qwerty: W
                  Sym1: '~'
                  Num:
                    legend: LED_NEXT
                    size: 1
                  Nav: $unset
                  Fun: F2
            home:
              layers:
                Qwerty: L
                Sym1: '}'
                Num: 6
                Nav:
                  legend: "\u25B6"
                  size: 3
              mirror:
                layers:
                  Qwerty: S
                  Sym1: '{'
                  Num: $unset
                  Nav: $unset
                  Fun: F6
            bottom:
              layers:
                Qwerty:
                  alt-no-mod: .
                  shift: '>'
                Sym1: ':'
                Num: 3
                Nav:
                  legend: "\u25B6\u2423"
                  size: 2
                  keycode: LCTL(KC_RIGHT)
              mirror:
                layers:
                  Qwerty: X
                  Sym1: $unset
                  Num:
                    legend: LED_PREV
                    size: 1
                  Nav: $unset
                  Fun: F10
        pinky:
          key:
            stagger: -ring_off + pinky_off + 1
            splay: +ring_splay - pinky_splay
            spread: 0.95kx
            mirror:
              qmk:
                col: C1
            qmk:
              col: C13
          rows:
            mod:
              layers:
                Base:
                  legend: "\u2756"
                  size: 8
              mirror:
                layers:
                  Base:
                    legend: "\u2387"
                    size: 6
              qmk:
                row: R5
            number:
              layers:
                Qwerty:
                  alt-no-mod: 0
                  shift: )
              mirror:
                layers:
                  Qwerty:
                    alt-no-mod: 1
                    shift: '!'
            top:
              layers:
                Qwerty: P
                Sym1: '-'
                Num: '-'
                Nav:
                  legend: V+
                  size: 3
              mirror:
                layers:
                  Qwerty: Q
                  Sym1: '`'
                  Num:
                    legend: LED_ON
                    size: 1
                  Nav: $unset
                  Fun: F1
              qmk:
                row: R2
            home:
              layers:
                Qwerty:
                  alt-no-mod: ;
                  shift: ':'
                Sym1: '>'
                Num: 0
                Nav: "\u21F2"
              mirror:
                layers:
                  Qwerty: A
                  Sym1: <
                  Num:
                    legend: LED_TOGGLE
                    size: 1
                  Nav: $unset
                  Fun: F5
              qmk:
                row: R3
            bottom:
              layers:
                Qwerty:
                  alt-no-mod: /
                  shift: '?'
                Sym1: +
                Num: +
                Nav:
                  legend: V-
                  size: 3
              mirror:
                layers:
                  Qwerty: Z
                  Sym1: $unset
                  Num:
                    legend: LED_OFF
                    size: 1
                  Nav: $unset
                  Fun: F9
              qmk:
                row: R4
        outer:
          key:
            stagger: -pinky_off + outer_off
            splay: +pinky_splay - outer_splay
          $skip: true
      rows:
        mod:
          skip: false
          layers:
            transparent: true
          qmk:
            row: R4
        bottom:
          qmk:
            row: R3
        home:
          qmk:
            row: R2
        top:
          qmk:
            row: R1
        number:
          skip: true
    thumb_cluster:
      anchor:
        ref: matrix_inner_bottom
        orient: -split_angle
        shift:
        - 5
        - -23
      mirror: 0
      key:
        padding: 1ky
        spread: 0
        tags:
          1u: true
        layers:
          transparent: true
        qmk:
          row: R5
      columns:
        outer:
          key:
            shift:
            - -kx-4
            - 1
            rotate: split_angle + 12
            layers:
              Base:
                legend: "\u23CE"
                size: 9
              Sym1:
                legend: Ins
                size: 2
              Nav:
                legend: "\u25A0"
                size: 4
              on_hold: Fun
            mirror:
              layers:
                Base: "\u21E5"
                Sym1: $unset
                on_hold: Num
                Nav: $unset
              qmk:
                col: C6
            qmk:
              col: C8
        under:
          key:
            shift:
            - 0
            - 0
            layers:
              Base:
                legend: "\u232B"
                size: 6
              Num: '='
              Nav:
                legend: "\u25B6||"
                size: 4
            mirror:
              layers:
                Base:
                  legend: "\u2423"
                  size: 9
                Num: $unset
                Nav: $unset
                on_hold: Nav
              qmk:
                col: C5
            qmk:
              col: C9
        inner:
          key:
            shift:
            - kx+4
            - 1
            rotate: -(split_angle + 12)
            layers:
              Base:
                legend: "\u2326"
                size: 6
              on_hold: Sym1
              Nav:
                legend: Mute
                size: 2
            mirror:
              layers:
                Base:
                  legend: Esc
                  size: 4
                on_hold: Sym1
                Nav: $unset
              qmk:
                col: C4
            qmk:
              col: C10
    nav_cluster:
      anchor:
        shift:
        - nav_cluster_x_offset
        - nav_cluster_y_offset
      key:
        padding: 1ky
        spread: 1kx
        tags:
          1u: true
        layers:
          transparent: true
      columns:
        left:
          rows:
            top:
              skip: true
            bottom:
              layers:
                Base:
                  legend: "\u25C0"
                  size: 6
                Sym1:
                  legend: "\u21F1"
                  size: 5
                Media: Prev
          key:
            qmk:
              col: C6
        center:
          rows:
            bottom:
              layers:
                Base:
                  legend: "\u25BC"
                  size: 8
                Sym1:
                  legend: "\u21DF"
                  size: 6
                Media: V-
            top:
              layers:
                Base:
                  legend: "\u25B2"
                  size: 8
                Sym1:
                  legend: "\u21DE"
                  size: 6
                Media: V+
          key:
            qmk:
              col: C7
        right:
          rows:
            top:
              skip: true
            bottom:
              layers:
                Base:
                  legend: "\u25B6"
                  size: 6
                Sym1:
                  legend: "\u21F2"
                  size: 5
                Media: Next
          key:
            qmk:
              col: C8
      rows:
        bottom:
          qmk:
            row: R3
        top:
          qmk:
            row: R2
outlines:
  keys:
    1u:
      what: rectangle
      where:
      - meta.tags.1u ~ true
      size:
      - kx
      - ky
      operation: stack
  keycaps:
    1u:
      what: rectangle
      where:
      - meta.tags.1u ~ true
      size:
      - 15.76
      - 15.76
      corner: 1.5
      operation: stack
  A1_design_space:
    H0:
      what: rectangle
      size:
      - 283.16
      - 114.35
      adjust:
        shift:
        - 0
        - -(114.35-105)/2 + 3.2
      operation: stack
    H1-35:
      what: rectangle
      size:
      - 276.76
      - 105
      operation: stack
    Electronics:
      what: rectangle
      size:
      - 44.58
      - 15.6
      adjust:
        shift:
        - 44.58/2 - 141.58
        - 15.6/2 - 51.6
      operation: stack
  HandyWork-5x3-test-layout:
  - ^keycaps
  - ^A1_design_space
kle:
  layers:
    Base:
      no-mod:
        index: 9
      alt-no-mod:
        index: 10
      shift:
        index: 8
      size: 7
      color: '#000000'
    Qwerty:
      no-mod:
        index: 9
      alt-no-mod:
        index: 10
      shift:
        index: 8
      size: 7
      color: '#000000'
    Sym1:
      no-mod:
        index: 2
      shift:
        index: 7
      size: 4
      color: '#009600'
    Num:
      no-mod:
        index: 1
      shift:
        index: 6
      size: 4
      color: '#ff9900'
    Nav:
      index: 0
      size: 4
      color: '#ff00ff'
    Fun:
      index: 0
      size: 2
      color: '#ff0000'
layers:
  Base: null
  Qwerty: null
  Sym1: null
  Num: null
  Nav: null
  Fun: null
fabrication:
  main-pcb:
    folder: PCB
    project-name: HandyWork-5x3-with-mods-with-nav-PCB
    template:
      folder: ../Kicad templates/PCB
      project-name: HandyWork-PCB
      files:
      - fp-lib-table
      - sym-lib-table
      - HandyWork-PCB.kicad_pro
      - HandyWork-PCB.kicad_sch
      - HandyWork-PCB-LEDs.kicad_sch
      - HandyWork-PCB-Switches.kicad_sch
      - HandyWork-PCB.kicad_pcb
    offset:
      x: 297 / 2
      y: (210 / 2) - 10
    objects:
    - keys:
      - where:
        - meta.tags.1u ~ true
        ref: SW_{meta.qmk.row}{meta.qmk.col}
        symbol:
          name: Framework:One_Key_Module
          units:
          - unit: 1
            sheet: HandyWork-5x3-with-mods-with-nav-PCB-Switches.kicad_sch
            path: /{Root}/{Switches}
            grid:
              bind:
                x: '{meta.qmk.col}'
                y: '{meta.qmk.row}'
              order:
                x:
                - C1
                - C2
                - C3
                - C4
                - C5
                - C6
                - C7
                - C8
                - C9
                - C10
                - C11
                - C12
                - C13
                y:
                - R1
                - R2
                - R3
                - R4
                - R5
              start:
                x: 750mil
                y: 1600mil
              pitch:
                x: 800mil
                y: 1150mil
              wire:
                pins:
                  left: 3
                  right: 4
                  up: 1
                  down: 9
                anchors:
                  left: 150mil
                  right: 10900mil
                  up: 1200mil
                  down: 6900mil
            extra_symbols:
            - name: power:GND
              to_pin: 2
              properties:
                Value:
                  effects:
                    hide: true
          - unit: 2
            sheet: HandyWork-5x3-with-mods-with-nav-PCB-LEDs.kicad_sch
            path: /{Root}/{LEDs}
            grid:
              bind:
                x: '{meta.qmk.col}'
                y: '{meta.qmk.row}'
              order:
                x:
                - C1
                - C2
                - C3
                - C4
                - C5
                - C6
                - C7
                - C8
                - C9
                - C10
                - C11
                - C12
                - C13
                y:
                - R1
                - R2
                - R3
                - R4
                - R5
              start:
                x: 750mil
                y: 1600mil
              pitch:
                x: 800mil
                y: 1150mil
              wire:
                pins:
                  left: 7
                  right: 8
                  up:
                    number: 6 if meta.qmk.col in ('C1', 'C2', 'C3', 'C5', 'C10', 'C11',
                      'C12') else 5
                    offset:
                    - 50mil
                    - 0
                  down:
                    number: 6 if meta.qmk.col in ('C1', 'C2', 'C3', 'C5', 'C10', 'C11',
                      'C12') else 5
                    offset:
                    - 50mil
                    - 0
                anchors:
                  down: 6900mil
            extra_symbols:
            - type: no-connect
              to_pin: 5 if meta.qmk.col in ('C1', 'C2', 'C3', 'C5', 'C10', 'C11',
                'C12') else 6
        footprint: Framework:One Key Module
        3d_model:
          offset:
            z: -1.2
  alu-plate:
    folder: AluPlate
    project-name: HandyWork-5x3-with-mods-with-nav-AluPlate
    template:
      folder: ../Kicad templates/AluPlate
      project-name: HandyWork-AluPlate
      files:
      - fp-lib-table
      - HandyWork-AluPlate.kicad_pro
      - HandyWork-AluPlate.kicad_sch
      - HandyWork-AluPlate.kicad_pcb
    offset:
      x: 297 / 2
      y: (210 / 2) - 10
    objects:
    - keys:
      - where:
        - meta.tags.1u ~ true
        footprint: Framework:One Key Module for Top Plate
        ref: SW_{meta.qmk.row}{meta.qmk.col}
qmk:
  keyboard:
    keyboard_name: handywork/5x3_mods_nav
    maintainer: Axel Voitier
    manufacturer: Axel Voitier
    url: https://github.com/AxelVoitier/keebs/tree/main/Framework/HandyWork-5x3-with-mods-with-nav
    usb:
      vid: '0xA8E1'
      pid: '0x0003'
      device_version: 1.0.0
    processor: RP2040
    bootloader: rp2040
    build:
      lto: true
    features:
      bootmagic: true
      extrakey: true
      nkro: true
      unicode: true
      led_matrix: true
    bootmagic:
      matrix:
      - 4
      - 5
    led_matrix:
      driver: is31fl3733
      sleep: true
      default:
        'on': true
        animation: band_spiral
      animations:
        solid: true
        alphas_mods: true
        breathing: true
        band: true
        band_pinwheel: true
        band_spiral: true
        cycle_left_right: true
        cycle_up_down: true
        cycle_out_in: true
        dual_beacon: true
        solid_reactive_simple: true
        solid_reactive_wide: true
        solid_reactive_multiwide: true
        solid_reactive_cross: true
        solid_reactive_multicross: true
        solid_reactive_nexus: true
        solid_reactive_multinexus: true
        solid_splash: true
        solid_multisplash: true
        wave_left_right: true
        wave_up_down: true
    diode_direction: ROW2COL
    matrix_pins:
      cols:
      - GP11
      - GP12
      - GP13
      - GP14
      - GP15
      - GP16
      - GP17
      - GP18
      - GP19
      - GP20
      - GP21
      - GP22
      - GP23
      rows:
      - GP6
      - GP7
      - GP8
      - GP9
      - GP10
  _layout:
    name: LAYOUT_3x5_1x3_1x3
    labels: '{row}{col}'
    shift:
    - 4.75
    - 4.75
    sides:
      left:
        is_mirror: true
        is_main: true
      right:
        is_main: true
    structure:
    - - R2C1
      - R1C2
      - R1C3
      - R1C4
      - R1C5
      - '  '
      - '  '
      - '  '
      - R1C9
      - R1C10
      - R1C11
      - R1C12
      - R2C13
    - - R3C1
      - R2C2
      - R2C3
      - R2C4
      - R2C5
      - '  '
      - R2C7
      - '  '
      - R2C9
      - R2C10
      - R2C11
      - R2C12
      - R3C13
    - - R4C1
      - R3C2
      - R3C3
      - R3C4
      - R3C5
      - R3C6
      - R3C7
      - R3C8
      - R3C9
      - R3C10
      - R3C11
      - R3C12
      - R4C13
    - - R5C1
      - R4C2
      - R4C3
      - '  '
      - '  '
      - '  '
      - '  '
      - '  '
      - '  '
      - '   '
      - R4C11
      - R4C12
      - R5C13
    - - '  '
      - '  '
      - '  '
      - R5C4
      - R5C5
      - R5C6
      - '  '
      - R5C8
      - R5C9
      - R5C10
      - '   '
      - '   '
      - '   '
  aliases:
    pin_aliases:
      C1: GP11
      C2: GP12
      C3: GP13
      C4: GP14
      C5: GP15
      C6: GP16
      C7: GP17
      C8: GP18
      C9: GP19
      C10: GP20
      C11: GP21
      C12: GP22
      C13: GP23
      R1: GP6
      R2: GP7
      R3: GP8
      R4: GP9
      R5: GP10
    led_aliases:
      C1: CS11
      C2: CS9
      C3: CS12
      C4: CS13
      C5: CS2
      C6: CS3
      C7: CS1
      C8: CS4
      C9: CS5
      C10: CS7
      C11: CS6
      C12: CS8
      C13: CS10
      R1: SW5
      R2: SW3
      R3: SW4
      R4: SW2
      R5: SW1
