AxelVoitier/keebs/Handy/Handy.yaml

units:
  kx: U
  ky: U
  inner_off: -2.5
  index_off: 0
  middle_off: 6.5
  ring_off: -(4/25)U
  pinky_off: -(5/7)U
  outer_off: -25
  inner_splay: 0
  index_splay: 0
  middle_splay: 5
  ring_splay: 10
  pinky_splay: 15
  outer_splay: 20
  arc_index_home_x_offset: 6
  arc_index_home_y_offset: ky + 120 + 1
  thumb_central_radius: 90.6
  thumb_middle_angle: 19
  thumb_sides_top_angle_offset: 12 - 0.047
  thumb_sides_bottom_angle_offset: 15 - 0.23
  thumb_sides_top_radius: thumb_central_radius + 0.5ky + 0.4025
  thumb_sides_bottom_radius: thumb_central_radius - 0.5ky + 0.065
  case_padding: 4
  pcb_padding: case_padding / 2
  case_fillet: 5
  case_top_arc_x_offset: -0.3kx
  case_top_arc_y_offset: -5.45ky
  case_top_arc_radius: 4.5ky + 1.5ky + case_padding
  case_thumb_bottom_arc_radius: thumb_sides_bottom_radius - 0.5ky - case_padding
  case_thumb_top_arc_radius: thumb_central_radius + 1ky + case_padding
  tenting_hole_size: 5.3
  tenting_hole_clearance: case_fillet - (tenting_hole_size / 2)
  arc_center_to_outer_bottom: 108.863
  preprocessed_r__case_corner_bottom_left: 0
  preprocessed_r__case_corner_bottom_right: 0
  preprocessed_r__case_tenting_hole_bottom_right: 0
  preprocessed_r__case_tenting_hole_top_left: 0
  preprocessed_r__case_tenting_hole_top_middle: 0
  preprocessed_r__case_tenting_hole_top_right: 0
  preprocessed_r__case_thumb_top_corner: 0
  preprocessed_x__case_corner_bottom_left: -48.91760310696899
  preprocessed_x__case_corner_bottom_right: 96.64202444242285
  preprocessed_x__case_tenting_hole_bottom_right: 93.14098674753308
  preprocessed_x__case_tenting_hole_top_left: -30.7131866
  preprocessed_x__case_tenting_hole_top_middle: 14.800699900712917
  preprocessed_x__case_tenting_hole_top_right: 115.45426785780013
  preprocessed_x__case_thumb_top_corner: -48.91760310696899
  preprocessed_y__case_corner_bottom_left: -32.214913278076224
  preprocessed_y__case_corner_bottom_right: -50.88500000000003
  preprocessed_y__case_tenting_hole_bottom_right: -45.88500000000004
  preprocessed_y__case_tenting_hole_top_left: 41.23988391507002
  preprocessed_y__case_tenting_hole_top_middle: 56.61414083232918
  preprocessed_y__case_tenting_hole_top_right: 15.420236201064029
  preprocessed_y__case_thumb_top_corner: -32.214913278076224
points:
  rotate: 0
  mirror: -47.625
  key:
    width: kx
    height: ky
  zones:
    matrix:
      key:
        padding: 1ky
        spread: 1kx
        tags:
          1u: true
      columns:
        inner:
          key:
            splay: -inner_splay
            qmk:
              col: D4
          rows:
            top:
              layers:
                Base: J
                Sym1: '*'
                Num: '*'
                Nav:
                  legend: V+
                  size: 3
                Media: Ltog
              mirror:
                layers:
                  Base: B
                  Fun: Pause
                  Sym1: $unset
                  Num: $unset
                  Media: $unset
                  Nav: $unset
            home:
              layers:
                Base: M
                Sym1: '='
                Num:
                  no-mod: .
                  shift: ','
                Math:
                  no-mod: "\u208C"
                  shift: "\u207C"
                Nav: "\u21F1"
              mirror:
                layers:
                  Base: G
                  Sym1: '@'
                  Sym2: "\u0327"
                  Fun:
                    legend: PrtScn
                    size: 1
                  Num: $unset
                  Math: $unset
                  Nav: $unset
            bottom:
              layers:
                Base: K
                Sym1:
                  no-mod: /
                  shift: '?'
                Num: /
                Math:
                  legend: "\u2044"
                  size: 4
                Nav:
                  legend: V-
                  size: 3
              mirror:
                layers:
                  Base: V
                  Sym1: \
                  Fun:
                    legend: ScrLock
                    size: 1
                  Num: $unset
                  Math: $unset
                  Nav: $unset
        index:
          key:
            stagger: -inner_off + index_off
            splay: +inner_splay - index_splay
            qmk:
              col: C6
          rows:
            top:
              layers:
                Base: L
                Num: 7
                Math:
                  no-mod: "\u2087"
                  shift: "\u2077"
                Nav:
                  legend: Prev
                  size: 2
                Media: Lmod
              mirror:
                layers:
                  Base: P
                  Sym1: '|'
                  Fun: F4
                  Num: $unset
                  Math: $unset
                  Nav: $unset
                  Media: $unset
            home:
              layers:
                Base: N
                Sym1: )
                Num: 4
                Math:
                  no-mod: "\u2084"
                  shift: "\u2074"
                Nav:
                  legend: "\u25C0"
                  size: 3
              mirror:
                layers:
                  Base: T
                  Sym1: (
                  Sym2: "\u0301"
                  Fun: F8
                  Num: $unset
                  Math: $unset
                  Nav: $unset
            bottom:
              layers:
                Base: H
                Num: 1
                Math:
                  no-mod: "\u2081"
                  shift: "\xB9"
                Nav:
                  legend: "\u2423\u25C0"
                  size: 2
                  keycode: LCTL(KC_LEFT)
              mirror:
                layers:
                  Base: D
                  Sym1: '#'
                  Fun: F12
                  Num: $unset
                  Math: $unset
                  Nav: $unset
        middle:
          key:
            stagger: -index_off + middle_off
            splay: +index_splay - middle_splay
            spread: 1kx + 0.8
            qmk:
              col: D7
          rows:
            top:
              layers:
                Base: U
                Sym1: '!'
                Num: 8
                Math:
                  no-mod: "\u2088"
                  shift: "\u2078"
                Media: Lhui
              mirror:
                layers:
                  Base: F
                  Sym1: ^
                  Fun: F3
                  Num: $unset
                  Math: $unset
                  Media: $unset
            home:
              layers:
                Base: E
                Sym1: ']'
                Num: 5
                Math:
                  no-mod: "\u2085"
                  shift: "\u2075"
                Nav: "\u25B2"
              mirror:
                layers:
                  Base: S
                  Sym1: '['
                  Sym2: "\u0300"
                  Fun: F7
                  Num: $unset
                  Math: $unset
                  Nav: $unset
            bottom:
              layers:
                Base:
                  no-mod: ','
                  shift:
                    legend: ;
                    size: 5
                Sym1: ;
                Num: 2
                Math:
                  no-mod: "\u2082"
                  shift: "\xB2"
                Nav: "\u25BC"
              mirror:
                layers:
                  Base: C
                  Sym1: '&'
                  Fun: F11
                  Num: $unset
                  Math: $unset
                  Nav: $unset
        ring:
          key:
            stagger: -middle_off + ring_off
            splay: +middle_splay - ring_splay
            spread: 1kx + 0.04
            qmk:
              col: E6
          rows:
            top:
              layers:
                Base: Y
                Sym1: '%'
                Num: 9
                Math:
                  no-mod: "\u2089"
                  shift: "\u2079"
                Nav:
                  legend: Next
                  size: 2
                Media: Lsai
              mirror:
                layers:
                  Base: W
                  Sym1: '~'
                  Fun: F2
                  Num: $unset
                  Math: $unset
                  Nav: $unset
                  Media: $unset
            home:
              layers:
                Base: I
                Sym1: '}'
                Num: 6
                Math:
                  no-mod: "\u2086"
                  shift: "\u2076"
                Nav:
                  legend: "\u25B6"
                  size: 3
              mirror:
                layers:
                  Base: R
                  Sym1: '{'
                  Sym2: "\u0302"
                  Fun: F6
                  Num: $unset
                  Math: $unset
                  Nav: $unset
            bottom:
              layers:
                Base:
                  no-mod: .
                  shift:
                    legend: ':'
                    size: 5
                Sym1: ':'
                Num: 3
                Math:
                  no-mod: "\u2083"
                  shift: "\xB3"
                Nav:
                  legend: "\u25B6\u2423"
                  size: 2
                  keycode: LCTL(KC_RIGHT)
              mirror:
                layers:
                  Base: X
                  Sym1: $
                  Fun: F10
                  Num: $unset
                  Math: $unset
                  Nav: $unset
        pinky:
          key:
            stagger: -ring_off + pinky_off + 1
            splay: +ring_splay - pinky_splay
            spread: 1kx + 0.035
            qmk:
              col: B4
          rows:
            top:
              layers:
                Base:
                  no-mod:
                    legend: '-'
                    index: 10
                  shift: _
                Sym1: "\xB1"
                Num: '-'
                Math:
                  no-mod: "\u208B"
                  shift: "\u207B"
                Nav: "\u21DE"
                Media: Lvai
              mirror:
                layers:
                  Base: Q
                  Sym1: '`'
                  Fun: F1
                  Num: $unset
                  Math: $unset
                  Nav: $unset
                  Media: $unset
            home:
              layers:
                Base: O
                Sym1: '>'
                Num: 0
                Math:
                  no-mod: "\u2080"
                  shift: "\u2070"
                Nav: "\u21F2"
              mirror:
                layers:
                  Base: A
                  Sym1: <
                  Sym2: "\u0308"
                  Fun: F5
                  Num: $unset
                  Math: $unset
                  Nav: $unset
            bottom:
              layers:
                Base:
                  no-mod: ''''
                  shift: '"'
                Sym1: "\xB1"
                Num: +
                Math:
                  no-mod: "\u208A"
                  shift: "\u207A"
                Nav: "\u21DF"
              mirror:
                layers:
                  Base: Z
                  Sym1: "\xB0"
                  Fun: F9
                  Num: $unset
                  Math: $unset
                  Nav: $unset
        outer:
          key:
            stagger: -pinky_off + outer_off
            splay: +pinky_splay - outer_splay
            spread: 1kx - 0.12
          rows:
            top:
              layers:
                Base:
                  no-mod: ''''
                  shift: '"'
              mirror:
                layers:
                  Base:
                    legend: "\u2387"
                    size: 6
                    no-mod: $unset
                    shift: $unset
            home:
              layers: null
              mirror:
                layers:
                  Base:
                    legend: "\u232B"
                    size: 6
            bottom:
              layers:
                Base:
                  legend: "\u2756"
                  size: 8
              mirror:
                layers:
                  Base:
                    legend: "\u2388"
                    size: 9
      rows:
        bottom:
          qmk:
            row: B1
        home:
          qmk:
            row: F7
        top:
          qmk:
            row: F6
    arc_center:
      anchor:
        ref: matrix_index_home
        shift:
        - arc_index_home_x_offset
        - -arc_index_home_y_offset
    thumb_cluster:
      anchor:
        ref: arc_center
      key:
        padding: 1ky
        spread: 0
        tags:
          1u: true
        layers:
          transparent: true
        qmk:
          col: D4
          row: B2
      columns:
        outer_top:
          key:
            orient: thumb_middle_angle + thumb_sides_top_angle_offset
            shift:
            - 0
            - thumb_sides_top_radius
            layers:
              Base:
                legend: "\u232B"
                size: 6
              on_hold: Fun
            mirror:
              layers:
                Base:
                  legend: Esc
                  size: 4
                on_hold: Nav
        outer_bottom:
          key:
            orient: thumb_middle_angle + thumb_sides_bottom_angle_offset
            shift:
            - -0.5
            - thumb_sides_bottom_radius
            layers:
              Base:
                legend: "\u2326"
                size: 6
              Sym1:
                legend: Ins
                size: 2
              on_hold: Sym2
            mirror:
              layers:
                Base: "\u21E5"
                on_hold: Num
                Sym1: $unset
            qmk:
              row: B6
        middle:
          key:
            orient: thumb_middle_angle
            shift:
            - 0
            - thumb_central_radius
            height: 2ky
            tags:
              1u: $unset
              2u: vertical
            layers:
              Base:
                legend: "\u23CE"
                size: 9
              Num: '='
              Nav:
                legend: "\u25B6||"
                size: 4
              on_hold: Sym1
            mirror:
              layers:
                Base:
                  legend: "\u2423"
                  size: 9
                on_hold: Sym1
                Num: $unset
                Nav: $unset
        inner_top:
          key:
            orient: thumb_middle_angle - thumb_sides_top_angle_offset
            shift:
            - 0
            - thumb_sides_top_radius
            layers:
              Base:
                legend: "\u21E7"
                size: 9
                keycode: KC_RIGHT_SHIFT
              Nav:
                legend: "\u25A0"
                size: 4
            mirror:
              layers:
                Base:
                  keycode: $unset
                Nav: $unset
        inner_bottom:
          key:
            orient: thumb_middle_angle - thumb_sides_bottom_angle_offset
            shift:
            - 0.5
            - thumb_sides_bottom_radius
            layers:
              Base:
                legend: "\u2388"
                size: 9
              Nav:
                legend: Mute
                size: 2
            mirror:
              layers:
                Nav: $unset
    nav_cluster:
      $skip: true
      anchor:
        ref: matrix_ring_bottom
        shift:
        - -kx
        - -2ky-1
      key:
        padding: 1ky
        spread: 1kx
        tags:
          1u: true
        layers:
          transparent: true
      columns:
        left:
          rows:
            bottom:
              skip: true
          key:
            layers:
              Base:
                legend: "\u25C0"
                size: 6
              Sym1:
                legend: "\u21F1"
                size: 5
              Media: Prev
            mirror:
              layers:
                Base:
                  legend: "\u21F2"
                  size: 6
                Sym1:
                  legend: "\u25B6"
                  size: 3
                Media: $unset
        up_down:
          key:
            stagger: 1
          rows:
            top:
              layers:
                Base:
                  legend: "\u25B2"
                  size: 9
                Sym1:
                  legend: "\u21DE"
                  size: 6
                Media: V+
              mirror:
                layers:
                  Base:
                    legend: "\u21DE"
                    size: 9
                  Sym1: "\u25B2"
                  Media: $unset
            bottom:
              layers:
                Base:
                  legend: "\u25BC"
                  size: 9
                Sym1:
                  legend: "\u21DF"
                  size: 6
                Media: V-
              mirror:
                layers:
                  Base:
                    legend: "\u21DF"
                    size: 9
                  Sym1: "\u25BC"
                  Media: $unset
        right:
          key:
            stagger: -ring_off + pinky_off
            layers:
              Base:
                legend: "\u25B6"
                size: 6
              Sym1:
                legend: "\u21F2"
                size: 5
              Media: Next
            mirror:
              layers:
                Base:
                  legend: "\u21F1"
                  size: 6
                Sym1:
                  legend: "\u25C0"
                  size: 3
                Media: $unset
          rows:
            bottom:
              skip: true
      rows:
        bottom: null
        top: null
    pro_micro:
      key:
        tags:
          pro_micro: true
      anchor:
        ref: matrix_inner_top
        shift:
        - -1kx + 0.4
        - 0.5ky - 39/2 + 0.498
    _case_corner_bottom_right:
      key:
        preprocess:
          method: intersect
          lines:
          - - ref: matrix_outer_top
              shift:
              - 0.5kx + case_padding
              - 0
            - ref: matrix_outer_bottom
              shift:
              - 0.5kx + case_padding
              - 0
          - - ref: arc_center
              shift:
              - 0
              - case_thumb_bottom_arc_radius
            - ref: arc_center
              shift:
              - 10
              - case_thumb_bottom_arc_radius
      anchor:
        shift:
        - preprocessed_x__case_corner_bottom_right
        - preprocessed_y__case_corner_bottom_right
    _case_thumb_bottom_arc_end:
      anchor:
        ref: arc_center
        orient: thumb_middle_angle + thumb_sides_bottom_angle_offset
        shift:
        - 0
        - case_thumb_bottom_arc_radius
    _case_thumb_bottom_corner:
      anchor:
        ref: _case_thumb_bottom_arc_end
        orient: 90
        shift:
        - 0
        - 0.5kx + case_padding
    _case_thumb_top_corner:
      key:
        preprocess:
          method: intersect
          circle:
            center:
              ref: arc_center
            radius: case_thumb_top_arc_radius
          line:
            start:
              ref: _case_thumb_bottom_corner
            end:
            - ref: _case_thumb_bottom_corner
              orient: -90
              shift:
              - 0
              - 10
          determinant-sign: minus
      anchor:
        shift:
        - preprocessed_x__case_corner_bottom_left
        - preprocessed_y__case_corner_bottom_left
    _case_tenting_hole_bottom_left:
      key:
        tags:
          tenting_hole: true
      anchor:
        ref: _case_thumb_bottom_corner
        shift:
        - case_fillet
        - case_fillet
    _case_tenting_hole_top_left:
      key:
        tags:
          tenting_hole: true
        preprocess:
          method: circle-on-line-tangent-to-other-circle
          circle:
            center:
              ref: matrix_middle_top
              shift:
              - case_top_arc_x_offset
              - case_top_arc_y_offset
            radius: case_top_arc_radius
          line:
            start:
              ref: _case_tenting_hole_bottom_left
            end:
            - affect: r
            - ref: _case_tenting_hole_bottom_left
              affect:
              - x
              - y
            - shift:
              - 0
              - 10
          radius: case_fillet
          internal: true
          determinant-sign: plus
      anchor:
        shift:
        - preprocessed_x__case_tenting_hole_top_left
        - preprocessed_y__case_tenting_hole_top_left
    _case_tenting_hole_bottom_right:
      key:
        tags:
          tenting_hole: true
        preprocess:
          method: intersect
          lines:
          - - ref: matrix_outer_top
              shift:
              - 0.5kx + case_padding - case_fillet
              - 0
            - ref: matrix_outer_bottom
              shift:
              - 0.5kx + case_padding - case_fillet
              - 0
          - - ref: arc_center
              shift:
              - 0
              - case_thumb_bottom_arc_radius + case_fillet
            - ref: arc_center
              shift:
              - 10
              - case_thumb_bottom_arc_radius + case_fillet
      anchor:
        shift:
        - preprocessed_x__case_tenting_hole_bottom_right
        - preprocessed_y__case_tenting_hole_bottom_right
    _case_tenting_hole_top_right:
      key:
        tags:
          tenting_hole: true
        preprocess:
          method: circle-on-line-tangent-to-other-circle
          circle:
            center:
              ref: matrix_middle_top
              shift:
              - case_top_arc_x_offset
              - case_top_arc_y_offset
            radius: case_top_arc_radius
          line:
            start:
              ref: matrix_outer_bottom
              shift:
              - 0.5kx + case_padding - case_fillet
              - 0
            end:
              ref: matrix_outer_top
              shift:
              - 0.5kx + case_padding - case_fillet
              - 0
          radius: case_fillet
          internal: true
          determinant-sign: plus
      anchor:
        shift:
        - preprocessed_x__case_tenting_hole_top_right
        - preprocessed_y__case_tenting_hole_top_right
    _case_tenting_hole_top_middle:
      key:
        tags:
          tenting_hole: true
        preprocess:
          method: circle-on-line-tangent-to-other-circle
          circle:
            center:
              ref: matrix_middle_top
              shift:
              - case_top_arc_x_offset
              - case_top_arc_y_offset
            radius: case_top_arc_radius
          line:
            start:
              ref: _case_tenting_hole_bottom_left
            end:
            - ref: _case_tenting_hole_bottom_left
            - ref: matrix_outer_bottom
              affect: r
            - shift:
              - 0
              - 10
          radius: case_fillet
          internal: true
          determinant-sign: plus
      anchor:
        shift:
        - preprocessed_x__case_tenting_hole_top_middle
        - preprocessed_y__case_tenting_hole_top_middle
outlines:
  keys:
    1u:
      what: rectangle
      where:
      - - meta.tags.1u ~ true
        - meta.mirrored ~ false
      size:
      - kx
      - ky
      operation: stack
    2u_vertical:
      what: rectangle
      where:
      - - meta.tags.2u ~ vertical
        - meta.mirrored ~ false
      size:
      - kx
      - 2ky
      operation: stack
    top_plate_clearence:
      what: rectangle
      where:
      - - - meta.tags.1u ~ true
          - meta.tags.2u ~ vertical
        - meta.mirrored ~ false
      size:
      - 15.6
      - 15.6
      operation: stack
  components:
    pro_micro:
      what: rectangle
      where:
      - - meta.tags.pro_micro ~ true
        - meta.mirrored ~ false
      size:
      - 18.3
      - 33
      operation: stack
    oled_screen:
      what: rectangle
      where:
      - - meta.tags.pro_micro ~ true
        - meta.mirrored ~ false
      size:
      - 13
      - 39
      adjust:
        shift:
        - 0
        - -0.498
      operation: stack
    tenting_hole_drill:
      what: circle
      where:
      - - meta.tags.tenting_hole ~ true
        - meta.mirrored ~ false
      radius: tenting_hole_size / 2
      operation: stack
    tenting_hole_clearance:
      what: circle
      where:
      - - meta.tags.tenting_hole ~ true
        - meta.mirrored ~ false
      radius: case_fillet
      operation: stack
  keyholes:
  - what: rectangle
    where:
    - - meta.tags.1u ~ true
      - meta.mirrored ~ false
    size:
    - 14
    - 14
    operation: stack
  - what: rectangle
    where:
    - - meta.tags.2u ~ vertical
      - meta.mirrored ~ false
    size:
    - 14
    - 33.05
    operation: stack
  debug:
    unit_circle:
      what: circle
      where:
      - - meta.tags.unit_circle ~ true
        - meta.mirrored ~ false
      radius: kx
      operation: stack
    constr_point:
      what: rectangle
      where:
      - - meta.tags.constr_point ~ true
        - meta.mirrored ~ false
      size:
      - 4
      - 4
      operation: stack
    constr_point_orient:
      what: circle
      where:
      - - meta.tags.constr_point ~ true
        - meta.mirrored ~ false
      radius: 1
      adjust:
        shift:
        - 0
        - 2
      operation: stack
    tenting_hole_orient:
      what: circle
      where:
      - - meta.tags.tenting_hole ~ true
        - meta.mirrored ~ false
      radius: 1
      adjust:
        shift:
        - 0
        - tenting_hole_size / 2
      operation: stack
  all_components:
  - ^keys
  - ^components
  board:
  - what: polygon
    operation: stack
    expand: pcb_padding
    fillet: 5
    points:
    - ref: matrix_inner_top
      shift:
      - -0.5kx
      - 0.5ky
    - ref: matrix_middle_top
      shift:
      - -0.5kx
      - 0.5ky
    - ref: matrix_middle_top
      shift:
      - +0.5kx
      - 0.5ky
    - ref: matrix_pinky_top
      shift:
      - 0.5kx
      - 0.5ky
    - ref: matrix_outer_top
      shift:
      - 0.5kx
      - 0.5ky
    - ref: matrix_outer_bottom
      shift:
      - 0.5kx
      - -0.75ky
    - ref: thumb_cluster_middle
      shift:
      - 0.5kx
      - -1ky
    - ref: thumb_cluster_middle
      shift:
      - -0.5kx
      - -1ky
    - ref: thumb_cluster_outer_bottom
      shift:
      - -0.5kx
      - -0.5ky
    - ref: thumb_cluster_outer_top
      shift:
      - -0.75kx
      - 0.5ky
    - ref: matrix_inner_bottom
      shift:
      - -0.5kx
      - -0.5ky
  board_keys:
  - ^board
  - ^keys
  case_thumb_top_arc:
  - what: circle
    where: arc_center
    radius: case_thumb_top_arc_radius
  - what: polygon
    points:
    - ref: _case_thumb_top_corner
    - ref: thumb_cluster_middle
    - ref: matrix_inner_bottom
    - ref: thumb_cluster_middle
      shift:
      - 0
      - 5ky
    operation: intersect
  case:
  - what: circle
    where: matrix_middle_top
    adjust:
      shift:
      - case_top_arc_x_offset
      - case_top_arc_y_offset
    radius: case_top_arc_radius
  - what: circle
    where: arc_center
    radius: case_thumb_bottom_arc_radius
    operation: subtract
  - what: polygon
    operation: intersect
    points:
    - ref: matrix_inner_top
      shift:
      - -50
      - 40
    - ref: matrix_outer_top
      shift:
      - 0.5kx + case_padding
      - 50
    - ref: _case_corner_bottom_right
    - ref: arc_center
      shift:
      - 0
      - case_thumb_bottom_arc_radius
    - ref: _case_thumb_bottom_arc_end
    - ref: _case_tenting_hole_bottom_left
      shift:
      - -case_fillet
      - case_fillet
    - ref: _case_tenting_hole_bottom_left
      shift:
      - case_fillet
      - case_fillet
    - ref: _case_tenting_hole_bottom_left
      shift:
      - case_fillet+0.00000014
      - -case_fillet
    - ref: _case_thumb_top_corner
    - ref: _case_tenting_hole_top_left
      shift:
      - tenting_hole_size / 2
      - -3.5ky
    - ref: _case_tenting_hole_top_left
      shift:
      - tenting_hole_size / 2
      - -case_fillet
    - ref: _case_tenting_hole_top_left
      shift:
      - -5.0e-08
      - -case_fillet
    - ref: _case_tenting_hole_top_left
      shift:
      - 0
      - 0
  - what: circle
    where: _case_tenting_hole_top_left
    radius: case_fillet
    operation: add
  - +case_thumb_top_arc
  _case_main_fillet:
  - name: case
    fillet: case_fillet
  case_filleted:
  - name: _case_main_fillet
    fillet: tenting_hole_size / 2
  case_components:
  - ^case_filleted
  - ^all_components
  keys_plate:
  - ^case_filleted
  - ^keyholes
  all:
  - ^case_filleted
  - ^board
  - ^all_components
  - ^keyholes
pcbs:
  Handy-PCB-outline:
    outlines:
    - outline: board
      layer: Edge.Cuts
  Handy-case:
    outlines:
    - outline: case_filleted
      layer: Edge.Cuts
  Handy-keys-plate:
    outlines:
    - outline: keys_plate
      layer: Edge.Cuts
  Handy-bottom-plate:
    outlines:
    - outline: case
      layer: Edge.Cuts
fabrication:
  main-pcb:
    folder: PCB
    project-name: Handy-PCB
    offset:
    - 120
    - 90
    objects:
    - outline: Handy-case
      ref: ECoutline
    - keys:
      - where:
        - meta.tags.1u ~ true
        - meta.mirrored ~ false
        footprint: Keebs:CherryMX_1u_with_smd_diode
        ref: SW_{meta.name}
      - where:
        - meta.tags.2u ~ vertical
        - meta.mirrored ~ false
        footprint: Keebs:CherryMX_2u_with_smd_diode
        angle: -90
        ref: SW_{meta.name}
      - where:
        - meta.tags.tenting_hole ~ true
        - meta.mirrored ~ false
        footprint: Keebs:M5_with_washer
        ref: HW_{meta.name}
kle:
  layers:
    Base:
      no-mod:
        index: 9
      shift:
        index: 8
      size: 7
      color: '#000000'
    Sym1:
      no-mod:
        index: 2
      shift:
        index: 7
      size: 4
      color: '#009600'
    Sym2:
      index: 3
      size: 4
      color: '#940000'
    Num:
      no-mod:
        index: 1
      shift:
        index: 6
      size: 4
      color: '#ff9900'
    Math:
      index: 3
      size: 5
      color: '#0065c2'
    Nav:
      index: 0
      size: 4
      color: '#ff00ff'
    Fun:
      index: 0
      size: 2
      color: '#ff0000'
    Media:
      index: 0
      size: 2
      color: '#ff00ff'
      kle_ignore: true
layers:
  Base: null
  Sym1: null
  Sym2: null
  Num: null
  Math: null
  Nav: null
  Fun: null
  Media: null
qmk:
  keyboard:
    keyboard_name: handy
    maintainer: Axel Voitier
    manufacturer: Axel Voitier
    url: https://github.com/AxelVoitier/keebs/tree/main/Handy
    usb:
      vid: '0xA8E1'
      pid: '0x0002'
      device_version: 1.0.0
    development_board: promicro
    pin_compatible: null
    bootloader: null
    processor: null
    build:
      lto: true
    features: null
    debounce: 5
    diode_direction: COL2ROW
    matrix_pins:
      cols:
      - D4
      - C6
      - D7
      - E6
      - B4
      rows:
      - F6
      - F7
      - B1
      - B3
      - B2
      - B6
    split:
      enabled: true
      soft_serial_pin: D2
  keymap:
    features:
      oled: true
    split:
      main: left
  _layout:
    name: LAYOUT_3x5_1x4_1x2_2u_2x1u
    labels: '{side_abbrev}{row_i}{col_i}'
    sides:
      left:
        is_main: true
        is_mirror: true
      right: null
