AxelVoitier/keebs/Handy/Handy-01-layout.yaml

units:
  kx: U
  ky: U

  # Columns stagger, referenced to index column
  inner_off: -2.5  # Kyria
  index_off: 0  # Should remain 0
  middle_off: +6.5  # Kyria
  ring_off: -(4/25)U  # YAEMK
  pinky_off: -(5/7)U  # YAEMK
  #outer_off: -(103/125)U  # YAEMK
  #outer_off: -21.4  # Elephant42
  outer_off: -25

  # Columns absolute splay (degrees)
  inner_splay: 0
  index_splay: 0
  middle_splay: 5
  ring_splay: 10
  pinky_splay: 15
  outer_splay: 20

  # Thumb cluster
  # arc_index_home_x_offset: 11.7604  # Kyria
  arc_index_home_x_offset: 6  # For clearence between thumb and nav clusters
  arc_index_home_y_offset: ky + 120 + 1  # Kyria + thumb/-av clusters clearence
  thumb_central_radius: 90.6
  thumb_middle_angle: 19
  thumb_sides_top_angle_offset: 12 - 0.047
  thumb_sides_bottom_angle_offset: 15 - 0.23
  thumb_sides_top_radius: thumb_central_radius + 0.5ky + 0.4025
  thumb_sides_bottom_radius: thumb_central_radius - 0.5ky + 0.065

points:
  #rotate: 25
  #mirror: 105
  rotate: 0
  mirror: -47.625  # -2.5kx
  key:
    width: kx
    height: ky
  zones:
    matrix:
      key:
        padding: 1ky
        spread: 1kx
        tags:
          1u: true
      columns:
        inner:
          key.splay: -inner_splay
          #rows.mod.skip: true
        index:
          key.stagger: -inner_off + index_off
          key.splay: +inner_splay - index_splay
          #rows.mod.skip: true
        middle:
          key.stagger: -index_off + middle_off
          key.splay: +index_splay - middle_splay
          key.spread: 1kx + 0.8
          #rows.mod.skip: true
        ring:
          key.stagger: -middle_off + ring_off
          key.splay: +middle_splay - ring_splay
          key.spread: 1kx + 0.04
          #rows.mod.skip: true  # Defined by nav cluster instead
        pinky:
          key.stagger: -ring_off + pinky_off + 1
          key.splay: +ring_splay - pinky_splay
          key.spread: 1kx + 0.035
          #rows.mod.skip: true  # Defined by nav cluster instead
        outer:
          # $skip: true
          key.stagger: -pinky_off + outer_off
          key.splay: +pinky_splay - outer_splay
          key.spread: 1kx - 0.12
          # rows.mod.skip: true
      rows:
        #mod:
        bottom:
        home:
        top:

    arc_center:
      anchor:
        ref: matrix_index_home
        shift: [arc_index_home_x_offset, -arc_index_home_y_offset]

    thumb_cluster:
      anchor:
        ref: arc_center
      key:
        padding: 1ky
        spread: 0
        tags:
          1u: true
      columns:
        outer_top.key:
          orient: thumb_middle_angle + thumb_sides_top_angle_offset
          shift: [0, thumb_sides_top_radius]
        outer_bottom.key:
          orient: thumb_middle_angle + thumb_sides_bottom_angle_offset
          shift: [-0.5, thumb_sides_bottom_radius]
        # outer2_top.key:
        #   orient: thumb_middle_angle + 12*2
        #   shift: [0, thumb_central_radius + 0.5ky]
        # outer2_bottom.key:
        #   orient: thumb_middle_angle + 15*2
        #   shift: [0, thumb_central_radius - 0.5ky]
        middle.key:
          orient: thumb_middle_angle
          shift: [0, thumb_central_radius]
          height: 2ky
          tags:
            1u: $unset
            2u: vertical
        inner_top.key:
          orient: thumb_middle_angle - thumb_sides_top_angle_offset
          shift: [0, thumb_sides_top_radius]
        inner_bottom.key:
          orient: thumb_middle_angle - thumb_sides_bottom_angle_offset
          shift: [0.5, thumb_sides_bottom_radius]

    nav_cluster:
      $skip: true
      anchor:
        ref: matrix_ring_bottom
        #orient: middle_splay - ring_splay
        shift: [-kx, -2ky-1]
      key:
        padding: 1ky
        spread: 1kx
        tags:
          1u: true
      columns:
        left:
          rows.bottom.skip: true
        up_down:
          #key.stagger: +middle_off - ring_off
          key.stagger: 1
        right:
          key.stagger: -ring_off + pinky_off
          rows.bottom.skip: true
      rows:
        bottom:
        top:

outlines:
  keys:
    1u:
      what: rectangle
      where:
        - - meta.tags.1u ~ true
          - meta.mirrored ~ false
      size: [kx, ky]
      operation: stack
    2u_vertical:
      what: rectangle
      where:
        - - meta.tags.2u ~ vertical
          - meta.mirrored ~ false
      size: [kx, 2ky]
      operation: stack
    top_plate_clearence:
      what: rectangle
      where:
        - - - meta.tags.1u ~ true
            - meta.tags.2u ~ vertical
          - meta.mirrored ~ false
      size: [15.6, 15.6]
      operation: stack
