AxelVoitier/keebs/Framework/HandyWork-5x3-with-mods-with-nav/ergogen-output/points/units.yaml

U: 19.05
u: 19
cx: 18
cy: 17
$default_stagger: 0
$default_spread: 19
$default_splay: 0
$default_height: 18
$default_width: 18
$default_padding: 19
$default_autobind: 10
kx: 19
ky: 19
inner_off: -2.5
index_off: -2.5
middle_off: 6.5
ring_off: -3.048
pinky_off: -20.955000000000002
outer_off: 0
inner_splay: 0
index_splay: 0
middle_splay: 5
ring_splay: 10
pinky_splay: 20
outer_splay: 0
split_x_offset: 35
split_y_offset: -56
split_angle: 25
nav_cluster_x_offset: -19
nav_cluster_y_offset: -17.1
mil: 0.0254
