AxelVoitier/keebs/qmk_keymap/keyrecords/keycodes.h

// Copyright 2021 Axel Voitier (@Axel Voitier)
// SPDX-License-Identifier: GPL-2.0-or-later

#pragma once
#include "lexa.h"


enum userspace_keycodes {
    KC_CCCV=QK_USER,  // Hold to copy, tap to paste

    USER_SAFE_RANGE
};
