AxelVoitier/keebs/qmk_keymap/keyrecords/tap_dances.c

// Copyright 2021 Axel Voitier (@Axel Voitier)
// SPDX-License-Identifier: GPL-2.0-or-later

#include "lexa.h"


typedef enum {
    TD_NONE,
    TD_UNKNOWN,
    TD_SINGLE_TAP,
    TD_SINGLE_HOLD,
    TD_DOUBLE_TAP,
    TD_DOUBLE_HOLD,
    TD_DOUBLE_SINGLE_TAP, // Send two single taps
    TD_TRIPLE_TAP,
    TD_TRIPLE_HOLD
} td_state_t;

typedef struct {
    bool is_press_action;
    td_state_t state;
} td_tap_t;

// Create an instance of 'td_tap_t' for the 'x' tap dance.
static td_tap_t xtap_state = {
    .is_press_action = true,
    .state = TD_NONE
};

td_state_t cur_dance(qk_tap_dance_state_t *state) {
    if (state->count == 1) {
        if (state->interrupted || !state->pressed) return TD_SINGLE_TAP;
        // Key has not been interrupted, but the key is still held. Means you want to send a 'HOLD'.
        else return TD_SINGLE_HOLD;
    } else if (state->count == 2) {
        // TD_DOUBLE_SINGLE_TAP is to distinguish between typing "pepper", and actually wanting a double tap
        // action when hitting 'pp'. Suggested use case for this return value is when you want to send two
        // keystrokes of the key, and not the 'double tap' action/macro.
        if (state->interrupted) return TD_DOUBLE_SINGLE_TAP;
        else if (state->pressed) return TD_DOUBLE_HOLD;
        else return TD_DOUBLE_TAP;
    }

    // Assumes no one is trying to type the same letter three times (at least not quickly).
    // If your tap dance key is 'KC_W', and you want to type "www." quickly - then you will need to add
    // an exception here to return a 'TD_TRIPLE_SINGLE_TAP', and define that enum just like 'TD_DOUBLE_SINGLE_TAP'
    if (state->count == 3) {
        if (state->interrupted || !state->pressed) return TD_TRIPLE_TAP;
        else return TD_TRIPLE_HOLD;
    } else return TD_UNKNOWN;
}

void dance_ctl_finished(qk_tap_dance_state_t *state, void *user_data) {xtap_state.state = cur_dance(state);
    switch (xtap_state.state) {
        case TD_SINGLE_TAP: set_oneshot_mods(MOD_BIT(KC_LCTL)); break;
        case TD_SINGLE_HOLD: register_code(KC_LCTL); break;
        case TD_DOUBLE_HOLD: layer_on(MEDIA); break;
        default:
            break;
    }
    // if (state->count == 1) {
    //     set_oneshot_mods(MOD_LCTL);
    // } else {
    //     layer_on(MEDIA);
    // }
}

void dance_ctl_reset(qk_tap_dance_state_t *state, void *user_data) {
    switch (xtap_state.state) {
        case TD_SINGLE_HOLD: unregister_code(KC_LCTL); break;
        case TD_DOUBLE_HOLD: layer_off(MEDIA); break;
        default:
            break;
    }
    xtap_state.state = TD_NONE;
    // if (state->count == 1) {
    //     clear_oneshot_mods();
    // } else {
    //     layer_off(MEDIA);
    // }
}

// All tap dance functions would go here. Only showing this one.
qk_tap_dance_action_t tap_dance_actions[] = {
    [TD_CTL_MEDIA] = ACTION_TAP_DANCE_FN_ADVANCED(NULL, dance_ctl_finished, dance_ctl_reset),
    [TD_NUM_PRN] = ACTION_TAP_DANCE_DOUBLE(KC_LPRN, KC_RPRN)
};
