AxelVoitier/keebs/(commit log)

2021-10-11 Adding initial top plate for Kyfle.
    Kyfle is a mix of Kyria layout with an extra row, using some Sofle design files, and using a modified (for RGB) su120 bit boards as actual PCB
    [KyfleTopPlate.kicad_pcb]
2021-10-12 Added tenting holes and reviewed mechanical fixture solutions.
    [KyfleTopPlate.kicad_pcb]
2021-10-12 Importing PCB design from SU120 branch (was already modified to fit RGB on the branch)
    [su120.kicad_pcb, su120.sch]
2021-10-12 Adding 4 RGB bit boards to the PCB
    Replacing some of the spacers.
    Based on SK6812 Mini-E.
    [su120.kicad_pcb, su120.sch]
2021-10-12 Working on solutions to hold the main PCB.
    Also cleaned a bit the layers by separating physical dimensions (CrtYrd), functional wiring (Fab) and other construction lines (User).
    Completed the wiring template.
    [KyfleTopPlate.kicad_pcb]
2021-10-14 Experimentation with different fastening solutions. Not great.
    [KyfleTopPlate.kicad_pcb, su120.kicad_pcb]
2021-10-15 Settled on a solution to fix the PCB
    It will be hold by the bottom plate only.
    [KyfleTopPlate.kicad_pcb]
2021-10-15 Cleaning up the mounting points tests, increasing the mounting points of remaining bits (pro micro, potentiometer, 2u key). And strenghtening the power tracks to accomodate possible "high" current wh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
    [su120.kicad_pcb]
2021-10-15 Fixuturing solution for the pro micro board
    [KyfleTopPlate.kicad_pcb, su120.kicad_pcb]
2021-10-18 Reorganising the pro micro bit board
    - Changed how the jumper selectors work (the ones needed for reversible usage of the board)
    - As it maded more space, I increased even more the power delivery for LED use case
    - Changed footprint of OLED connector. Instead of just being through holes, they are now solderable through holes (though not connected to anything). It should help for mechanical stability of the screen.
    - Small changes to hole sizes
    [su120.kicad_pcb, su120.sch]
2021-10-18 Adding bottom plate
    [KyfleBottomPlate.kicad_pcb, KyfleTopPlate.kicad_pcb]
2021-10-18 Adding 3D model for cherry mx (from Acheron libs), adding generating pretty pictures with it
    [KyfleBottomPlate.kicad_pcb, KyfleTopPlate.kicad_pcb]
2021-10-20 Massive reduction in drill impacts and drill size diversity
    It was suggested by a redittor that jlcpcb might charge engineering fees for too many holes.
    So, all biscuits have been removed, all unused M1.4 holes have been removed, the signal pads (column, row, din, dout) have been converted from holes to just SMD pads as it should be fine if using enameled wire.
    And the various holes have been harmonised to minimise number of drill sizes.
    Also, number of vias have been greatly reduced, at the price of a bit less copper pour here and there (that's ok, if we cared about signal integrity we would you at least use a 4 layer stack up...).
    The slots have been redone as footprints in order to contr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
    [su120.kicad_pcb, su120.sch]
2021-10-21 Redid some footprints
    - For the pro-micro socketed with rivets, it is now reversible
    - The connector for OLED screen has also been converted to a rivetted version
    - The footprint of the TRRS connector has been corrected according to part datasheet
    - The silkscreen indicating the cut line in between bit boards is now done in some slots footprints
    [su120.kicad_pcb, su120.sch]
2021-10-21 Adding reference positions to bottom plate silk screen
    [KyfleBottomPlate.kicad_pcb, KyfleTopPlate.kicad_pcb]
2021-10-25 Massive redesign
    - Realised the design was not reversible. Only solution was to mirror the two diagonal holes of each bit. But one of them was coliding with hotswap socket footprint. Until...
    - I also realised that having the holes at these Y positions made the screw coming on top collide with the bottom of the switch housing...
    - So switched to having two holes right in between each bit (vertically).
    - Then I realised cheap pcb houses can have quite some limitations when it comes to exotic uses of slots. In particular, for jlcpcb:
    * They prefer tabs to be >= 4mm wide
    * They prefer at least 3mm of PCB next to a slot (ie. avoid slim inter-slots parts)
    * They prefer 0.4mm clearence from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
    [KyfleBottomPlate.kicad_pcb, KyfleTopPlate.kicad_pcb, su120.kicad_pcb, su120.sch]
2021-10-26 PCB done. Started redoing the rails.
    - PCB should be in its final version now, pretty much. I hope...
    - I added a tentative compatibility with Panasonic roller encoders.
    - Also added some silk screens for the 2u stabilisers.
    - Propagated the new bit board design to footprints used for top and bottom plate.
    - And started to rework the rails in the bottom plate, as well as the general shape of the keyboard.
    [KyfleBottomPlate.kicad_pcb, KyfleTopPlate.kicad_pcb, su120.kicad_pcb, su120.sch]
2021-10-28 Plates outlines finished
    Redefined the various outlines of the plates based on the new constrains.
    For the top dimension, I took the largest middle-finger stagerring I could find (Elephant42, at +9.5mm) and rounded it to 10mm max amplitude in the middle finger rail, and used that as reference for the position of the top arc (giving 3mm margin above that highest slot).
    And defined the position of the rest from that.
    Top left M% hole might need to be reviewed.
    [KyfleBottomPlate.kicad_pcb, KyfleTopPlate.kicad_pcb]
2021-10-28 Touch ups and small works
    [KyfleBottomPlate.kicad_pcb, KyfleTopPlate.kicad_pcb, su120.kicad_pcb]
2021-10-30 Resized M2 slots and holes to 2mm instead of 2.2mm
    After receiving M2 hardware, I noticed 2mm opening would provide a tighter and less wobbly fit than the typical M2 clearance of 2.2mm.
    Also, finished the silkscreen of bottom plate, as well as M2 holes for encoders in top plate.
    At this point, both top and bottom plate could be considered finished.
    [KyfleBottomPlate.kicad_pcb, KyfleTopPlate.kicad_pcb, su120.kicad_pcb]
2021-10-30 Finalized main PCB
    - After receiving rivets hardware, they are actually not holding onto the pin headers ... M1.1 rivets would be needed, but they are barely available and cost a lot more.
    - So instead of using rivets, we will use female pin headers (the "lowest profile" ones but still widely standard), but using 1.5mm holes such that they sunk into the board more and gets even lower profile (~2.8mm, instead of +4mm)
    - So the pro micro footprint did not change, has it already had 1.5mm holes. But OLED footprint changed for more classic 0.8mm holes as in this case we can use the added thickness of the pin header to offset the OLED board higher up.
    - Also finally routed VCC from pro micro boar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
    [KyfleBottomPlate.kicad_pcb, KyfleTopPlate.kicad_pcb, su120.kicad_pcb, su120.sch]
2021-11-01 It is never done. Adding plethora of plate variants.
    - Variant of the default top plate with less routing involved
    - Variant of a top plate allowing to slide the switches around
    - Variant of that last top plate with less routing involved
    Also moving few minor things here and there.
    [KyfleBottomPlate.kicad_pcb, KyfleTopPlate.kicad_pcb, KyfleTopPlate_LessRouting.kicad_pcb, KyfleTopPlate_Rails.kicad_pcb, KyfleTopPlate_Rails_LessRouting.kicad_pcb, su120.kicad_pcb]
2021-11-01 It's never done, part 2. Making all col/row/led signals accessible on front side
    The had been previously removed to reduce number of drill impacts.
    But if we have access to the these signals also from the front, we can wire the boards from the switch side as well.
    Provide more flexibility, notably when not using any top plate.
    [su120.kicad_pcb]
2021-11-01 Found a solution to hold slightly better the middle "tongue" of board in the top plate with rails
    [KyfleBottomPlate.kicad_pcb, KyfleTopPlate.kicad_pcb, KyfleTopPlate_Rails.kicad_pcb, KyfleTopPlate_Rails_LessRouting.kicad_pcb]
2021-11-03 Plates: Received M2 and M5 hardware. It's bigger than specified...
    - M5 screw head is ~9.5 instead of 8.7. Was colliding in the top left
    corner with M2 screw for pro micro board. So I shifted up pro micro
    board 0.3mm.
    - M2 screw head is also larger than expected (3.8 instead of 3.2). But
    it is mostly fine as I was designing with 4-4.2mm clearance. Only
    exception was for screws supporting the middle bottom section of top
    plate with rails. Here it was colliding with switch housing. So, only
    solution is to use so called reduced slotted screws (DIN 920) as they
    have 2.8mm diameter head.
    - Also added JLCPCB silk reference
    [KyfleBottomPlate.kicad_pcb, KyfleTopPlate.kicad_pcb, KyfleTopPlate_LessRouting.kicad_pcb, KyfleTopPlate_Rails.kicad_pcb, KyfleTopPlate_Rails_LessRouting.kicad_pcb]
2021-11-03 PCB: It's never done, part 3
    - Rotated 90 degrees the lonely 1u at top right to give some more design
    options to user.
    - Made a special footprint for switch module that are used in rotated
    conditions (that new rotated 1u, and also the 2u one).
    - Updated fab for roller encoder to show direction of the roll.
    [su120.kicad_pcb]
2021-11-03 Adding footprint for 5-way switch (panasonic and also compatible Alexpress noname one)
    Not used on PCB yet as I haven't found a suitable position
2021-11-03 It's never... well, at this point it is almost a v17 :D
    - Decided to put the M2 mounting holes on all sides, and not just top-bottom.
    They won't be used in most case (unless I actually figure out they could help in the thumb cluster/row).
    But it allows to freely orient them sideways (ie. 90 deg left or right) for even more flexibility.
    The one switch (top right corner) as well as the encoder bit board that was previously turned 90 degrees will be redone in a future commit once I decide how to integrate the 5-way switch.
    - I made all the holes of the MX switch and their hotswap socket as plated for ground continuation.
    Not only it will mechanically improve them. It will also help with gener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
    [su120.kicad_pcb]
2021-11-04 Tentative routing of the 5-way switch
    Not yet integrated in the main board itself.
    [su120.kicad_pcb, su120.sch]
2021-11-06 Yet another big update
    - Integrated 5-way switch (instead of one of the encoder)
    - Based on corrected footprint for roller encoder, it has been repositioned
    - Touching up lots of silk
    - 2u board made as a footprint module as well
    - Fixed a potential short with 2u stabiliser metal bar on VCC and GND
    - Added various 3d models
    [KyfleBottomPlate.kicad_pcb, su120.kicad_pcb, su120.sch]
2021-11-06 PCB: Adding mouse bites to break away tabs
    And increasing tabs width from 4mm to 5mm.
    [su120.kicad_pcb]
2021-11-08 Adding mouse bites to top plate (rail-less only for now)
    [KyfleBottomPlate.kicad_pcb, KyfleTopPlate_LessRouting.kicad_pcb, su120.kicad_pcb]
2021-11-08 Adding Pimonori trackball footprint (for reference)
2021-11-08 Some PCB touch ups
    - The encoder board could not be mounted when using a roller encoder due to the bulk size of it. The solution was to allow for some extra mounting hole nibbles in the affected corners.
    - Some silks of the modules were not correct
    [KyfleBottomPlate.kicad_pcb, su120.kicad_pcb]
2021-11-08 Adds mouse bites to top plate with rails
    [KyfleTopPlate.kicad_pcb, KyfleTopPlate_Rails_LessRouting.kicad_pcb]
2021-11-08 First attempts at supporting Pimoroni trackball
    Will be further refined once I can take real measurements on them
    [KyfleBottomPlate.kicad_pcb, KyfleTopPlate.kicad_pcb, KyfleTopPlate_LessRouting.kicad_pcb, KyfleTopPlate_Rails_LessRouting.kicad_pcb]
2021-11-10 Updated Pimonori trackball footprint based on real measurements
    Also, checked on a paper print out.
2021-11-11 Massive reorganisation, renaming, and licensing
    Kyfle is now called Lergo
    [KyfleBottomPlate.kicad_pcb, KyfleTopPlate.kicad_pcb, KyfleTopPlate_LessRouting.kicad_pcb, KyfleTopPlate_Rails.kicad_pcb, KyfleTopPlate_Rails_LessRouting.kicad_pcb, Lergo.kicad_pcb, Lergo.sch, LergoBottomPlate.kicad_pcb]
2021-11-11 Pimonori trackball: Put the board outline in bottom courtyard and leave the ball housing outline in front courtyard
2021-11-11 Pimoroni spelling is hard :D
    [LergoTopPlate_LessRouting.kicad_pcb]
2021-11-13 Adding mounting holes in bottom plate for Keeb.io USB-C breakout board
    [LergoBottomPlate.kicad_pcb]
2021-11-13 Integrating Pimoroni trackball in all top plates.
    [LergoTopPlate.kicad_pcb, LergoTopPlate_LessRouting.kicad_pcb, LergoTopPlate_Rails.kicad_pcb, LergoTopPlate_Rails_LessRouting.kicad_pcb]
2021-11-14 Extended silkscreen for roller encoder on all pre-drilled encoder positions.
    Also, doubled the pre-drills rotated 90 degrees for easier mounting of roller encoder in alternate direction.
    [LergoTopPlate.kicad_pcb, LergoTopPlate_LessRouting.kicad_pcb]
2021-11-15 Lergo V1.A, ready for first prototype run
    [Lergo-B_Cu.gbl, Lergo-B_Mask.gbs, Lergo-B_SilkS.gbo, Lergo-Edge_Cuts.gm1, Lergo-F_Cu.gtl, Lergo-F_Mask.gts, Lergo-F_SilkS.gto, Lergo-NPTH-drl_map.gbr]
2021-11-15 Received 5 way switches. Last minute fixes on silk for clarity
    - The no-name 5-way switch is electrically fine. But to avoid confusion with the holes of the top and bottom side (reminder, bottom side is rotated 45 degrees), the corresponding holes on one side have been circled on the side silkscreen.
    - The Panasonic 5-way switch is also electrically fine. But this one does not have any keying holes, and it does not have any pin 1 mark... So, for clarity, the "M" and "A23D" markings on the top of the device have been reproduced in the same location on the silkscreen.
    Hergo, resinding the previous tag of v1.A and making a new one with this commit. The actual first prototype run will contain t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
    [Lergo.kicad_pcb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]
2021-11-16 Fab feedback: Far aluminum, min slot width is 1.6mm and min hole size is 1mm
    JLCPCB aluminum process has different limitations than FR4 apparently.
    They asked to increase slot widths from 1mm to 1.6mm.
    They also cannot take the 0.6mm holes for MX corner radius, or the 0.5mm holes for tab mousebites. So removed the mousebites and used a 1mm drill for MX corners (slightly moved inward to cover the same radius than the 0.3mm cherry specifies.
    [LergoTopPlate_Alu_LessRouting-Edge_Cuts.gm1, LergoTopPlate_Alu_LessRouting-F_Cu.gtl, LergoTopPlate_Alu_LessRouting-F_Mask.gts, LergoTopPlate_Alu_LessRouting-F_SilkS.gto, LergoTopPlate_Alu_LessRouting-NPTH-drl_map.gbr, LergoTopPlate_Alu_LessRouting-NPTH.drl, LergoTopPlate_Alu_LessRouting-PTH-drl_map.gbr, LergoTopPlate_Alu_LessRouting-PTH.drl]
2021-11-17 Following modifications for aluminum PCBs, FR4 and Alu variants are now available
    [LergoTopPlate-B_Cu.gbl, LergoTopPlate-B_Mask.gbs, LergoTopPlate-B_SilkS.gbo, LergoTopPlate-Edge_Cuts.gm1, LergoTopPlate-F_Cu.gtl, LergoTopPlate-F_Mask.gts, LergoTopPlate-F_SilkS.gto, LergoTopPlate-NPTH-drl_map.gbr]
2021-11-17 Fixing some issues in some FR4 top plates found while doing the Alu modifications earlier (not complete yet)
    [LergoTopPlate_FR4_Rails-B_Cu.gbl, LergoTopPlate_FR4_Rails-B_Mask.gbs, LergoTopPlate_FR4_Rails-B_SilkS.gbo, LergoTopPlate_FR4_Rails-Edge_Cuts.gm1, LergoTopPlate_FR4_Rails-F_Cu.gtl, LergoTopPlate_FR4_Rails-F_Mask.gts, LergoTopPlate_FR4_Rails-F_SilkS.gto, LergoTopPlate_FR4_Rails-NPTH-drl_map.gbr]
2021-11-17 Finishing fixing issues in FR4 top plates
    [LergoTopPlate_FR4_Rails_LessRouting-B_Cu.gbl, LergoTopPlate_FR4_Rails_LessRouting-B_Mask.gbs, LergoTopPlate_FR4_Rails_LessRouting-B_SilkS.gbo, LergoTopPlate_FR4_Rails_LessRouting-Edge_Cuts.gm1, LergoTopPlate_FR4_Rails_LessRouting-F_Cu.gtl, LergoTopPlate_FR4_Rails_LessRouting-F_Mask.gts, LergoTopPlate_FR4_Rails_LessRouting-F_SilkS.gto, LergoTopPlate_FR4_Rails_LessRouting-NPTH-drl_map.gbr]
2023-09-25 New keyboard: Handy
    Dumping current state (only ergogen file, WIP).
2023-09-27 Handy: Adding KLE generated output, and first throw at layout
    Layout is a WIP, as it is just imported from my current Lergo setup, but not fully adapted yet.
2023-09-29 Handy: fixing keyholes outline
    [Handy.yaml]
2023-10-01 Scripts: Integrate ergogen as a Docker container
    Streamlines the workflow as the generation of points.yaml and units.yaml is no longer manual.
    Ie. using the Makefile, you can now go from just the ergogen config overlays up to the final results (currently mostly KLE output) in one command.
    [Handy-01-layout.yaml, Handy-02-outlines.yaml, Handy.yaml, points.yaml, units.yaml]
2023-10-03 Bunch of enhancements
    - Now generated coordinates are automatically aligned to top-left corner, with positive Y going down (inverse of ergogen), as this fits most tools. KLE or QMK offsets are no longer needed.
    - Keymap entries are now called legend instead of value.
    - In QMK info.json generation, we now support deleting pre-exsiting entries (that's to purge old fields, or some bogus ones from qmk new-keyboard template).
    - QMK keymap.json generation completed with support for tranparent keycodes, and on-hold layer change (ie. "LT"). It is smart enought to take care of all the little details around using LT correctly.
    AND vvvvvv
    - We can auto generate layout in .c/.h files!!!!!!
    Right now i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
    [Handy-01-layout.yaml, Handy-02-outlines.yaml]
2023-12-31 Handy: Removing nav cluster, adding outer column
    During layout tests using Lergo keeb, I figured out the nav cluster is actually confusing (beside looking ugly).
    So, here it is removed. The keymap is updated to bring back Nav layer (+ some additions to it found with the Lergo tests, like bottom brough back under up on middle finger, home/end on the home row of inner/pinky, Ctrl+left/right under left and right).
    While at it, I also merged Media with Nav layer. Some keys like vol. up/down, or prev/next was added around the nav keys following similar logic. Mute and stop have been reshuffled around in the thumb cluster to keep backspace and delete free when using Nav layer.
    NB: Key position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
2024-01-04 Finally, can manipulate KiCad files!
    That's a fat one.
    We now have a way to read, parse, and deeply reify KiCad files using S-Expr format.
    But also re-export (ie. serialise) back into S-Expr text, striving for minimal formatting changes.
    The first implemented tokens are for .kicad_pcb and .kicad_mod files, supporting the simplest items.
    And the first usage is for taking the ergogen output in the form of (old) .kicad_pcb, convert them to newer format (including trigonometric recalculations for arc items), then convert all the graphic items generated to ergogen into a footprint, that is then exported into a library.
    The code is ... voluminous, and far from being trivial. But it has great pot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
    [empty-paper-portrait.kicad_pcb, empty-paper-user.kicad_pcb, empty.kicad_pcb, ergogen-outline-generated.kicad_pcb, only-edges.kicad_pcb]
2024-01-05 Handy: Starting to streamline KiCad generated parts
    Here is implemented the PCB outline footprint generation.
    As a side effect, we also ensure that fp-lib-table KiCad project file includes an Ergogen.pretty footprint library.
    [Handy-PCB-outline.kicad_pcb, Handy-PCB.kicad_pcb, Handy-PCB.kicad_sch]
2024-01-05 KiCad: Adds tests for .kicad_mod parsing
2024-01-05 KiCad: Supporting footprints in PCB
    [ergogen-outline-as-footprint.kicad_pcb]
2024-01-05 KiCad: Avoids changing only tstamp when updating footprint without changes
2024-01-05 KiCad: Easier API to parse/export
2024-01-05 KiCad/Handy: Can add/update footprint on PCB
    [Handy-PCB.kicad_pcb]
2024-01-06 Kicad, footprints: Supports fp_circle, fp_poly, pad, and model token
    Test with a fairly complex footprint.
    Lotssss of underlaying modifications to make it work.
2024-01-06 KiCad, tests: Make use of the py fixture loader to drasticaly reduce line numbers in parser test file
2024-01-06 Kicad: Significant reduction in verbosity when declaring fields
2024-01-08 KiCad/Handy: Placing/updating keys' footprints on PCB
    [Handy-PCB.kicad_pcb]
2024-01-08 Handy: Small adjustments to angled keys proximity to each other
    [Handy-PCB.kicad_pcb]
2024-01-14 Handy: Proper case implementation
    Since there is now "preprocessin" capabilities added to ergogen by keebs.py script, it can now calculate precisely some of the difficult points (usually corners) that are defined by intersection and/or tangential logic of placement.
    Tenting holes have been added as well, with an option for the "inner" top tenting screw being either near the middle (to be parallel to the right edge) or all the way to the left (vertically aligned with the bottom left one), like it is on Lergo. Will see on first prototype how the stability goes for either solution.
    Also cleaned up a bit all the outlines, added premises of components, starting with promicro, oled screen and te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
    [Handy-01-layout.yaml, Handy-02-fabrication.yaml, Handy.yaml, points.yaml, units.yaml]
2024-01-14 Handy: Minor fixes here and there
    [Handy-02-fabrication.yaml]
2024-01-15 KiCad: Fixes issue with arcs expressed with an angle > 360
    Ergogen does that?!
2024-01-15 KiCad, tests: Fixes tests not passing because of kicad inconsistencies
2024-01-15 Kicad: Fixes for ergogen generating zero length items
2024-01-15 Kicad: Fixes for footprint having desr and tags
2024-01-15 Handy: Finally generating a proper outline
    [Handy-PCB.kicad_pcb, Handy-case.kicad_pcb]
2024-01-28 KiCad: TONS of speed optimisations
2024-01-28 KiCad: Implementing a current parsing context stack
    It can be used by token classes to "specify" some of their behaviour during parsing.
    It should finally be the foundation of a fix for the various KiCad tokens that have the same name but not the same format... (eg. layer).
2024-01-28 KiCad: Changing the SExpr parser for something ~15 times faster
2024-01-28 KiCad: Handling weird angle behaviour in pad and fp_text
2024-01-28 KiCad: Adding more flexible newlines control
2024-01-28 KiCad: Adding many new tokens
    - stackup
    - gr_text
    - gr_rect
    - dimension + format + style
    - net in pad
    - hide in footprint model
    - segment (ie. tracks!)
    - zone + polygon + filled_polygon + keepout + hatch + connect_pads
    Also update footprint name now.
2024-01-31 Kicad: Nails further issues with angles...
    Despite the special casing done in _angle_normalizer for fp_text and pad, there was still some unnecessary modifications of, eg. 355 to -5.
    This was due to the way footprint are updated: for every item in the model footprint (which usually is built with a 0 degree reference), a new item with angle applied (the one of each particular ref being updated) to fp_texts and pads is made. Then it is *compared* to the existing items we already have on the board. And if the comparison showed they are the same, then the "old" item is used (to avoid unnecessarily changing their tstamp ID).
    Issue was that this new item used for comparison to the old one was ha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
2024-01-31 KiCad: Enhance SExpr parser and document it better
2024-01-31 KiCad: Fixes bug introduced by one speed optimisation
    In case of loading different kicad_pcb files of different versions within the same instance of a script, some versioned token of the wrong version were weirdly used. But if parsing each file independently then it was fine...
    Turns out, the method doing the resolution of versioned token was cached in such a way that if later it was used in the context of a different version, then it was using the cached result from the first time it was used...
    Taking the version context out of that method, and instead passing the current version as an argument to it fixes the issue.
2024-01-31 KiCad: Fixing few minor details discovered while spinning it out on a big (3 MB), real project file
2024-02-04 Kicad: Reorganise token classes declarations such that we can use attrs.resolve_types directly in Token.__init_subclass__.
2024-02-04 Kicad: Introduce progress tracking, for better UX
    NB: Needs Clyo from master
2026-01-21 Initial version of Framework One Key Module
2026-01-22 Framework, OKM: Adding images
2026-01-22 Framework, OKM: Updating views without the solder paste layer
2026-01-22 FW OKM: Reduce aperture to 16.6 mm (was 16.75)
2026-01-23 FW: Adding footprint for A1 input module board
2026-01-24 FW: First throw at Handywork-min layout, a 5x3 adapted to a Framework 16
2026-02-16 Update on the Framework footprints
2026-02-23 Framework: PCB template
    [HandyWork-PCB-LEDs.kicad_sch, HandyWork-PCB-Switches.kicad_sch, HandyWork-PCB.kicad_pcb, HandyWork-PCB.kicad_sch]
2026-02-23 Framework, A1 board footprint: Correction of bottom courtyard
2026-03-01 Framework, A1 PCB footprint: Adds 5x13 grid guidelines + others
    The grid is made of 21x21mm square (so, larger than actual keys). That's intentional to more or less cover the full board with the intended 5x13 matrix.
    It's just guideline placement of where the keys would approximately be to help routing the template PCB.
    Among other changes:
    - Moved the top margin 0.2mm up to match the actual board margin (kicad adds the 0.2mm clearance for project constrains anyway).
    - Courtyards removed to not generate fake DRC errors. Geometry has been moved to user layers.
    - Changed display (hidden) of reference and value fields.
2026-03-01 Framework, One Key Module footprints: various changes
    - Added "OKM" keyword/tag.
    - Reduced bottom courtyard from 19.2mm to 18mm square. This avoid DRC errors when placing keys next to each other.
    - Made the tab slots pins duplicates of pin 2 and 10 (GND).
    - Pulled back the SMD pads by 0.1mm from edge to respect a typical 0.2mm margin from edge from PCB fab houses.
2026-03-01 HandyWork: Updating KiCad PCB template. Now complete.
    [HandyWork-PCB-LEDs.kicad_sch, HandyWork-PCB-Switches.kicad_sch, HandyWork-PCB.kicad_pcb, HandyWork-PCB.kicad_sch]
2026-03-01 Framework: Updating OKM CAD model image with the 0.2mm pullback from edge
2026-03-01 HandyWork: More aggressive pinky splay, and stagger
    The pinky is now more outward, and ~1/2 key more down.
    Only tested in 5x3 + Mods + Nav. Possibly wreck the others until I check/fix them.
    [HandyWork-01-base-layout.yaml, HandyWork-5x3-01b-core-layout.yaml, HandyWork-5x3-with-mods-with-nav.yaml, points.yaml, units.yaml]
2026-03-01 HandyWork: Adding fully routed PCB for 5x3 + Mods + Nav
    [HandyWork-5x3-with-mods-with-nav-PCB-LEDs.kicad_sch, HandyWork-5x3-with-mods-with-nav-PCB-Switches.kicad_sch, HandyWork-5x3-with-mods-with-nav-PCB.kicad_sch]
2026-03-01 Framework A1 board footprint and all HandyWork PCBs: Added silkscreen for the position of magnets
    [HandyWork-PCB.kicad_pcb]
2026-03-02 HandyWork 5x3 + Mods + Nav: Silkscreen update
    Adds delimiters to help placement of foam
2026-03-02 HandyWork 5x3 + Mods + Nav: Adjustements for fabrication outputs
    [HandyWork-5x3-with-mods-with-nav-PCB-LEDs.kicad_sch, HandyWork-5x3-with-mods-with-nav-PCB-Switches.kicad_sch, HandyWork-5x3-with-mods-with-nav-PCB.kicad_sch]
2026-03-02 Framework footprints (OKM, A1 board): remove unnecessary paste layer from pads
2026-03-03 HandyWork: Refactor vias to not use 0.2mm drill in order to be significantly cheaper (~50% for the PCB itself)
    [HandyWork-5x3-with-mods-with-nav-PCB.kicad_sch, HandyWork-PCB.kicad_pcb, HandyWork-PCB.kicad_sch]
2026-03-04 HandyWork: Fixes placement of some components around QFN packages
    Fab house has a 1mm margin to apply around QFN (or QFN like) parts. Few resistors/capacitors were in that margin/courtyard.
    [HandyWork-PCB.kicad_pcb]
2026-03-04 HandyWork: Adding placeholder for production QR code / serial number
    [HandyWork-PCB.kicad_pcb]
2026-03-04 HandyWork (template and 5x3-M-N): Small touches ups, almost ready for prod
    [HandyWork-PCB-LEDs.kicad_sch, HandyWork-PCB-Switches.kicad_sch, HandyWork-PCB.kicad_pcb, HandyWork-PCB.kicad_sch]
2026-03-04 HandyWork 5x3-M-N: Fixing the schematic that got broken by raw copying it from the template
    [HandyWork-5x3-with-mods-with-nav-PCB-LEDs.kicad_sch, HandyWork-5x3-with-mods-with-nav-PCB-Switches.kicad_sch, HandyWork-5x3-with-mods-with-nav-PCB.kicad_sch]
2026-03-04 HandyWork: Harmonise a few things, and add bind points with alu plates
    [HandyWork-5x3-with-mods-with-nav-PCB.kicad_sch, HandyWork-PCB.kicad_pcb, HandyWork-PCB.kicad_sch]
2026-03-04 HandyWork: Adding aluminum plate
    [HandyWork-5x3-AluPlate.kicad_pcb, HandyWork-5x3-AluPlate.kicad_sch, HandyWork-AluPlate.kicad_pcb, HandyWork-AluPlate.kicad_sch, HandyWork-PCB.kicad_pcb]
2026-03-04 HandyWork: Adds "-BOM" suffix to BOM file name
2026-03-04 HandyWork 5x3-M-N: Rename properly the AluPlate project
    [HandyWork-5x3-with-mods-with-nav-AluPlate.kicad_pcb, HandyWork-5x3-with-mods-with-nav-AluPlate.kicad_sch]
2026-03-06 Framework footprint: Update of README for A1 board
2026-03-06 Framework footprint: Switching license to CERN OHL-P
2026-03-06 Framework footprint: Adds proper license notice for upstream OKM STEP file embedded in footprints
2026-03-06 HandyWork 5x3-M-N: Update of the pictures with the latest (final, at least for v1A) PCB
2026-03-13 Handywork: Supporting LEDs in firmware generators
2026-04-09 Framework: Updating OKM main footprint
    First production run has shown some issues.
    - Tab pads:
    - Covered with soldermask on bottom side as well
    - Removed their pad number assignment
    - Reduced them to a minimum size
    - Adds explicit default clearance 0.35mm to match manufacturer recommended limited (you might set it lower if needed, and according to your manufacturer capabilities)
    All these are mainly to avoid shorts between traces that are left behind when breaking the OKMs away of their carrier PCB.
    Also, it turns out the tabs are not meant to be soldered, or even connected to a net. They seem covered by a anti-solder surface treatment as well.
    Since they are not to be used other t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
