AxelVoitier/keebs/(notices)

Notices in the files:
Framework/Kicad templates/PCB/HandyWork-PCB-LEDs.kicad_sch:
CERN Open Hardware Licence Version 2 - Weakly Reciprocal
Framework/Kicad templates/PCB/HandyWork-PCB.kicad_pcb:
Licensed under CERN-OHL-W v2
